PoXiao-Team/CRTC_Smart_Car/README.md

# CRTC_Smart_Car

**破晓战队（PoXiao-Team）· 重庆大学机器人训练大赛 CRTC2026 参赛小车**

四轮麦克纳姆轮底盘 + 前端舵机翻转铲收集机构（**当前过渡：V1 铲 + 塑料箱装载**，见《机械篇》）＋ 阶梯式收纳舱（设计目标）；STM32F103C8T6 主控、DRV8833 驱动、PS2 手柄遥控；视觉采用「虚拟机 Ubuntu 22.04 + ROS2 + OpenCV」+「宿主机 Conda + YOLOv8」双环境方案。**双车方案：1 号车铲子（已实车跑通）、2 号车机械臂（预研）。**

| 关键节点 | 日期 |
| --- | --- |
| 建队 | 2026-09-19 |
| 仓库建立 | 2026-10-10 |
| 实车首次跑通 | 2026-10-14 |
| PCB 原理图冻结 | 2026-10-15 |
| PCB 完成并下单（Gerber 导出） | 2026-10-17 |
| 中期考核视频录制 | 2026-10-18 |
| **中期考核材料截止** | **2026-10-19 24:00** |
| 瑞士轮晋级赛 / 淘汰赛 | 2026-10-24、25、31 / 11-1（手册 V1.6） |

**团队与分工**：破晓战队（PoXiao-Team）

—— 王紫依 队长/机械 ｜ 湛俊锋 电控 ｜ 谭翔珂 电控/硬件 ｜ 刘金昊 视觉 ｜ 蓝朝棣 根据要求灵活调配。

---

## 阅读导航

| 顺序 | 文档 | 内容 | 对象 |
| --- | --- | --- | --- |
| 1 | 本 README | 全景、规范对照、参数与交付状态 | 所有人 |
| 2 | [docs/工程日志.md](docs/工程日志.md) | 主日志：建队至今全部功能的开发历程（功能板块 + 时间线） | 评委 |
| 3 | [docs/机械篇.md](docs/机械篇.md) | 铲子收集机构（V1→V2 迭代）、收纳舱、底盘与行走机构 | 结构设计 |
| 4 | [docs/视觉篇.md](docs/视觉篇.md) | 视觉系统：双环境架构、环境搭建、数据集与训练 | 视觉方案 |
| 5 | [docs/遥控与指令篇.md](docs/遥控与指令篇.md) | 遥控三阶段链路、实际操作手册（PS2 按键 / 铲子示教）、指令协议、失联保护 | 电控设计 |
| 6 | [docs/硬件篇.md](docs/硬件篇.md) | 物资清点、兼容性分析、供电决策、补购清单 | 选型与成本 |
| 7 | [docs/接线规范篇.md](docs/接线规范篇.md) | 面包板 → PCB 电气底稿：引脚表、电源树、网络清单、验收流程 | 接线细节 |
| 8 | [docs/PCB打板篇.md](docs/PCB打板篇.md) | 立创 EDA 打板教程（零基础全流程） | 硬件制作 |
| 9 | [docs/赛事规则解析.md](docs/赛事规则解析.md) | 手册 **V1.6** 规则提取（含 V1.5→V1.6 变更）、工程约束、风险清单 | 规则依据 |
| 10 | [docs/开源项目说明.md](docs/开源项目说明.md) | 开源项目引用、许可证与改动说明 | 合规检查 |
| 附 | [hardware/pcb/README.md](hardware/pcb/README.md) | PCB 设计资料：版本、目录、关键口径 | 硬件制作 |

> 视觉文档自 2026-10-13 起并入 `docs/视觉篇.md`（原 `View-Sense` 分支内容），请在 `docs/` 内查阅，不要再到分支找。

---

## 手册规范对照表

**仓库规范（手册 P10）**

| # | 规范要求 | 我们的做法 | 证据 |
| --- | --- | --- | --- |
| 1 | 仓库名用队伍名称的英文或拼音 | `PoXiao-Team/CRTC_Smart_Car` | 本仓库 |
| 2 | 所有文档放在仓库根目录 `docs/` 下 | 全部 9 篇文档位于 `docs/` | `docs/` 目录树 |
| 3 | 其他目录自解释、一眼看懂；README 给导航与索引 | 本 README 提供阅读导航、参数表与状态表 | 本文件"阅读导航"章 |

**文档规范（手册 P10）**

| # | 规范要求 | 我们的做法 | 证据 |
| --- | --- | --- | --- |
| 1 | 全部文档使用 Markdown 格式 | 9 篇文档均为 `.md` | `docs/` |
| 2 | 内容按机器人设计进度的完成时间点从早到晚 | 《工程日志》按时间从早到晚分板块；分册内按设计顺序 | [docs/工程日志.md](docs/工程日志.md) |
| 3 | 一个机器人功能 = 一个板块 | **功能文档**（《工程日志》及各分册）按"一个功能一个 H2 板块"组织；**资料/教程类分册**（《赛事规则解析》《接线规范篇》《PCB打板篇》《开源项目说明》）按主题章节组织，作为功能板块的依据与支撑 | 各文档标题 |
| 4 | 板块结构：功能名 + 功能描述与开发历程 | 功能板块含「功能描述」「开发历程」两段（资料/教程类分册除外，见上行） | 各文档板块内 ### 小节 |
| 5 | 每篇文档由若干板块组成 | 最短分册（机械篇）含 4 个功能板块 | [docs/机械篇.md](docs/机械篇.md) |
| 6 | 开源项目在文档末尾完整说明 | 独立成篇：《开源项目说明》 | [docs/开源项目说明.md](docs/开源项目说明.md) |

**文档质量标尺（手册 5 分等级对照）**

| # | 标尺要求 | 我们的做法 |
| --- | --- | --- |
| 1 | 不只写"做了什么"，必须写清"为什么这样做" | 关键决策均有选型对比表（如收集机构方案、双环境架构、供电三路线）；难点与排查过程如实记录（机械篇"踩坑"、遥控篇"潜在坑"） |
| 2 | 覆盖"从构思到实现"全过程 | 《工程日志》从建队、方案设计到实车调试的完整时间线 |
| 3 | 未实测内容显式标注 | 全库统一标注 `【待实测】` 与 `【待回填】`；状态用 ✅/🟡/⬜ 三档 |

---

## 技术栈与关键参数

| 类别 | 选型 / 指标 | 状态 |
| --- | --- | --- |
| 底盘 | 四轮麦克纳姆轮（60mm 黄色麦轮 + TT 马达 1:48）＋ 金属折弯底盘，X 形轮组布局 | ✅ 实车跑通（10-14） |
| 收集机构 | 设计：前端舵机翻转铲（V2 弧形滑坡、舵机竖直）＋ 阶梯式收纳舱（目标 12 块）；**当前实物：V1 铲 + 塑料箱装载（临时过渡，3D 打印来不及）** | 🟡 临时过渡装配中（10-18）；V2 铲与成品收纳舱待第二版替换 |
| 主控 | STM32F103C8T6（Micro 焊接款）×2；**固件源码已入库 `firmware/CRTC2026_L1_Fast_Checked/`**（89 项回归测试 PASS） | ✅ 接线完成、实车运行正常 |
| 电机驱动 | DRV8833 红板 ×2（双通道 ×4 电机） | ✅ 实车驱动正常（10-14） |
| 舵机 | SG90 180° ×4（另有 MG995 ×2 待使用【待确认】）；1 号车铲子由 1 个舵机驱动 | ✅ 接线完成、示教-翻铲实车可用（10-17）；**实测行程达不到 180°（略小，具体角度【待实测】）** |
| 遥控 | PS2 无线手柄（已到货）；过渡链路（USB-TTL / HC-05）保留为调试备份 | ✅ 实车连接操控正常（10-14） |
| 视觉 | 虚拟机 Ubuntu 22.04 + ROS2 + OpenCV；宿主机 Conda + YOLOv8（CUDA） | 🟡 软件流程跑通，硬件部署未开始 |
| 供电 | 18650 电池（2 节电池盒）；供电模块额定 ≤7.4V，仅 1 个供电模块；须装官方无线继电器 | 🟡 降压方案（双路 DC-DC：逻辑 5V / 电机 VM 5V）、已实车带载运行；电压参数【待回填】 |
| 硬件载板（PCB） | 自制 V2 底板（100×70mm）：2×DRV8833 + 2×DC-DC + 接口全覆盖；立创 EDA 专业版设计 | ✅ 设计完成并已下单支付（10-17，订单 Y1，¥30/5 片，48h 加急）；等板（预计 10-20 ~ 10-22 到货） |
| 第二台车（机械臂） | 舵机机械臂方案（4 舵机 + 抓手，参考资料预研） | ⬜ 预研，未开始制作 |
| 尺寸 | 初始 ≤290×195×210mm；任意状态 ≤445×400×450mm 或 550mm 球体约束 | ⬜ 待实测 |
| 重量 | ≤2.0kg | ⬜ 待实测 |
| 成本 | 新生组整车 ≤400 元（官方物资表合计 353.48 元，**含两车量**：TT×8、底盘×2、PS2×2 等；单车拆分【待回填】） | 🟡 补购清单见硬件篇 |

## 交付与功能状态

状态口径：✅ 已完成（实测通过）｜🟡 进行中·未验证｜⬜ 待做。对照手册 P9 基础功能考核指标：

| 考核功能 | 状态 | 说明 |
| --- | --- | --- |
| 外形展示 | ✅ 已完成 | 10-18 视频：手持整车多角度 + 局部特写（V1 铲 + 塑料箱，临时过渡） |
| 电机运动（单个 / 全部） | ✅ 已完成 | 实车四电机驱动正常（10-14） |
| 舵机运动（单个 / 多项） | 🟡 部分完成 | 单个：示教-翻铲实车可用（10-17）；**多项：未完成——V1.6 要求"同一台机器人至少三个舵机 + 任意非初始状态保持"**，本车仅 1 路舵机（PB7），且 SG90 实测行程不足 180°（脉宽限幅 600~2000 µs）；指标 5 路径：2 号车机械臂 4×舵机（预研）或 1 号车加装 SG90【待定】 |
| 底盘运动（PS2 遥控） | 🟡 部分完成 | 单个动作实车正常（10-14）；**"多个动作"演示镜头未完成**（10-18 视频缺项，待补拍）；指标 6/7"或给出相关代码"路径**已具备：固件源码入库 `firmware/` + 《遥控与指令篇》协议/操作手册** |
| 尺寸规范 | ✅ 已完成 | 10-18 视频：直立卷尺测高 + 地面横放卷尺测长（约 200mm 级）+ 直尺照片；具体数值【待回填】 |
| 方块携带（单块 / 多块） | ✅ 已完成 | 10-18 视频：黄方块铲取 / 携带长镜头（V1 铲 + 塑料箱，临时过渡） |
| 结构稳定性（180mm 跌落） | ✅ 已完成 | 10-18 视频（落地镜头见素材；展示车与其他项目一致） |
| 规划与采购单 | 🟡 进行中 | 选型分析与采购优先级见《硬件篇》；整机成本预算表已建、合计【待回填】 |

---

## 目录结构

```
CRTC_Smart_Car/
├── README.md              # 本文件：导航与总览
├── .gitignore             # 构建产物与临时文件规则
├── docs/                  # 全部文档（手册 P10 要求）
│   ├── 工程日志.md          # 主日志：全部功能的开发历程
│   ├── 机械篇.md            # 机械：铲子机构 / 收纳舱 / 底盘
│   ├── 视觉篇.md            # 视觉系统（虚拟机 + 宿主机双环境）
│   ├── 遥控与指令篇.md      # 电控：遥控链路 / 指令协议 / 失联保护
│   ├── 硬件篇.md            # 物资清点 / 兼容性 / 供电决策 / 补购
│   ├── 接线规范篇.md        # 面包板 → PCB 电气底稿（引脚表 / 网络清单）
│   ├── PCB打板篇.md         # 立创 EDA 打板教程（零基础全流程）
│   ├── 赛事规则解析.md      # 手册 V1.6 规则提取与风险清单
│   └── 开源项目说明.md      # 开源引用、许可证与改动说明
├── hardware/              # 硬件设计资料
│   └── pcb/               # 底板 PCB（版本、目录与口径见该目录 README.md）
│       ├── CRTC2026_SmartCar_BaseBoard_V2/  # 当前版本：sch / pcb / panel / gerber（16 文件包）
│       ├── CRTC2026_SmartCar_BaseBoard_V1/  # 历史版本（原理图冻结、布局弃用）
│       ├── design/                          # V1 设计数据源脚本 + out/ 8 个产物
│       ├── CRTC.elib                        # 自建元件库
│       └── V2设计方案-实物对照版.html        # V2 设计依据（10-16 审查版）
└── firmware/              # 嵌入式固件（STM32F103C8T6）
    └── CRTC2026_L1_Fast_Checked/  # CubeIDE 工程：Core 源码 + tests（89 项回归）+ BUILD_INFO
```

## 外部资料与入库规划

机械 CAD、3D 打印件、立创 EDA 工程等大体积资料暂不在本仓库，引用路径与入库规划如下：

| 资料 | 当前位置 | 规划 |
| --- | --- | --- |
| 立创 EDA 工程与设计产物（原理图 / PCB / 面板 / BOM / 网表） | ✅ 已入库 `hardware/pcb/`（**25 个文件，约 4MB**，2026-10-18 复核：V2 工程 + Gerber、V1 设计产物与脚本、V2 设计依据 HTML） | 随设计更新继续提交 |
| 机械 CAD（Fusion 360）与打印件 STL/STEP | 机械组本地（未入库） | 入库 `hardware/cad/`、`hardware/prints/`；大文件用 Git LFS 或 Release 附件外链 |
| 3D 打印件照片、实物测量照片 | 待拍摄（未入库） | 入库 `hardware/photos/`（照片压缩后体积小，可直接入库） |
| 视觉数据集与模型权重 | 开发机本地（未入库） | 权重 `best.pt` 建议随「模型发布说明」外链，数据集不入库 |

> 大二进制文件（>10MB）一律不进 Git 历史；确需入库时使用 Git LFS。`.gitignore` 已管住构建产物、训练输出与临时文件。

## 中期考核提交要求（备忘）

- 截止：**2026-10-19 24:00**（北京时间）；
- 邮件：主题「队伍名称 队长姓名」，正文罗列完成的考核指标 + 本仓库地址；
- 视频：`.mp4`、≥1080p、≥30 帧，打包 `.zip`，命名「实训战队名称 队伍名称 队长姓名」；
- 文档评估占 30%，对照本 README 第一部分自查。

---

> 手册条款对照：本文件满足仓库规范 §1（仓库名）、§3（README 提供导航与索引）；文档规范 §1（Markdown）。
