PoXiao-Team/CRTC_Smart_Car/hardware/pcb/README.md

# hardware/pcb — 底板 PCB 设计

> 自制载板 **CRTC2026_SmartCar_BaseBoard** 的设计资料。目标：STM32 开发板、2×DRV8833 红板、2×DC-DC mini、PS2 接收器、SG90 舵机、马达与电池全部经板载接口连接；消除面包板接触不良、模块可拔换、对齐手册 P7"建议采用集成电路板、纯杜邦线易脱落"的结构规范。

## 版本

| 版本 | 状态 | 说明 |
| --- | --- | --- |
| **V2（当前）** | ✅ 设计完成并已下单（2026-10-17） | 板框 100×70mm；原理图 + PCB + Gerber 齐全；等板中 |
| V1（历史） | 🗄 已归档 | 2026-10-15 原理图冻结（22 元件 / 29 网络）；布局阶段受阻后转 V2（原因见《工程日志》"硬件打板与 PCB 设计"板块） |

## 目录

| 路径 | 内容 |
| --- | --- |
| `CRTC2026_SmartCar_BaseBoard_V2/` | V2 立创 EDA 工程（原理图 / PCB / 面板）+ `gerber/Gerber_PCB1_2026-10-17.zip`（16 文件：铜箔/丝印/阻焊/板框/钻孔/飞针测试） |
| `CRTC2026_SmartCar_BaseBoard_V1/` | V1 立创 EDA 工程（历史版本） |
| `CRTC.elib` | 自建元件库（DRV8833 16 脚 / mini 降压 4 脚 / STM32 核心板 40 脚等符号与封装） |
| `design/` | V1 设计单一数据源脚本与产物：BOM.csv、NETLIST.csv、接线表.md、布局坐标.csv、线宽与电流预算.md、装配核对表.md、施工单.html、ERC报告.txt（**历史口径**：主干 100mil + 补强策略；V2 实际为 1.0mm 主干 + 双面 GND 铺铜，见《工程日志》） |
| `V2设计方案-实物对照版.html` | V2 设计依据存档（12 模块逐脚表 + 29 网总表 + 审查检查单；10-16 审查版，最终取舍以《工程日志》10-17 为准） |
| `*/sch/ · */pcb/ · */panel/` | 立创 EDA 工程子目录（原理图 / PCB / 拼板） |
| 两份 `*/eprj3-intro.md` | 立创 EDA 上游格式说明（两份内容相同，无项目信息） |

## 状态（2026-10-18）

- ✅ V2 原理图：DRC 0 错（+5V/VCC 短接、VM 误接、信号配对等 8 项审查问题已全部修正）
- ✅ V2 PCB：板框 **100×70mm**（R3 圆角）+ 4×M3 孔（孔径 3.2 / 外径约 6mm / 距边 3.8mm）；双面铺 GND；**飞线 0、DRC 0**
- ✅ Gerber 导出（2026-10-17 15:23），16 个文件齐全
- ✅ 下单：2026-10-17 16:25（订单 **Y1**，16:27 支付；¥30.00 / 5 片，2 层 / 1.6mm / FR-4 / 1oz / 绿油白字 / 有铅喷锡；48h 免费加急，预计 10-19 晚发货，顺丰电商标快）；等板中
- ⬜ **V2 配套产物缺口**：V2 的 BOM / 网表 / 接线表 / 装配核对表尚未生成（`design/` 产物为 **V1 历史口径**，含 J2–J5、C1–C6、92×72，**收板装配不可照抄**）；收板前核对按《接线规范篇》§7 + V2设计方案 HTML 检查单执行；V2 产物待从工程导出后补
- ⬜ 收板后焊接装配（10-20 ~ 10-22，按《接线规范篇》第 7 节流程）

## 关键口径

- VM 设计值 = **5.0V**（DC-DC 电机路输出；设 6V 时电池后半程压差不足会不稳压）
- PB3/PB4 为 JTAG 复用脚：固件须关 JTAG 保 SWD（`__HAL_AFIO_REMAP_SWJ_NOJTAG()`）
- DRV8833 的 STBY 接 B12、不得悬空；TIM1 须使能 MOE；TIM3 禁部分重映射
- V2 取舍：马达线直焊驱动模块输出针（无端子）；本版无去耦电容（装车后视情况补）

## 相关文档

- [docs/接线规范篇.md](../../docs/接线规范篇.md) — 面包板 → PCB 电气底稿（引脚表 / 电源树 / 网络清单 / 上电验收）
- [docs/PCB打板篇.md](../../docs/PCB打板篇.md) — 立创 EDA 零基础全流程教程
- [docs/工程日志.md](../../docs/工程日志.md) — "硬件打板与 PCB 设计（2026-10-15 ~ 10-17）"板块
