PoXiao-Team/CRTC_Smart_Car/hardware/pcb/design/out/线宽与电流预算.md

# 电流预算与走线宽度（CRTC2026_SmartCar_BaseBoard V1）

线宽按 IPC-2221 外层、铜厚 1.0 oz、温升 10℃ 计算；采用值取「常态/峰值两者较大」、向上取整到 10mil、不低于板级最小线宽 10 mil，并封顶 100 mil（单根走线的实用上限）。

| 网络 | 说明 | 常态(A) | 峰值(A) | 常态线宽(mil) | 峰值线宽(mil) | 采用线宽(mil) | 备注 |
|---|---|---:|---:|---:|---:|---:|---|
| `VBAT` | 电池 → 两块 mini 的输入（全车总电流入口） | 2.00 | 6.50 | 30.8 | 156.5 | **100** | 2S 电池，7.0～8.4V；此网电流 = +5V 路 + VM 路之和 |
| `+5V` | mini#1 输出 → STM32 核心板 5V 脚（核心板 LDO 再出 3.3V 给 PS2） | 0.15 | 0.30 | 0.9 | 2.2 | **10** | 核心板 ≈50mA + PS2 ≈10mA + 余量；不得再挂马达/舵机 |
| `+3V3` | STM32 核心板板载 LDO 输出 → PS2 接收器 VCC | 0.05 | 0.10 | 0.2 | 0.5 | **10** | 核心板 LDO 能力有限（≈300mA），只带 PS2 |
| `VM` | mini#2 输出 → DRV#1/#2 的 VM + 舵机 V + 储能电容 | 2.00 | 5.50 | 30.8 | 124.3 | **100** | 4×TT 马达常态约 1.5A、堵转约 5A，SG90 峰值约 0.5A；mini 模块额定按 1.8A 计 → 常态已贴近上限，见风险 R3 |
| `MOTOR_x` | 单路马达输出（DRV8833 AO/BO → 马达端子） | 0.60 | 1.50 | 5.8 | 20.7 | **30** | 单通道持续 1.0A 以内是安全的；堵转由软件限流保护 |

### 需要补强的网络（峰值超过单根走线实用上限）

- `VBAT`：峰值需 156 mil 单线（超出实用上限），改用：铺铜区域 + 双面并走（每层 100 mil）+ 大电流段开窗加锡，等效截面积 ≥ 215 mil²
- `VM`：峰值需 124 mil 单线（超出实用上限），改用：铺铜区域 + 双面并走（每层 100 mil）+ 大电流段开窗加锡，等效截面积 ≥ 171 mil²

## 执行要点

1. `VM` / `VBAT` / `GND` 三根主干按上表**采用线宽**走（100 mil），双面并行 + 过孔缝合；换层处至少 4 个过孔。
2. 上表中需要补强的网络，按「铺铜区域 + 双面并走 + 大电流段开窗加锡」处理，不要试图用一根 100 mil 以上的单线硬扛。
3. 马达输出走线不低于 30 mil（单路峰值 1.5A）。
4. 信号线（8 路 PWM、PS2、舵机、STBY）按板级最小线宽 10 mil 起步，同组信号平行等距、不与功率线混行。
5. 拐角一律 45°，禁止直角；焊盘与走线连接处加泪滴；顶底层均铺 GND 铜，间距 8 mil，孤岛必须处理。

## 风险 R3：VM 路供电能力

mini 降压模块额定按 1.8A 计；VM 路常态 2.0A、峰值 5.5A。

- **对策 A（推荐）**：mini#2 换成持续输出 ≥3A 的降压模块（成本增加约 5～10 元）；
- **对策 B**：舵机改由第三块 mini（或核心板 5V 经独立 5V 稳压）供电；
- **对策 C**：软件限流（启动缓升、堵转检测降占空比）+ C1/C2 储能电容（已设计进本版）；
- 三策可叠加。（历史记录：V1 阶段要求“在选型确认前不要下单”整板；**V2 已于 10-17 完成选型取舍并下单——订单 Y1**，见《工程日志》。）
