PoXiao-Team/CRTC_Smart_Car/hardware/pcb/design/out/接线表.md

# CRTC2026_SmartCar_BaseBoard V1 · 接线表（引脚级）

> 本表由 `crtc_baseboard_v1.py` 自动生成，改动请改源文件后重跑，不要手改本表。
> 原理图连线与网络命名**全部照抄**本表；同名即同网，拼错一个字就是一条断线。

## 0. 板级参数

| 项 | 值 |
|---|---|
| 板框 | 92 × 72 mm（圆角 R3） |
| 层数 / 板厚 / 铜厚 | 2 层 / 1.6mm / 1.0 oz |
| 最小线宽 / 过孔 | 10 mil / 24-12 mil |
| 丝印 | 线宽 6 mil，字高 45 mil |
| 安装孔 | M3，孔径 3.2mm，四角 |
| 铺铜 | 顶层 + 底层全铺 GND，间距 8 mil |

## 1. 按模块接线

### J1 · 电池/继电器输入端子

- 封装：`KF301-2P`　做法：板边，接线口朝板外

| 引脚 | 网络 | 说明 |
|---|---|---|
| BAT+ | `VBAT` | 电池正（经官方无线继电器）→ 两块 mini 输入；7.0～8.4V |
| BAT- | `GND` | 全板唯一地网（不得出现 VSS / GNDA / AGND 等别名）；铺铜网络 |

### U1 · mini 降压模块 #1（+5V 路）

- 封装：`1x4 排母 2.54mm`　做法：排母插座；模块为四角焊盘（2×2，无插针），用 4 根短线焊到排母上进行连接

| 引脚 | 网络 | 说明 |
|---|---|---|
| IN+ | `VBAT` | 电池正（经官方无线继电器）→ 两块 mini 输入；7.0～8.4V |
| IN- | `GND` | 全板唯一地网（不得出现 VSS / GNDA / AGND 等别名）；铺铜网络 |
| OUT+ | `+5V` | 只给核心板与调试口，禁止挂马达/舵机 |
| OUT- | `GND` | 全板唯一地网（不得出现 VSS / GNDA / AGND 等别名）；铺铜网络 |

### U2 · mini 降压模块 #2（VM 路）

- 封装：`1x4 排母 2.54mm`　做法：排母插座；模块为四角焊盘（2×2，无插针），用 4 根短线焊到排母上进行连接

| 引脚 | 网络 | 说明 |
|---|---|---|
| IN+ | `VBAT` | 电池正（经官方无线继电器）→ 两块 mini 输入；7.0～8.4V |
| IN- | `GND` | 全板唯一地网（不得出现 VSS / GNDA / AGND 等别名）；铺铜网络 |
| OUT+ | `VM` | mini#2 输出 5.0V；严禁与 VBAT 有任何连接；走线按最宽处理 |
| OUT- | `GND` | 全板唯一地网（不得出现 VSS / GNDA / AGND 等别名）；铺铜网络 |

### U3A · STM32 核心板排母 · 左列（20 脚，自上而下）

- 封装：`1x20 排母 2.54mm`　做法：排母插座，核心板直插；1 号脚靠 USB 端

| 脚号 | 丝印 | 网络 | 说明 |
|---|---|---|---|
| 1 | B12 | `DRV_STBY` | 三点同网；高电平使能，内部 500kΩ 下拉 → MCU 未初始化时电机不转（安全） |
| 2 | B13 | `—` | 不连接（NC，悬空） |
| 3 | B14 | `—` | 不连接（NC，悬空） |
| 4 | B15 | `—` | 不连接（NC，悬空） |
| 5 | A8 | `DRV_F_AIN2` | TIM1_CH1；PA8（TIM1 必须开 MOE 才有输出） |
| 6 | A9 | `DRV_F_BIN2` | TIM1_CH2；PA9 |
| 7 | A10 | `DRV_R_AIN2` | TIM1_CH3；PA10 |
| 8 | A11 | `DRV_R_BIN2` | TIM1_CH4；PA11 |
| 9 | A12 | `—` | 不连接（NC，悬空） |
| 10 | A15 | `—` | 不连接（NC，悬空） |
| 11 | B3 | `PS2_CS` | PB3 默认 JTAG(JTDO)，必须关 JTAG 保 SWD 才能当普通 IO |
| 12 | B4 | `PS2_CLK` | PB4 默认 JTAG(NJTRST)，同上；且必须禁用 TIM3 部分重映射 |
| 13 | B5 | `PS2_CMD` | 软件 SPI，主出 |
| 14 | B6 | `PS2_DAT` | 软件 SPI，主入 |
| 15 | B7 | `SRV_PWM` | TIM4_CH2，50Hz（周期 20ms，脉宽 0.5～2.5ms） |
| 16 | B8 | `—` | 不连接（NC，悬空） |
| 17 | B9 | `—` | 不连接（NC，悬空） |
| 18 | 5V | `+5V` | 只给核心板与调试口，禁止挂马达/舵机 |
| 19 | G | `GND` | 全板唯一地网（不得出现 VSS / GNDA / AGND 等别名）；铺铜网络 |
| 20 | 3V3 | `+3V3` | 由核心板板载 LDO 提供，只带 PS2 接收器 |

- 不连接（NC）脚：B13, B14, B15, A12, A15, B8, B9 —— 实物左列自上而下：B12、B13、B14、B15、A8、A9、A10、A11、A12、A15、B3、B4、B5、B6、B7、B8、B9、5V、G、3.3 —— 丝印缩略名 B12=PB12、A8=PA8；B3/B4 是 JTAG 复用脚（固件须关 JTAG 保 SWD）

### U3B · STM32 核心板排母 · 右列（20 脚，自上而下）

- 封装：`1x20 排母 2.54mm`　做法：排母插座，核心板直插；1 号脚靠 USB 端

| 脚号 | 丝印 | 网络 | 说明 |
|---|---|---|---|
| 1 | G1 | `GND` | 全板唯一地网（不得出现 VSS / GNDA / AGND 等别名）；铺铜网络 |
| 2 | G2 | `GND` | 全板唯一地网（不得出现 VSS / GNDA / AGND 等别名）；铺铜网络 |
| 3 | 3V3 | `+3V3` | 由核心板板载 LDO 提供，只带 PS2 接收器 |
| 4 | RES | `—` | 不连接（NC，悬空） |
| 5 | B11 | `—` | 不连接（NC，悬空） |
| 6 | B10 | `—` | 不连接（NC，悬空） |
| 7 | B1 | `DRV_R_BIN1` | TIM3_CH4；PB1 |
| 8 | B0 | `DRV_R_AIN1` | TIM3_CH3；PB0 |
| 9 | A7 | `DRV_F_BIN1` | TIM3_CH2；PA7 |
| 10 | A6 | `DRV_F_AIN1` | TIM3_CH1；PA6 |
| 11 | A5 | `—` | 不连接（NC，悬空） |
| 12 | A4 | `—` | 不连接（NC，悬空） |
| 13 | A3 | `DBG_RX` | USART2_RX |
| 14 | A2 | `DBG_TX` | USART2_TX |
| 15 | A1 | `—` | 不连接（NC，悬空） |
| 16 | A0 | `—` | 不连接（NC，悬空） |
| 17 | C15 | `—` | 不连接（NC，悬空） |
| 18 | C14 | `—` | 不连接（NC，悬空） |
| 19 | C13 | `—` | 不连接（NC，悬空） |
| 20 | VB | `—` | 不连接（NC，悬空） |

- 不连接（NC）脚：RES, B11, B10, A5, A4, A1, A0, C15, C14, C13, VB —— 实物右列自上而下：G、G、3.3、RES、B11、B10、B1、B0、A7、A6、A5、A4、A3、A2、A1、A0、C15、C14、C13、VB —— RES 为复位脚、VB 为 VBAT 脚，本设计均不接；两处 G 都要接 GND

### U4A · DRV8833 #1 模块座 · 左列（控制/使能侧）

- 封装：`1x8 排母 2.54mm`　做法：排母插座，模块直插；与 U4B 平行，列距按实测（默认 10.16mm）

| 脚号 | 丝印 | 网络 | 说明 |
|---|---|---|---|
| 1 | NC1 | `—` | 不连接（NC，悬空） |
| 2 | AIN2 | `DRV_F_AIN2` | TIM1_CH1；PA8（TIM1 必须开 MOE 才有输出） |
| 3 | AIN1 | `DRV_F_AIN1` | TIM3_CH1；PA6 |
| 4 | STBY | `DRV_STBY` | 三点同网；高电平使能，内部 500kΩ 下拉 → MCU 未初始化时电机不转（安全） |
| 5 | BIN1 | `DRV_F_BIN1` | TIM3_CH2；PA7 |
| 6 | BIN2 | `DRV_F_BIN2` | TIM1_CH2；PA9 |
| 7 | NC2 | `—` | 不连接（NC，悬空） |
| 8 | GND1 | `GND` | 全板唯一地网（不得出现 VSS / GNDA / AGND 等别名）；铺铜网络 |

- 不连接（NC）脚：NC1, NC2 —— 实物左列自上而下：NC、AIN2、AIN1、STBY、BIN1、BIN2、NC、GND —— 两个 NC 脚（第 1、7 位）悬空不接；第 8 位 GND 必须接 GND 网

### U4B · DRV8833 #1 模块座 · 右列（电源/输出侧）

- 封装：`1x8 排母 2.54mm`　做法：排母插座，模块直插；VM 与两处 GND 都要接（大电流）

| 脚号 | 丝印 | 网络 | 说明 |
|---|---|---|---|
| 1 | VM | `VM` | mini#2 输出 5.0V；严禁与 VBAT 有任何连接；走线按最宽处理 |
| 2 | NC3 | `—` | 不连接（NC，悬空） |
| 3 | GND2 | `GND` | 全板唯一地网（不得出现 VSS / GNDA / AGND 等别名）；铺铜网络 |
| 4 | AO1 | `MOTOR_FL_1` | 左前马达脚 1 |
| 5 | AO2 | `MOTOR_FL_2` | 左前马达脚 2 |
| 6 | BO2 | `MOTOR_FR_2` | 右前马达脚 2 |
| 7 | BO1 | `MOTOR_FR_1` | 右前马达脚 1 |
| 8 | GND3 | `GND` | 全板唯一地网（不得出现 VSS / GNDA / AGND 等别名）；铺铜网络 |

- 不连接（NC）脚：NC3 —— 实物右列自上而下：VM、NC、GND、AO1、AO2、BO2、BO1、GND —— 注意 BO2 在 BO1 **上方**；VM 单脚要并线加粗，两处 GND 都接到 GND 网

### U5A · DRV8833 #2 模块座 · 左列（控制/使能侧）

- 封装：`1x8 排母 2.54mm`　做法：排母插座，模块直插；与 U5B 平行，列距按实测（默认 10.16mm）

| 脚号 | 丝印 | 网络 | 说明 |
|---|---|---|---|
| 1 | NC1 | `—` | 不连接（NC，悬空） |
| 2 | AIN2 | `DRV_R_AIN2` | TIM1_CH3；PA10 |
| 3 | AIN1 | `DRV_R_AIN1` | TIM3_CH3；PB0 |
| 4 | STBY | `DRV_STBY` | 三点同网；高电平使能，内部 500kΩ 下拉 → MCU 未初始化时电机不转（安全） |
| 5 | BIN1 | `DRV_R_BIN1` | TIM3_CH4；PB1 |
| 6 | BIN2 | `DRV_R_BIN2` | TIM1_CH4；PA11 |
| 7 | NC2 | `—` | 不连接（NC，悬空） |
| 8 | GND1 | `GND` | 全板唯一地网（不得出现 VSS / GNDA / AGND 等别名）；铺铜网络 |

- 不连接（NC）脚：NC1, NC2 —— 同 U4A；模块丝印可能是 STBY 或 SLP，都接 DRV_STBY

### U5B · DRV8833 #2 模块座 · 右列（电源/输出侧）

- 封装：`1x8 排母 2.54mm`　做法：排母插座，模块直插；VM 与两处 GND 都要接

| 脚号 | 丝印 | 网络 | 说明 |
|---|---|---|---|
| 1 | VM | `VM` | mini#2 输出 5.0V；严禁与 VBAT 有任何连接；走线按最宽处理 |
| 2 | NC3 | `—` | 不连接（NC，悬空） |
| 3 | GND2 | `GND` | 全板唯一地网（不得出现 VSS / GNDA / AGND 等别名）；铺铜网络 |
| 4 | AO1 | `MOTOR_RL_1` | 左后马达脚 1 |
| 5 | AO2 | `MOTOR_RL_2` | 左后马达脚 2 |
| 6 | BO2 | `MOTOR_RR_1` | 右后马达脚 1（镜像接法：接 BO2） |
| 7 | BO1 | `MOTOR_RR_2` | 右后马达脚 2（镜像接法：接 BO1） |
| 8 | GND3 | `GND` | 全板唯一地网（不得出现 VSS / GNDA / AGND 等别名）；铺铜网络 |

- 不连接（NC）脚：NC3 —— 同 U4B；BO1/BO2 到端子的接法见 MOTOR_RR_1/_2（镜像）

### C1 · VM 储能电容 #1（紧贴 U4）

- 封装：`CAP-TH_D6.3xH11.0_P2.50`　做法：直插，紧贴 U4 的 VM-GND，丝印画 +

| 引脚 | 网络 | 说明 |
|---|---|---|
| + | `VM` | mini#2 输出 5.0V；严禁与 VBAT 有任何连接；走线按最宽处理 |
| - | `GND` | 全板唯一地网（不得出现 VSS / GNDA / AGND 等别名）；铺铜网络 |

### C2 · VM 储能电容 #2（紧贴 U5）

- 封装：`CAP-TH_D6.3xH11.0_P2.50`　做法：直插，紧贴 U5 的 VM-GND，丝印画 +

| 引脚 | 网络 | 说明 |
|---|---|---|
| + | `VM` | mini#2 输出 5.0V；严禁与 VBAT 有任何连接；走线按最宽处理 |
| - | `GND` | 全板唯一地网（不得出现 VSS / GNDA / AGND 等别名）；铺铜网络 |

### C3 · +5V 输出滤波电容

- 封装：`CAP-TH_D5.0xH11.0_P2.00`　做法：直插，靠近 U1 的 OUT+ / OUT-

| 引脚 | 网络 | 说明 |
|---|---|---|
| + | `+5V` | 只给核心板与调试口，禁止挂马达/舵机 |
| - | `GND` | 全板唯一地网（不得出现 VSS / GNDA / AGND 等别名）；铺铜网络 |

### C4 · VM 高频去耦电容

- 封装：`CAP-TH_D4.3xH11.0_P5.08`　做法：直插，跨在 VM-GND 上（与 C1/C2 并联）

| 引脚 | 网络 | 说明 |
|---|---|---|
| 1 | `VM` | mini#2 输出 5.0V；严禁与 VBAT 有任何连接；走线按最宽处理 |
| 2 | `GND` | 全板唯一地网（不得出现 VSS / GNDA / AGND 等别名）；铺铜网络 |

### C5 · +5V 高频去耦电容

- 封装：`CAP-TH_D4.3xH11.0_P5.08`　做法：直插，跨在 +5V-GND 上

| 引脚 | 网络 | 说明 |
|---|---|---|
| 1 | `+5V` | 只给核心板与调试口，禁止挂马达/舵机 |
| 2 | `GND` | 全板唯一地网（不得出现 VSS / GNDA / AGND 等别名）；铺铜网络 |

### C6 · VBAT 输入储能电容

- 封装：`CAP-TH_D6.3xH11.0_P2.50`　做法：直插，靠近 J1 与两块 mini 的 IN

| 引脚 | 网络 | 说明 |
|---|---|---|
| + | `VBAT` | 电池正（经官方无线继电器）→ 两块 mini 输入；7.0～8.4V |
| - | `GND` | 全板唯一地网（不得出现 VSS / GNDA / AGND 等别名）；铺铜网络 |

### J2 · 左前马达端子 FL

- 封装：`KF301-2P`　做法：板下边缘，接线口朝板外

| 引脚 | 网络 | 说明 |
|---|---|---|
| 1 | `MOTOR_FL_1` | 左前马达脚 1 |
| 2 | `MOTOR_FL_2` | 左前马达脚 2 |

### J3 · 右前马达端子 FR

- 封装：`KF301-2P`　做法：板下边缘，接线口朝板外

| 引脚 | 网络 | 说明 |
|---|---|---|
| 1 | `MOTOR_FR_1` | 右前马达脚 1 |
| 2 | `MOTOR_FR_2` | 右前马达脚 2 |

### J4 · 左后马达端子 RL

- 封装：`KF301-2P`　做法：板下边缘，接线口朝板外

| 引脚 | 网络 | 说明 |
|---|---|---|
| 1 | `MOTOR_RL_1` | 左后马达脚 1 |
| 2 | `MOTOR_RL_2` | 左后马达脚 2 |

### J5 · 右后马达端子 RR

- 封装：`KF301-2P`　做法：板下边缘，接线口朝板外

| 引脚 | 网络 | 说明 |
|---|---|---|
| 1 | `MOTOR_RR_1` | 右后马达脚 1（镜像接法：接 BO2） |
| 2 | `MOTOR_RR_2` | 右后马达脚 2（镜像接法：接 BO1） |

### J6 · 舵机接口 SG90

- 封装：`HDR-TH_1x3_P2.54`　做法：板右边缘，针朝上；杜邦线直插

| 脚号 | 丝印 | 网络 | 说明 |
|---|---|---|---|
| 1 | S | `SRV_PWM` | TIM4_CH2，50Hz（周期 20ms，脉宽 0.5～2.5ms） |
| 2 | V | `VM` | mini#2 输出 5.0V；严禁与 VBAT 有任何连接；走线按最宽处理 |
| 3 | G | `GND` | 全板唯一地网（不得出现 VSS / GNDA / AGND 等别名）；铺铜网络 |

### J7 · PS2 接收器接口

- 封装：`HDR-TH_1x6_P2.54`　做法：板右边缘，针朝上

| 脚号 | 丝印 | 网络 | 说明 |
|---|---|---|---|
| 1 | CS | `PS2_CS` | PB3 默认 JTAG(JTDO)，必须关 JTAG 保 SWD 才能当普通 IO |
| 2 | CMD | `PS2_CMD` | 软件 SPI，主出 |
| 3 | DAT | `PS2_DAT` | 软件 SPI，主入 |
| 4 | CLK | `PS2_CLK` | PB4 默认 JTAG(NJTRST)，同上；且必须禁用 TIM3 部分重映射 |
| 5 | VCC | `+3V3` | 由核心板板载 LDO 提供，只带 PS2 接收器 |
| 6 | GND | `GND` | 全板唯一地网（不得出现 VSS / GNDA / AGND 等别名）；铺铜网络 |

### J8 · 调试扩展口（USART2）

- 封装：`HDR-TH_1x4_P2.54`　做法：板右边缘，针朝上

| 脚号 | 丝印 | 网络 | 说明 |
|---|---|---|---|
| 1 | TX | `DBG_TX` | USART2_TX |
| 2 | RX | `DBG_RX` | USART2_RX |
| 3 | +5V | `+5V` | 只给核心板与调试口，禁止挂马达/舵机 |
| 4 | GND | `GND` | 全板唯一地网（不得出现 VSS / GNDA / AGND 等别名）；铺铜网络 |

## 2. 按网络反查

| 网络 | 类别 | 端点 | 建议线宽 | 说明 |
|---|---|---|---|---|
| `VBAT` | 电源 | J1.BAT+、U1.IN+、U2.IN+、C6.+ | 100 mil | 电池正（经官方无线继电器）→ 两块 mini 输入；7.0～8.4V；峰值需 156 mil 单线（超出实用上限），改用：铺铜区域 + 双面并走（每层 100 mil）+ 大电流段开窗加锡，等效截面积 ≥ 215 mil² |
| `GND` | 电源 | J1.BAT-、U1.IN-、U1.OUT-、U2.IN-、U2.OUT-、U3A.G、U3B.G1、U3B.G2、U4A.GND1、U4B.GND2、U4B.GND3、U5A.GND1、U5B.GND2、U5B.GND3、C1.-、C2.-、C3.-、C4.2、C5.2、C6.-、J6.G、J7.GND、J8.GND | 100 mil | 全板唯一地网（不得出现 VSS / GNDA / AGND 等别名）；铺铜网络；峰值需 156 mil 单线（超出实用上限），改用：铺铜区域 + 双面并走（每层 100 mil）+ 大电流段开窗加锡，等效截面积 ≥ 215 mil² |
| `+5V` | 电源 | U1.OUT+、U3A.5V、C3.+、C5.1、J8.+5V | 10 mil | 只给核心板与调试口，禁止挂马达/舵机 |
| `+3V3` | 电源 | U3A.3V3、U3B.3V3、J7.VCC | 10 mil | 由核心板板载 LDO 提供，只带 PS2 接收器 |
| `VM` | 电源 | U2.OUT+、U4B.VM、U5B.VM、J6.V、C1.+、C2.+、C4.1 | 100 mil | mini#2 输出 5.0V；严禁与 VBAT 有任何连接；走线按最宽处理；峰值需 124 mil 单线（超出实用上限），改用：铺铜区域 + 双面并走（每层 100 mil）+ 大电流段开窗加锡，等效截面积 ≥ 171 mil² |
| `DRV_F_AIN1` | 信号 | U3B.A6、U4A.AIN1 | 10 mil | TIM3_CH1；PA6 |
| `DRV_F_BIN1` | 信号 | U3B.A7、U4A.BIN1 | 10 mil | TIM3_CH2；PA7 |
| `DRV_F_AIN2` | 信号 | U3A.A8、U4A.AIN2 | 10 mil | TIM1_CH1；PA8（TIM1 必须开 MOE 才有输出） |
| `DRV_F_BIN2` | 信号 | U3A.A9、U4A.BIN2 | 10 mil | TIM1_CH2；PA9 |
| `DRV_R_AIN1` | 信号 | U3B.B0、U5A.AIN1 | 10 mil | TIM3_CH3；PB0 |
| `DRV_R_BIN1` | 信号 | U3B.B1、U5A.BIN1 | 10 mil | TIM3_CH4；PB1 |
| `DRV_R_AIN2` | 信号 | U3A.A10、U5A.AIN2 | 10 mil | TIM1_CH3；PA10 |
| `DRV_R_BIN2` | 信号 | U3A.A11、U5A.BIN2 | 10 mil | TIM1_CH4；PA11 |
| `DRV_STBY` | 信号 | U3A.B12、U4A.STBY、U5A.STBY | 10 mil | 三点同网；高电平使能，内部 500kΩ 下拉 → MCU 未初始化时电机不转（安全） |
| `PS2_DAT` | 信号 | U3A.B6、J7.DAT | 10 mil | 软件 SPI，主入 |
| `PS2_CMD` | 信号 | U3A.B5、J7.CMD | 10 mil | 软件 SPI，主出 |
| `PS2_CS` | 信号 | U3A.B3、J7.CS | 10 mil | PB3 默认 JTAG(JTDO)，必须关 JTAG 保 SWD 才能当普通 IO |
| `PS2_CLK` | 信号 | U3A.B4、J7.CLK | 10 mil | PB4 默认 JTAG(NJTRST)，同上；且必须禁用 TIM3 部分重映射 |
| `SRV_PWM` | 信号 | U3A.B7、J6.S | 10 mil | TIM4_CH2，50Hz（周期 20ms，脉宽 0.5～2.5ms） |
| `DBG_TX` | 信号 | U3B.A2、J8.TX | 10 mil | USART2_TX |
| `DBG_RX` | 信号 | U3B.A3、J8.RX | 10 mil | USART2_RX |
| `MOTOR_FL_1` | 输出 | U4B.AO1、J2.1 | 30 mil | 左前马达脚 1 |
| `MOTOR_FL_2` | 输出 | U4B.AO2、J2.2 | 30 mil | 左前马达脚 2 |
| `MOTOR_FR_1` | 输出 | U4B.BO1、J3.1 | 30 mil | 右前马达脚 1 |
| `MOTOR_FR_2` | 输出 | U4B.BO2、J3.2 | 30 mil | 右前马达脚 2 |
| `MOTOR_RL_1` | 输出 | U5B.AO1、J4.1 | 30 mil | 左后马达脚 1 |
| `MOTOR_RL_2` | 输出 | U5B.AO2、J4.2 | 30 mil | 左后马达脚 2 |
| `MOTOR_RR_1` | 输出 | U5B.BO2、J5.1 | 30 mil | 右后马达脚 1（镜像接法：接 BO2） |
| `MOTOR_RR_2` | 输出 | U5B.BO1、J5.2 | 30 mil | 右后马达脚 2（镜像接法：接 BO1） |
