PoXiao-Team/CRTC_Smart_Car/docs/赛事规则解析.md

# 赛事规则解析

> 破晓战队 CRTC2026 参赛小车规则基线文档。本文为**规则资料篇**：为《工程日志》《机械篇》《视觉篇》《遥控与指令篇》《硬件篇》各功能板块提供规则依据与数据口径；机器人功能板块本身见上述各篇。
> 状态标注约定：✅ 已完成（实测通过）｜🟡 进行中·未验证｜⬜ 待做；未实测内容显式标注【待实测】。

依据《2026CRTC 参赛手册 **V1.6**》（25 页；V1.5 基线，V1.6 差异见 §0）。标注格式为 `P页码/章节号`。手册未明确说明的内容标注为待确认，不自行补充。

---

## 0. 版本变更记录

**V1.6 相对 V1.5**（2026-10-19，依据手册 V1.6 版本记录页）：

| 变更 | V1.5 | V1.6 | 影响 |
| --- | --- | --- | --- |
| 比赛日程（1.5） | 瑞士轮 10-24、25；淘汰赛 10-31 | **瑞士轮 10-24、25、31；淘汰赛 11-1** | 备赛窗口延长一周；本文档赛程已更新 |
| 完成度测评（4.1） | 措辞较含糊 | 补充：外形"携带能量单元"、电机（全部）"不少于 4 个"、舵机（多项）"至少三个舵机 + 任意非初始状态保持"、结构稳定"展示车须与其他项目一致"；4.1.1 措辞勘误 | 指标判据更明确 |
| 进阶功能材料 | 未列材料要求 | **文档材料（描述进阶功能）+ 视频材料（展示）；视频未展示文档所述功能即视为未完成** | 若申报进阶功能须双材料 |
| 测评入口 | 无 | 新增 `https://i.kaoshiyun.com.cn/v5/exam/781c306` | 规则测评走该入口 |
| 淘汰赛规则（5.2） | 平局则加赛至 2 胜 | **平局视为该场双方均失败**；积分 -0.5、进攻方排队尾、防守方积分归零等细则 | 淘汰赛须避免平局 |

## 0.1 V1.5 相对 V1.4 的变更

手册第 21 页更新日志列出 1.5 版改动，其中影响本项目判断的有：

| 变更 | V1.4 | V1.5 | 影响 |
| --- | --- | --- | --- |
| 修正 4.1.2 方块大小 | 写为 40×40×40mm | **30×30×30mm** | V1.4 中 30/40mm 表述不一致的问题解决，确定为 30mm |
| 修改 3.2 遥控器描述 | PS2 手柄，不限自购其他遥控器 | 增加"**或其他控制方案**" | 非 PS2 控制方案被明确允许 |
| 第三章新增开源项目说明 | 无 | 允许使用开源项目，须在中期考核给出完整说明并遵守协议 | 用开源库须在文档末尾说明 |
| 修改 4.3.1 文档规范 | 无 | 使用开源项目的应在文档末尾完整说明 | 文档硬性要求 |
| 更改 4.6 参赛队伍数量 | 新生组前 56 / 非新生组前 8 | 新生组前 **60** / 非新生组前 **4** | — |
| 更改 6.1.7 焦点参数 | 150×150mm 十字基座 | **300×300mm**，矮墙距中心 64.25mm | 焦点附近方块分布范围更大 |
| 新增 2.3.4 培训时间 | 无 | 见下 | — |

统一培训时间（P5/2.3.4）：2026 年 10 月 8、9、10、11 日 19:00–20:40，8、9 日在虎溪 D 区，10、11 日在沙坪坝 A 区。电控组四个板块为 GPIO/PWM、电机与舵机及 FreeRTOS、SPI 与 PS2 手柄、麦轮运动学解算。

开源项目条款原文（P5，V1.5 新增）：

> 将开源项目用于机器人的制作及代码编写是允许的，但必须在中期考核阶段给出完整说明，并遵守所使用开源项目的开源协议。

---

## 1. 比赛任务与目标

| 项目 | 内容 | 依据 |
| --- | --- | --- |
| 赛事性质 | 机器人资源争夺赛 | P2 |
| 核心目标 | 在限定的空间和时间范围内，尽可能多地收集和占有有限的道具资源 | P2 |
| 胜负判定 | 比赛结束时双方道具分数之和高者获胜，相同记为平局 | P2 / P17 |
| 车辆数量 | 每队自行设计开发 1–2 台机器人，可另备不超过 1 台备用机器人 | P2 / P6 |
| 机器人分类 | 一般 / 半自动 / 全自动（全自动需无需操作手且经组委会审查），三类均可参赛 | P6 / 3.1 |
| 得分加成 | 全自动：能量单元 ×2、核心 ×1.5；半自动：×1.5、×1.25 | P17 / P18 |

得分只认比赛结束时仍处携带状态的道具，因此收集机构必须有可靠的锁止或挡板。

---

## 2. 道具（方块）

| 参数 | 数值 | 依据 |
| --- | --- | --- |
| 外部立方体 | 30×30×30mm，12 条棱边 45° 倒角（斜外立面 2.121mm 平面） | P17 / 4.1.2 |
| 内部镂空 | 15×15×15mm | P17 |
| 单个质量 | 约 11.29g | P18 |
| 能量单元（白色） | 18 个，1 分/个 | P17 |
| 能量核心（黄色） | 5 个，4 分/个 | P18 |

能量单元（18 个）分布（P17）：

- a8、h1、c4、f5 地块中心（胶带标记处）；
- e8、d1 台阶几何中心（台阶高 150mm）；
- e8'、d1' 附属高台每组矮墙中心各 1 个；
- d6、e3 台阶内侧四分之一处两个地块几何中心；
- 地图中心轴方向距中心 40mm 处 4 个（矮墙限位处）。

能量核心（5 个）分布（P18）：

- 2 个挂在 e3、d6 的物资架初始端（质心距地 250mm）；
- 2 个位于 d1、e8 台阶下的洞穴内（洞穴开口 70×70×50mm）；
- 1 个位于中央高地平台的焦点中心（焦点总高 70mm）。

### 矮墙对机构选型的影响

手册 P16：

- e8、d1 附属高台上有两组矮墙（每片 10×50×10mm），组内间距 **31.5mm**，组间间距 40mm；
- 焦点周围十字基座每方向两片矮墙（10×60×10mm），间距 **31.5mm**，距中心 64.25mm。

方块 30mm 与矮墙间距 31.5mm 只差 0.75mm/侧，即方块被矮墙限位卡在槽内；矮墙高 10mm，方块露出 20mm。

结论：这类方块不能靠侧推式铲子收集（铲板低于 10mm 会撞矮墙，高于 10mm 顶不过矮墙），只能向上提、夹取或上翻兜住。涉及至少 6 个能量单元（附属高台 2 个 + 焦点周围 4 个）。对中期考核不构成阻塞（中期方块携带在平地演示即可），但影响正式比赛的收集率。

---

## 3. 场地

| 要素 | 参数 | 依据 |
| --- | --- | --- |
| 场地 | 2400×2400mm 正方形，地面覆 6mm 白色地胶 | P15 |
| 坐标系 | 红方视角 a–h（8 列）×1–8（8 行），单位区块 300×300mm | P15 |
| 围挡 | 聚丙烯外包金属框架，上边沿距地面 500mm | P15 |
| 高台 ×6 | 高 300mm；a4、d4、d5、e4、e5、h5 | P16 |
| 台阶 ×4 | 高 150mm；e8、d6、e3、d1；d1 与 e8 台阶下各有 70×70×50mm 向外开口洞穴 | P16 |
| 台阶附属高台 | 高 20mm、长 160mm、宽 50mm；双组矮墙 10×50×10mm，组内间距 31.5mm | P16 |
| 坡道 ×4 | a5+a6、h3+h4（坡高 300mm，坡比 0.5）；e1、d8（坡高 150mm，坡比 0.5）；面板厚 5mm，下方有通行空间 | P16 |
| 桥梁 ×4 | b4、c4、f5、g5；长 300mm、宽 150mm、净高 130mm，矢跨比 0.05 | P16 |
| 启动区 ×4 | a1（红 2 号）、a4（蓝 1 号）、h5（红 1 号）、h8（蓝 2 号） | P16 |
| 物资架 | 直径 14mm、长 150mm 圆柱，平行地面固定在高台侧面，质心距地 250mm | P16 |
| 焦点 | 中央高地上的平台，总高 70mm；300×300mm 十字基座 + 60×60×40mm 方柱 + 80×80×20mm 平台 | P16 |

> 注：a4、h5 同时出现在"高台 ×6"与"启动区"两行，系手册 P16 原文如此（可能为台上启动位）；两者关系未经现场核对【待核实】，以手册原文为准。

---

## 4. 机器人技术规范

| 类别 | 规范 | 依据 |
| --- | --- | --- |
| 初始尺寸 | 长宽 ≤ 290×195mm，高 ≤ 210mm（每局正式开始时） | P6-7 / 3.3.2 |
| 任意状态尺寸 | 长宽高 ≤ 445×400×450mm，或满足直径 550mm 球体约束 | P6 / 3.3.2 |
| 重量 | ≤ 2.0kg | P7 / 3.3.2 |
| 结构强度（检录） | 150–200mm 高处底面朝下自由下落，无零件掉出 | P7 |
| 结构强度（中期指标） | 180mm 自由下落无零件掉出 | P9 |
| 电源 | 指定 18650 电池；每台机器人仅允许 1 个供电模块；供电模块额定电压 ≤ 7.4V | P6 |
| 供电模块定义 | 有且仅有一个输出接口；继电器与电池间有延长/转接线时按离电池最近端计算接口数（**本队解释口径**：两路 DC-DC 属稳压环节、不算第二个供电模块，论证见《接线规范篇》§3；该解释未经组委会书面确认【待核实】） | P6 注 |
| 无线断电 | 必须适配官方指定无线继电器，底盘电源能在 10m 内被单独遥控切断；检录检测，遥控器上交裁判 | P8 |
| 遥控器 | 官方物资表列出 PS2 手柄；不限制使用其他自行购买的遥控器或其他控制方案（V1.5） | P6 / 3.2 |
| 通讯方式 | 蓝牙 / 2.4G / WiFi / 红外，仅可选其中一种；发射源与接收源有且仅有一组 | P6 |
| 物理安全 | 不得携带或装配任何尖锐物体，不得装易致短路、爆炸或具穿刺、破坏功能的装置 | P7 |
| 结构建议 | 建议牢固材料，避免热熔胶；建议采用集成电路板，纯杜邦线易脱落；布线不得过度裸露 | P7 |

对设计的约束：

1. 铲子存在被认定为尖锐物体的风险，前沿须钝化并做大圆角；
2. 初始尺寸 290×195×210mm 很紧，铲子须可收拢或完全在包络内；
3. 供电仅 1 个模块且额定 ≤7.4V，2 节 18650 串联（2S，额定 7.4V）是规则下的上限，不能挂两块电池、不能用 3S；
4. 无线继电器为强制件，无此件无法通过检录。

---

## 5. 成本规范

| 组别 | 规则 | 依据 |
| --- | --- | --- |
| 新生组 | 整机造价不推荐超过 400 元；可自行购买其他物资但须符合赛事规则 | P7-8 |
| 非新生组 | 除紧固件、胶粘剂外，仅限官方物资表内物资 + 自制 PCB + 3D 打印件，数量不限 | P8 |
| 报销 | 总报销不超过 400 元；未通过中期考核不予报销 | P8 |
| 借用 | 可拆卸借用 2025 年回收车辆零部件（不得削减原部件），借件不参与报销 | P8 |
| 3D 打印 | 各实训战队提供打印协助，规范由 GSing 战队发布（待确认） | P8 |
| 禁止 | 严禁直接购买功能成熟的商品机器人或机器人套件；成品 PCB、电压管理等成品模块、视觉套件不在此范围 | P5 |

《CRTC 官方物资表》总计 353.48 元（P22-23）。

---

## 6. 中期考核

| 项目 | 内容 | 依据 |
| --- | --- | --- |
| 提交截止 | **2026-10-19 24:00** | P11 |
| 考核构成 | 完成度考核 : 规则测评 : 文档评估 = 4 : 3 : 3 | P8 |
| 规则测评 | 80 道四选一单选题，每队仅 1 次答题机会，只给分数不给错题 | P10 |
| 文档评估 | 1–5 分等级制，占 30% | P10 |
| 文档规范 | markdown；按设计进度从早到晚；以单个机器人功能为一个板块（H2 功能名 + 正文）；使用开源项目的应在文档末尾完整说明（V1.5） | P10 |
| 仓库规范 | 仓库名以队伍名称的英文或拼音命名；所有文档放在根目录下名为 docs 的文件夹 | P10 |
| 提交方式 | 邮件至 zhang.guohao@lark.cquqian.li；主题"队伍名称 队长姓名"；正文列出完成指标 + 仓库地址；附件 .zip 视频（**≥1080p，≥30 帧，.mp4**；其他展示形式需确保易读性），命名"实训战队名称 队伍名称 队长姓名" | P11 |
| 进阶功能材料 | 文档材料（简易描述进阶功能）+ 视频材料（展示进阶功能）；**视频未展示文档所述功能即视为未完成** | V1.6 |
| 规则测评入口 | `https://i.kaoshiyun.com.cn/v5/exam/781c306` | V1.6 |
| 通过名额 | 新生组前 60，非新生组前 4 | P11 |
| 豁免 | 允许中期测评队伍不产出实物演示 | P11 |

### 基础功能考核指标

每项满分 100 分，完成的队伍平分（精确到 2 位小数）。

| # | 功能名称 | 功能简述 |
| --- | --- | --- |
| 1 | 外形展示 | 至少一台具有能量单元的完整机器人机体（绕车一周） |
| 2 | 电机运动（单一） | 能完成至少一个电机的转动 |
| 3 | 电机运动（全部） | 能完成不少于 4 个电机的转动 |
| 4 | 舵机运动（单一） | 能完成至少一个舵机的转动 |
| 5 | 舵机运动（多项） | 同一台机器人能完成至少三个舵机的转动，且其可动机构能在任意非初始状态下保持相对静止 |
| 6 | 底盘运动（单一） | 能用 PS2 手柄控制至少一个底盘的水平运动（车体与手柄同时出镜或给出相关代码） |
| 7 | 底盘运动（全部） | 能用 PS2 手柄控制全部车体的水平运动 |
| 8 | 尺寸规范 | 尺寸在规则限制范围内（需展示直尺测量结果） |
| 9 | 方块携带（单一） | 使至少一颗在地面静止的方块（30×30×30mm）由非携带变为携带状态 |
| 10 | 方块携带（多项） | 在保持携带 1 块的状态下，再使至少 1 块地面方块由非携带变为携带 |
| 11 | 结构稳定性 | 从高 180mm 处底面朝下自由下落无零件掉出 |
| 12 | 规划/现有采购单 | 队伍核心部件的选型、整机成本预算 |

进阶功能最多 3 项，每项按创新度、实现难度、完成度各 3 分取平均，最高加 9 分；未完成全部基础功能则无法获得进阶加分。

指标 6、7 的文字要求使用 PS2 手柄，但括号内给出替代证明路径"或给出相关代码"；配合 P6"不限制其他控制方案"，开发阶段用电脑操控合规。中期提交建议同时给出实物演示视频、指令层代码与一页说明；时间允许则仍按 PS2 补拍一版。

---

## 7. 对局规则与违规定义

| 项目 | 内容 | 依据 |
| --- | --- | --- |
| 单局时长 | 5 分钟 | P17 |
| 对局结束条件 | 累计 5 分钟 / 道具被全部收集完 / 一方全部机器人 1 分钟内无任何运动或机构活动 | P17 |
| 结束时处理 | 所有机器人立即断电，裁判检查携带的道具数量 | P17 |
| 携带定义 | 物体与机器人接触，且在重力环境下沿任意方向（前后左右上下）均可跟随机器人运动 | P18 |
| 收集 / 转移 | 非携带 → 携带为收集；携带 → 非携带为转移 | P18 |
| 挤压 | 以较低速度靠近使物体改变运动轨迹；机器人之间的挤压允许 | P19 |
| 冲撞（恶意） | 操作手控制下冲撞对方机器人，该队所有机器人立即断电 20s；情节特别恶劣当局判负 | P19 |
| 破坏 | 对场地或对方机器人造成破坏，断电 20s；破坏道具则该道具不计分 | P19 |
| 固连 | 机构连接使对方被携带，累计 10s 后断电 5s，此后固连状态下每 20s 断电 5s | P19 |
| 解体 | 因自身结构缺陷或刻意设计导致结构脱落，可能当局判负 | P19 |
| 操作手 | 仅可在己方操作区内移动；跨出累计超 2 次则罚下并剥夺该局控制权 | P20 |
| 唯一可携带物 | 能量单元和能量核心 | P18 |
| 规则执行准则 | 未被最新手册明确定义为违规的行为不得判罚；组委会可赛后立即修改规则 | P20 |

---

## 8. 赛程时间线

| 节点 | 日期 | 依据 |
| --- | --- | --- |
| 报名截止 | 2026-09-30（已过） | P3 |
| 统一培训 | 2026-10-08、09、10、11 日 19:00–20:40 | P5 / 2.3.4 |
| 中期考核材料提交截止 | **2026-10-19 24:00** | P11 |
| 瑞士轮晋级赛 | 2026-10-24、25、31（V1.6） | P3 |
| 车轮战淘汰赛 | 2026-11-1（V1.6） | P3 |
| 赛制 | 6 轮杜博夫瑞士轮（BO1）+ 8 强淘汰赛（BO3） | P11 |
| 地点 | 重庆大学虎溪校区 | P3 |

> 版本说明：赛程以手册 **V1.6** 为准（瑞士轮 10-24、25、31；淘汰赛 11-1）。此前据队内通知记作"10-23"的口径作废。

---

## 9. 设计风险清单

| # | 风险 | 依据 | 严重度 |
| --- | --- | --- | --- |
| R1 | 铲子被认定为尖锐物体 | P7 安全规范 1 | 高 |
| R2 | 铲子外伸导致初始尺寸超 290×195×210mm | P6 规格规范 | 高 |
| R3 | 收集机构无锁止，5 分钟内道具颠出，结束时不处于携带状态，不得分 | P18 携带定义 | 高 |
| R4 | 结构强度不足，180mm 跌落掉件 | P7 / P9 | 高 |
| R5 | 纯杜邦线接线，运动中脱落 | P7 结构规范 2 | 中 |
| R6 | 电源超过 7.4V 额定或使用 2 个供电模块 | P6 | 高 |
| R7 | 未安装无线继电器 | P8 电源管理规范 | 高 |
| R8 | 通讯方式使用多种或多组收发源 | P6 无线规范 | 中 |
| R9 | 洞穴内核心（70×70×50mm 开口）铲子够不到 | P16 / P18 | 中 |
| R10 | 桥梁净高 130mm，收集机构顶高过不去 | P16 | 中 |
| R11 | 整车重量超 2.0kg | P7 | 中 |
| R12 | 单局 5 分钟内动作流程过长，收集效率不足 | P17 | 中 |
| R13 | 非新生组使用了官方物资表之外的物资 | P8 成本规范 2 | 高 |
| R14 | 矮墙限位处的 6 个方块只能向上取出，铲子侧推无效 | P16 | 中 |
| R15 | 使用开源项目未在文档末尾完整说明 | P10（V1.5） | 中 |
| R16 | 非 PS2 控制方案在指标 6、7 上的认定风险 | P9 / P6 | 中 |

---

## 10. 待确认清单

1. 3D 打印集中使用与管理规范（GSing 战队发布）；
2. 物资表未提供链接的 18650 电池型号与容量有无限定；
3. 全自动/半自动机器人的组委会审查标准；
4. 组委会认定尖锐物体的具体尺度；
5. 指标 6、7 用非 PS2 控制方案演示时的认定方式；
6. 本队组别（新生/非新生），决定可选物资范围；
7. 本队上 1 台还是 2 台机器人，决定是否按"全部车体"准备 8 个电机。

已解决（V1.5）：方块尺寸确定为 30mm。

---

> 手册条款对照：本文满足手册要求——仓库规范 §2；文档规范 §1/§2（资料篇按主题整理、数据与手册口径一致）、§3（风险清单与待确认清单显式列示）；质量标尺 §1（变更影响分析）、§3（约束逐条标注页码与待确认状态）。
