PoXiao-Team/CRTC_Smart_Car/docs/机械篇.md

# 机械篇

> 破晓战队 CRTC2026 参赛小车机械结构设计文档。
> 本文由《机械结构设计日志》与《3D 打印结构分析》合并整编（2026-10-13），内容全部保留并重组为功能板块。
> 状态标注约定：✅ 已完成（实测通过）｜🟡 进行中·未验证｜⬜ 待做。未经实测的尺寸、重量、强度结论一律标注【待实测】，影像推断结论标注"推断"。

---

## 机械总体方案与选型

### 功能描述

机械系统承担三件事：**收集**（把地面方块变为携带状态）、**收纳**（保证结算前不丢失）、**行走**（全向移动接近道具）。设计约束（来自手册，详见《赛事规则解析》）：

| 约束 | 数值 | 对机械设计的含义 |
| --- | --- | --- |
| 初始尺寸（P6） | 长宽 ≤290×195mm、高 ≤210mm | 收集机构必须可收拢；底盘定型前需核算 |
| 重量（P7） | ≤2.0kg | 打印件按实心/高填充打印时须称重 |
| 结构强度（P7/P9） | 跌落 150–200mm 无零件掉出（中期 180mm） | 外伸件防断、防脱；紧固件防松 |
| 非尖锐物体（P7） | 不得携带尖锐物体 | 所有薄壁尖端需钝化（R3 以上圆角） |
| 成本（P8） | 新生组整车 ≤400 元 | 驱动件复用官方物资（SG90 舵机） |

### 开发历程

**收集方式选型。** 最初探讨过多种抓取方块的方案，对比后放弃前两种、确定铲子：

| 方案 | 优点 | 缺点 | 结论 |
| --- | --- | --- | --- |
| 多轴机械臂 | 抓取动作通用 | 结构复杂，组装和调试耗时极长，单次抓取效率低，对操作手精细控制要求极高 | 一个月备赛期内放弃 |
| 钩子机构 | 结构较简单 | 转移方块时容易抓脱，同样需要极高操作精度 | 放弃 |
| **铲子（选用）** | 结构最简单、动作链最短（前进即铲入）、操作精度要求低、易通过跌落测试 | 对矮墙限位方块无效（见下） | 采用 |

**底盘条件。** 结合整车初始尺寸限制（长宽 ≤290×195mm、高 ≤210mm），选用"高 40mm、长 255mm"的金属折弯底盘，为前端铲子留出收拢空间。

**已知适用性边界。** e8、d1 附属高台与焦点周围的矮墙组内间距 31.5mm、方块 30mm 被限位在槽内，只能向上取出，侧推式铲子对这类方块无效（涉及至少 6 个能量单元，依据手册 P16，详见《赛事规则解析》§2）。该问题不阻塞中期考核（中期方块携带在平地演示即可），但影响正式比赛收集率；第一版机构不为其牺牲可靠性，保留为后续迭代方向。

---

## 铲子收集机构

### 功能描述

舵机驱动的翻转铲：舵机转动实现"放平铲入 → 翻起兜住 → 倒入收纳区"三态。要达成的指标：

| 指标 | 目标 | 状态 |
| --- | --- | --- |
| 铲入面高度 | 低于方块质心（15mm），建议 8–15mm | 🟡 设计目标，待 V1 件装配后实测 |
| 收拢尺寸 | 收起状态不超 290×195×210mm 包络 | 🟡 待实测 |
| 合规 | 前沿与尖角 R3 以上圆角、无刃口 | 🟡 待 CAD 改模 + 打印 |
| 强度 | 180mm 跌落不掉件、连接处加机械限位 | 🟡 待实测 |

### 开发历程

**1）V1：水平舵机 + 护栏结构的尝试（设计已淘汰；当前实物为临时过渡沿用 V1 件，见本节第 3 条）。**

- 布局：舵机安排在铲子后端正中、长边平行于底盘（平放）；铲子后端（连接舵机处）设计了一个竖直平面，非收起状态下设计水平凹陷与孔位连接舵机摇臂。
- 防护：铲面（斜坡部分）与底端（铲方块的水平面）都做护栏，底端做斜面方便铲起。
- 工作设想：铲入方块后舵机转动 90°，后端竖直面变为水平、罩在舵机上方，方块经斜坡下滑、通过后端水平面滑入底盘。
- 淘汰原因：① 地面与方块摩擦小，预计需把方块推到墙面才能铲起，有铲子翻转、方块滑出的风险（护栏限位因此很关键但难保证）；② 后端水平面过低，有限空间内可收集方块数目非常有限，无法满足抢分需求。

**2）V2：弧形滑坡 + 竖直舵机布局（当前主线）。**

- 滑坡由"斜状"改"弧形"：省空间（在限高内做更低更长的通道）、圆弧过渡更利于方块顺畅滑下。
- 舵机由平放改**侧立竖直**放置（短边平行于底盘）；铲子上连接摇臂的凹陷相应改为适配竖直舵机的形态，并提前预留充足物理空间，严格防止铲子旋转时与舵机、支架发生干涉。
- 在 V1 基础上减薄铲体（便于舵机顺畅旋转）、加宽铲面与底端、取消底端护栏、底端侧面做斜面。
- 迭代收益：进一步压缩整体尺寸；大幅降低操作手精度要求，提升比赛容错率。

**3）当前实际装配（2026-10-18）：V1 件沿用，V2 改进延期 —— 临时过渡方案。**

- **原因**：V2 件的 3D 打印时间来不及；
- **当前方案（临时过渡）**：实车铲子**暂时沿用第一版（V1）打印件**（即 10-11 结构分析中的红色舵机翻转铲件）；
- **已知问题（2026-10-19 装机发现）**：所用 SG90 舵机**实际行程达不到标称 180°（略小）**，铲子"铲下 → 翻倒"的有效翻转角度相应受限；示教时按**实际可达位置**记录（□ / ○），一键翻铲功能不受影响，但"舵机运动（多项）"指标受此限制，中期视频中未完成【待实测具体角度】；
- **第二版计划（保留）**：中期考核后按 V2 设计改模打印（弧形滑坡、舵机竖直布局、圆角 R3+、减薄铲体、加宽铲面、取消底端护栏、底端侧面斜面），替换 V1 件，并重新验证铲入角度、收拢尺寸与舵机 / 支架干涉。

| 迭代维度 | V1 | V2 | 收益 |
| --- | --- | --- | --- |
| 滑坡形状 | 斜状平面 | 弧形 | 省空间、下滑顺畅 |
| 舵机姿态 | 平放（长边平行底盘） | 侧立竖直（短边平行底盘） | 翻转高度更足、不干涉 |
| 铲体厚度 | 较厚 | 减薄 | 旋转更顺畅 |
| 底部护栏 | 有 | 取消，侧面改斜面 | 降低操作精度要求 |
| 铲面宽度 | 较窄 | 加宽 | 容错率提升 |

**3）舵机支架精细化设计与公差考量。**

- 3D 打印实际精度与理论模型存在差异：设计时预留 1–2mm 公差匹配实物。
- 舵机连线的突出部分会占用空间：支架上提前设置缺口，方便线材放入。
- 装配逻辑严格为"**底盘安装好支架 → 支架连接好舵机 → 舵机连接好铲子**"；最终要达到"**铲子末端高度与地面重合**"的物理状态。
- **舵机回正后再装铲子（2026-10-17 实车确认）**：舵机上电会自动回正——必须先给整车上电、等舵机回正到位，再把铲子装到舵机盘上作为初始位置；此后每次开机舵机都会回到该初始位置，装配前请确认回正方向与铲子朝向一致。
- 为实现上述目标：支架与舵机连接部分做下沉处理，并预留舵机放入的进口，保证组装可达性与最终贴合度。

**4）结构判定（2026-10-11，依据 CAD 录屏与实物照片推断，未经尺寸实测）。**

- V1 实拍件构成（推断）：

| 部位 | 特征 | 功能推断 |
| --- | --- | --- |
| 安装法兰 | 椭圆/圆角矩形板，中心一圆孔、外侧两螺丝孔，板面带台阶 | 舵机盘/输出轴安装位 |
| 力臂 | 扁平长条，长度约为宽度 4–5 倍 | 传动臂 |
| 铲板 | 弧形板 + 一片垂直侧挡板 | 兜住方块并侧向限位 |
| 背部凸起 | 背面沿力臂等距分布约 4–5 个圆柱状凸起 | 待确认：加强筋/防滑凸起或打印支撑残留（实物较毛糙，倾向后者） |

  判断：舵机直接驱动整个铲子绕安装法兰轴线摆动，实现放平铲入、翻起兜住、抬起倒出。
- V2 支架件构成（推断）：底板（方形板，四角安装孔，中间矩形开口供方块通过）＋ 竖直立柱（矩形框截面）＋ 顶部缺口/台阶状卡口（待确认：舵机安装位或方块通道）。
- 白色镂空立方体：各面中央开方孔、12 条棱边有明显倒角，与手册 P17 道具规格（外部 30×30×30mm、内部镂空 15×15×15mm、棱边 45° 倒角）特征一致，判定为按手册规格打印的**能量单元样件**，用于机构验证（实际边长需卡尺实测【待实测】）。

**5）机构形式对比（选型复核）。**

| 方案 | 机构 | 优点 | 缺点 | 定位 |
| --- | --- | --- | --- | --- |
| 被动固定铲 | 前端固定斜面铲板，靠前进推/兜入 | 结构最简单、耐用、跌落测试最易过、零舵机成本 | 只能收平地方块；对矮墙限位方块无效；不满足"舵机运动（多项）"指标 | 兜底方案 |
| **舵机翻转铲（对应 V1 件，选用）** | 铲子装在舵机盘上，舵机转动实现放平/抬起 | 一个舵机完成放平铲入与抬升兜住，机构紧凑 | 舵机承担冲击；需要限位；舵机堵转电流大 | 推荐主线 |
| 夹爪/上提机构 | 两片爪落到方块两侧，收拢夹住后上提 | 唯一能取矮墙槽中方块的形式 | 结构复杂，需两个舵机同步，调试成本高 | 中期之后考虑 |

**6）规则符合性检查（对应《赛事规则解析》风险 R1–R4）。**

- **尖锐物体（R1，高危）**：红色 V1 件前端为薄壁三角尖角，观感上具备穿刺意味，是目前最可能直接导致无法参赛或当场被判违规的问题。处理要求：① 铲板前沿和所有尖角改为 R3 以上大圆角，CAD 改模后重新打印，实物用砂纸/锉刀打磨；② 铲板保持钝面、不削尖，前沿厚度不低于 1mm；③ 在中期文档中补安全设计说明（"铲板前沿圆角 R5、无刃口、仅用于兜住 30mm 轻质方块"）。
- **初始尺寸（R2，高危）**：V1 件目测长度约 200mm 量级【待实测】，若从车头前伸，整车长度极易超出 290mm。处理要求：铲子须可收拢（舵机翻转到贴合车体位置）或完全收纳在包络内；中期"尺寸规范"指标要求展示直尺测量结果，量测必须做；收起状态仍超尺寸则无法通过检录。
- **结构强度（R4，高危）**：铲子是外伸悬臂，跌落时最易断裂或脱落；且手册规定以自行解体方式使对方疑似破坏的，当局判负（P19）。处理要求：① 舵机输出轴与铲子连接处加机械限位/止挡，不让舵机齿轮承受全部冲击；② 用沉头螺丝加宽法兰固定，不只靠舵盘单点固定；③ 打印件实心填充（≥40%）或薄壁加筋，避免沿层间接缝断裂。
- **重量（R11，中危）**：整机 ≤2.0kg。3D 打印 PLA 实心密度约 1.24 g/cm³，红色件体积较大时需称重确认【待实测】。

**7）打印下一版之前逐条检查：**

- [ ] 铲板前沿高度能否低于方块质心（15mm），建议铲入面高度 8–15mm；
- [ ] 铲板两侧是否有挡板（防止方块从侧面滑出）；
- [ ] 收集区是否有挡板或锁止（结算只看"携带状态"，无挡板则加减速/旋转时方块必然掉出）；
- [ ] 铲子翻转范围是否与麦轮、地面、车体干涉；
- [ ] 铲子翻到底时是否把车头抬起（重心后移）；
- [ ] 收起状态的整车尺寸是否 ≤290×195×210mm；
- [ ] 舵机安装位置能否让舵机轴线与铲子转轴对齐（避免偏心受扭）。

**8）待确认问题（按重要性排序）：**

| # | 问题 | 原因 |
| --- | --- | --- |
| Q1 | 红色件总长、宽、厚（尺子量） | 直接决定能否满足初始尺寸 |
| Q2 | 红色件重量（电子秤） | 整机限重 2.0kg |
| Q3 | 背面圆柱凸起是设计特征还是打印支撑 | 影响重量、强度与是否需要打磨 |
| Q4 | 铲子在车上的安装位置与运动方式（最好有装配示意图） | 决定"铲子主动抬升"是否成立 |
| Q5 | 白色立方体实测边长 | 验证是否 30mm |
| Q6 | 是否有 STL/STEP 源文件或尺寸标注图 | 无源文件则只能实测量 |
| Q7 | 两个件的设计意图（与机械组确认） | 部分结论由影像推断，可能与真实意图不同 |

---

## 方块收纳舱

### 功能描述

在电池组、STM32、驱动板占据车体后部的前提下最大化收纳方块数量。设计目标：理论容量 12 块；容错目标：方块落入位置不精准（偏移、堆叠不齐）时仍能容纳。规则依据：只有结算时仍处"携带状态"的道具才计分（P18），收纳舱需具备挡板/限位能力。

### 开发历程

- **空间布局逻辑与公差预留**：车后半部分放置 18650 电池组、STM32 主控板、驱动板，留给方块收纳的空间十分有限。铲入方块在车内的最终停留位置不够精准、极可能偏移或堆叠不齐，因此两层长宽均提前预留 **10–20mm 余量**——用容错设计最大化利用空间，保证理论 12 块目标可实现。
- **阶梯式收纳舱（下窄上宽）**，利用车轮上方剩余空间：

| 层 | 设计要点 | 容量 |
| --- | --- | --- |
| 下层（下窄） | 错开车轮位置；预留连接车头舵机的走线空间 | 4 块 |
| 上层（上宽） | 利用车轮上方空间横向扩展 | 8 块 |
| 合计 | — | 理论 12 块（实际以装配后实测为准【待实测】） |

**当前实际（2026-10-18）：塑料箱平替 —— 临时过渡方案。**

- **原因**：阶梯式收纳舱需 3D 打印件（下窄上宽结构、挡板与限位），打印时间来不及；
- **当前方案（临时过渡）**：**以塑料箱作为装载平替方案**，固定在车体后部用于收集 / 携带方块；
- **已知不足（相对设计舱体）**：① 容量与限位依赖箱体本身，方块堆叠不齐时可能晃动；② 与底盘为临时固定，碰撞 / 跌落下的可靠性【待实测】；③ 重量与外观不如打印舱体；
- **第二版计划（保留）**：中期考核后打印阶梯式收纳舱装车替换，并复核容量（目标 12 块）、限位能力与整机尺寸 / 重量。

---

## 底盘与行走机构

### 功能描述

四轮麦克纳姆轮底盘实体搭建：金属折弯底盘 + TT 减速马达 ×4 + 60mm 黄色麦轮。要求：耐比赛场地频繁碰撞震动、全向移动平稳可微调（支撑"快速抢分"的操作需求）。

### 开发历程

- **紧固件选型与防松**：底盘与 TT 马达组装选用 **M3 内六角螺丝**，配合垫片、弹片（弹簧垫圈）紧固。防松组合可有效应对比赛场地中频繁碰撞导致的震动，防止螺丝松脱，保障激烈对抗中的结构稳定性。
- **麦克纳姆轮安装与调控**：按 **X 形**布局安装（而非 O 形）。选择依据：X 形布局在各方向受力更均匀、左右平移更平稳，便于电控组后续做底盘运动学调控时精准实现平移与微调，提升赛场抢方块灵活性。
- 完成相关线材的焊接与初步整理。
- 装机实测项（电机编号与转向符号表、轮距/轴距记录）【待实测】，测试记录格式见《遥控与指令篇》协作清单。

---

## 结论与下一步

**较可靠的结论：**

1. V1 件为舵机驱动的翻转铲（推断），"铲子是否需要主动抬升"的答案为"需要，1 个舵机翻转即可"——这直接决定电控侧至少预留 1 路舵机 PWM 与"舵机运动"考核项的实现方式；
2. 白色立方体为能量单元样件，机械组已在按手册规格做验证件，机构验证可在打印件到齐后闭环；
3. 当前最急迫的不是精度优化，而是铲子的**尖锐物体合规性**与**初始尺寸**，两条须在打印下一版之前解决。
4. **当前实物与设计主线的偏差（2026-10-18）**：实物铲子为 V1 件、装载为塑料箱——均为**临时过渡方案**（V2 铲子与阶梯式收纳舱因 3D 打印时间来不及延期）；中期考核按过渡方案进行，第二版替换计划见本页"铲子收集机构"第 3 条与"方块收纳舱"当前实际段。

**需要补充的资料/数据：**

- 红色件尺寸与重量实测【待实测】、白色立方体卡尺实测【待实测】、STL/STEP 源文件（如有）；
- 两件在整车上的安装位置与运动方式说明（最好有装配示意图）；
- 打印件实物照片（打印后补拍，入库路径见 README"外部资料"章）。

在拿到上述数据前，不做"一定能装上"的结论，也不给定引脚分配——机构形式会直接改变舵机数量与 PWM 路数（与《遥控与指令篇》协作清单第 1、5 项联动）。

---

> 手册条款对照：本文满足手册要求——仓库规范 §2；文档规范 §2/§3/§4/§5（功能板块结构）；规范 §6（无外部开源引用，结论均自研）；质量标尺 §1（三轮选型对比表、迭代前后对比、合规排查）、§3（【待实测】标注）。
