PoXiao-Team/CRTC_Smart_Car/docs/硬件篇.md

# 硬件篇

> 破晓战队 CRTC2026 参赛小车硬件清单、兼容性分析与供电决策文档。
> 本文由《硬件清单与待确认项》（v2，2026-10-11）升级为功能板块结构（2026-10-13，同步补入硬件到货与实车进展）。所有未实测的参数标注【待确认】，不凭外观猜型号。
> 状态标注约定：✅ 已完成（实测通过）｜🟡 进行中·未验证｜⬜ 待做。未实测内容显式标注【待实测】【待确认】【待核实】。

---

## 物资基线与成本规范

### 功能描述

以手册附录《CRTC 官方物资表》（P22–23）为选型与成本基线，核对全队物资；依据成本规范（P7–8）控制采购：新生组整车建议 ≤400 元、报销上限 400 元，严禁购买成品机器人套件。

### 开发历程（基线整理）

《CRTC 官方物资表》（P22–23）参考总价 **353.48 元**：

| 序号 | 物资 | 款式 | 数量 | 总价 |
| --- | --- | --- | --- | --- |
| 1 | STM32F103C8T6 核心板 | STM32F103C8T6_Micro_焊接 | 2 | ¥18.80 |
| 2 | MG995 舵机 | MG995_180度_铁+铜齿轮 | 2 | ¥29.00 |
| 3 | SG90 舵机 | SG90_180度 | 4 | ¥23.60 |
| 4 | PS2 手柄 | 无线手柄锁定款 + 直插转接板（排针） | 2 | ¥90.00 |
| 5 | TT 马达 | 单轴 1:48 | 8 | ¥22.64 |
| 6 | 麦克纳姆轮 | 60mm 黄色麦轮一套 4 个 + TT 马达联轴器 | 2 | ¥70.00 |
| 7 | 小车底盘 | 4 轮金属底盘折弯板（一体带马达孔） | 2 | ¥22.40 |
| 8 | ST-Link | ST-LINK V2 仿真器 | 1 | ¥12.42 |
| 9 | DRV8833 电机驱动 | DRV8833 驱动模块_红板 | 4 | ¥9.08 |
| 10 | DC-DC 降压 | Mini 降压模块_5V_黑板 | 2 | ¥4.18 |
| 11 | 18650 电池 | 未提供链接，需自行选型 | / | ¥0.00 |
| 12 | 18650 电池盒 | 18650_两节_带线 | 2 | ¥3.96 |
| 13 | 18650 充电器 | 18650 双槽充电器 | 1 | ¥8.60 |
| 14 | 面包板 | / | 2 | ¥4.00 |
| 15–17 | 杜邦线 | 10CM 公对公 / 母对公 / 母对母 40P | 各 1 | ¥7.20 |
| 18 | 无线继电器 | （DC5-24V）1 接收器 + 1 单键 | 2 | ¥27.60 |
| | | | **总计** | **¥353.48** |

成本规范要点（P7–8）：新生组可自行购买其他物资但须符合赛事规则；非新生组仅限物资表内物资 + 自制 PCB + 3D 打印件；报销不超过 400 元，未通过中期考核不予报销；可拆卸借用 2025 年回收车辆零部件（借件不参与报销）。

整车实际成本表（按实际到货与采购逐项汇总，**只填仓库内已知数**）：

| 项目 | 金额 | 状态 |
| --- | --- | --- |
| 官方物资表（含两车量：TT×8、底盘×2、PS2×2 等） | ¥353.48 | 已核对（P22–23） |
| 自制 PCB V2（订单 Y1，5 片） | ¥30.00 | 已支付（10-17） |
| 3D 打印件（GSing 协助） | — | 【待回填】 |
| 补购件（18650 电池、USB-TTL / HC-05 等） | — | 【待回填】 |
| **整车合计** | — | 【待回填】（物资表含两车量，单车口径拆分待办） |

---

## 实物品类确认与缺件

### 功能描述

对照物资表逐件辨认包装标签、确认实物型号与数量，区分"已确认 / 待确认 / 缺失"三类，作为补购与设计决策的依据。

### 开发历程

**已确认的实物（依据包装标签，2026-10-11）：**

| 实物 | 标签型号原文 | 数量 | 结论 |
| --- | --- | --- | --- |
| 面包板 | MB-102 400 孔面包板 | 2 | 已确认 |
| 电机驱动 | DRV8833 驱动模块_红板 | 4 | 已确认，数量充足（只需 2 个） |
| 舵机 | SG90 舵机_180度（TIANKONGRC） | 4 | 已确认；**实测行程达不到 180°（略小，具体角度【待实测】）**——影响见《机械篇》铲子"已知问题"与《工程日志》10-19 |
| 杜邦线 | 40P 杜邦线_公对公_10CM_全铜 | 1 | 已确认 |
| 杜邦线 | 40P 杜邦线_母对公_10CM_全铜 | 1 | 已确认 |
| 充电器 | YB 牌 Li-ion Battery Power，适用于 2×3.7V 锂电 | 1 | 已确认，是充电器而非放电保护板 |
| 主控 | STM32F103C8T6 开发板_Micro_焊接 | 待确认（标签数量被遮挡） | 型号已确认；引脚引出、USB 口、板载转串口芯片仍待实物确认 |

**缺失件与影响（2026-10-11 时点）：**

| 缺失件 | 后果 |
| --- | --- |
| PS2 无线手柄 + 接收器 | 中期指标 6、7 无法按字面演示，替代方案见《遥控与指令篇》 |
| TT 减速马达 1:48 | 无电机则底盘零功能，指标 2、3、6、7 全部为 0 |
| ST-Link V2 下载器 | 无法烧录程序 |
| 18650 电池本体 / 电池盒 | 无法上电 |
| 无线继电器（DC5-24V） | 无此件无法通过检录；按手册 P23 注 6，中期通过后再购买 |
| 金属底盘折弯板 | 若无则需 3D 打印底盘 |

**2026-10-13 ~ 10-15 状态更新**（到货时间【待回填】）：

- TT 减速马达已到货：底盘与 TT 马达完成组装（见《机械篇》"底盘与行走机构"）；
- 10-13 完成硬件引脚焊接与接线；**实车已跑通**：底盘四电机驱动正常（10-14）【待回填细分参数】；
- **PS2 无线手柄 + 接收器已到货**：实车连接与操控验证通过（10-14），中期指标 6、7 可正常演示；
- 供电采用降压方案（候选 B）并已带载运行（10-14）；降压模块与电压参数【待回填】；
- 10-15 起按打板需求完成多件实物核对（DRV8833 实为 16 脚、核心板 40 脚映射、DC-DC 四角焊盘）；设计数据见 `hardware/pcb/`（详见《工程日志》"硬件打板与 PCB 设计"板块）；
- 10-17 核心板实测 **53×22mm**（两列排针中心距 15.24mm）；DRV8833 芯片封装口径澄清（PWP/PW/RTY 封装电流能力不同但本项目均够用；使用成品红板模块，**不买裸芯片**）；
- 10-17 PCB V2 完成并**已下单支付**（订单 **Y1**：16:25 下单 / 16:27 支付）：板框 **100×70mm**、4×M3 孔（6/3.2）、双面铺 GND、DRC 0；2 层 / 1.6mm / FR-4 / 1oz / 绿油白字 / 有铅喷锡 / 5 片；**48 小时免费加急，预计 10-19 晚发货**；实付 **¥30.00**（板费特价 20 + 品质赔付 10）；
- 其余缺件（ST-Link、无线继电器、MG995 等）状态【待核实】；**5V 降压模块已在用**（10-14 带载运行，见上），型号/额定电流【待回填】。

---

## 硬件兼容性分析

### 功能描述

对"驱动能力、电源支路、逻辑电平、共地"四类兼容性问题做初判，提前排除会烧件或复位的问题（对应风险清单 R5–R8）。

### 开发历程（初判结论）

| 问题 | 判断 | 依据 |
| --- | --- | --- |
| DRV8833 是否适合实际电机 | 大概率适合，需实测 | 官方套件将 DRV8833 与 TT 马达配成一套；每通道持续约 1.5A 级，TT 马达堵转电流需实测【待实测】 |
| 单个驱动模块能否驱动所需电机数 | 不能，需 2 个 | DRV8833 为双通道，4 个电机需 2 个模块；现有 4 个，够用且余 2 个备用 |
| 是否需要额外驱动模块 | 不需要 | — |
| STM32 逻辑电压兼容性 | 大概率兼容，需确认 | STM32 为 3.3V 逻辑；TT 马达与舵机只接收 PWM；PS2 接收器与 DRV8833 逻辑供电需实测【待实测】 |
| 舵机电源是否足够 | 存在风险 | 5V mini 降压通常 2A 级；MG995 单只堵转可达 1.5–2.5A，两只同时堵转几乎必然拉低 5V |
| 电机启动/堵转是否引起复位 | 高风险 | 4 个 TT 马达同时启动的浪涌会拉低电池电压；STM32 与电机同节点取电极易复位 |
| 是否需要独立电源支路 | 需要，至少两条 | 电机支路与逻辑+舵机支路分开，各自就近加去耦电容（**初判**；最终设计相反：舵机挂 VM 电机路——V2 审查已把"舵机电源误接 +5V"修正为接 VM，见《工程日志》10-17） |
| 哪些必须共地 | 全部 | STM32、DRV8833、5V 降压、舵机、PS2 接收器、电池负极必须连通 |
| 电池相关电气风险 | 三项 | ① 18650 极性接反会直接烧模块；② 2S 无保护板时过放损坏电芯；③ 锂电必须用专用充电器（已到手的双槽充电器可用） |

硬件逐件分析表（参数与影响）：

| 部件 | 当前信息 | 需要确认的参数 | 对项目的影响 |
| --- | --- | --- | --- |
| 麦克纳姆轮 | 黄色花纹万向轮，带安装支架 | 轮径是否 60mm；轮毂轴孔规格；是否已配 TT 联轴器 | 决定底盘尺寸、离地间隙、电机选型 |
| 面包板 ×2 | MB-102 400 孔 | — | 仅桌面测试用，规则建议上车用 PCB |
| DRV8833 ×4 | 红板 | VM 输入范围；每通道持续/峰值电流；SLP 睡眠引脚是否引出 | 决定能否驱动 TT 马达、VM 供多少伏 |
| SG90 ×4 | 180°，TIANKONGRC | 堵转扭矩；堵转电流 | 适合小机构；可满足"至少 3 个舵机转动"指标 |
| MG995 | 物资表为 180° 铁+铜齿轮 ×2 | 是否 180°；数量；堵转电流；堵转扭矩 | 决定舵机支路电流能力（**后续定案：1 号车铲子由 1×SG90 驱动**，见《机械篇》V2 设计；MG995 转为 2 号车机械臂选型核算候选【待定】） |
| 5V mini 降压 | 物资表为"黑板" ×2 | 输入范围；最大持续输出电流 | 决定能否同时带 STM32 与 MG995 |
| STM32F103C8T6 | 型号已确认（开发板_Micro_焊接） | 是否引出全部 GPIO；有无 USB 口；有无板载 USB 转串口芯片；板载 LDO 输入范围；下载接口 | 引脚分配与电脑操控链路的依据 |
| 电池组 | 黑色封装锂电 + 红黑线 | 电芯数；串并联；容量；保护板；是否 18650 | 规则限制额定 ≤7.4V、仅 1 个供电模块 |
| 18650 充电器 | YB 双槽，支持 2×3.7V | — | 只负责充电，不能替代电池保护板 |
| 杜邦线 | 公对公 / 母对公，10CM 40P | 母对母是否也有 | 规则不推荐纯杜邦线 |
| 3D 打印件 | 白色镂空立方体 ×1（道具样件）；红色铲子件 ×1（机构件） | 见《机械篇》待确认清单 | 有尺寸与安全风险 |

**安全风险汇总**：18650 极性接反烧模块；2S 无保护板的过放与短路风险；电机与 STM32 共用电源节点导致主控复位；MG995 与 STM32 共用 5V 支路导致电压跌落；3D 打印铲子件的尖锐边缘触碰安全规范（处理见《机械篇》）。

---

## 供电方案决策（未决 → 试跑验证）

### 功能描述

在规则红线内确定电机与逻辑供电方案：**供电模块额定电压 ≤7.4V、每台机器人仅 1 个供电模块、必须适配官方无线继电器**（P6/P8）。目标：不烧电机、不因浪涌复位、同时满足舵机瞬时电流。

### 开发历程

关键事实：

| 事实 | 数值 | 状态 |
| --- | --- | --- |
| 规则上限：供电模块额定电压 | ≤7.4V | 已确认（P6） |
| 2 节 18650 串联（2S） | 额定 7.4V / 满电 8.4V | 常识 |
| 2 节 18650 并联（2P） | 额定 3.7V / 满电 4.2V | 常识 |
| TT 马达 1:48 标称工作电压 | 通常 3–6V | 【待确认】查商品页/实测 |
| DRV8833 的 VM 输入范围 | 需查实际模块 | 【待确认】 |

三条候选路线对比：

| 方案 | 做法 | 优点 | 风险 |
| --- | --- | --- | --- |
| A 直供 2S | DRV8833 的 VM 直接接 7.4V | 最简单、成本最低 | TT 马达超压，发热、寿命、堵转电流上升 |
| **B 降压供驱动（选用）** | 电池 → 大电流降压 → VM | 电压规范、电机安全 | 需大电流降压模块：4×TT 堵转约 5A（估算，待实测）+ SG90 0.5A ≈ **5.5A 峰值**，**额定 ≥3A 为决策门槛**（见 `design/out/线宽与电流预算.md` 风险 R3）；实物型号与额定【待回填】 |
| C 直供 + 软件限速 | VM 接 7.4V，PWM 占空比上限压到约 70%（等效约 5.2V） | 成本最低，等效约 5.2V | 靠软件兜底，堵转电流仍按 7.4V 算 |

**当前状态**：**已确认采用降压方案（候选 B）**——双路：逻辑路 DC-DC 输出 5V 供 STM32（板载 LDO 出 3.3V）；电机路 DC-DC 输出 **VM = 5.0V** 供两个 DRV8833 的 VM 与舵机（打板设计值）。实车带载运行正常（2026-10-14）。DC-DC 型号/额定电流与实测电压【待回填】。

---

## 补购清单与优先级

### 功能描述

按"阻塞程度"排序的补购计划，保证中期考核（10-19 24:00）前不缺关键件。

### 开发历程（清单维护）

需补购（按优先级）：

1. TT 减速马达 1:48（单轴）×4，做双车则 ×8 —— **已到货**（10-13 更新，底盘已组装）；
2. USB-TTL 模块（CH340/CP2102）或 HC-05 蓝牙模块，用于桌面调试（PS2 已可用，此项降为调试备份需求）；
3. ST-Link V2 下载器；
4. 18650 电池 ×2、电池盒、（如需要）保护板；
5. 无线继电器（DC5-24V），中期通过后再买（P23 注 6）；
6. 排针排母、电机安装件（若麦轮套件未含）；
7. PS2 无线手柄 + 直插转接板 —— **已到货**（10-14 更新，实车连接操控正常）。

---

## 待补充资料清单

### 功能描述

下一次信息收集的清单（拍照、测量），补全后本表逐项销项。

### 开发历程

| # | 补充内容 | 用途 |
| --- | --- | --- |
| P1 | STM32 板正反面特写（排针丝印、USB 口、芯片） | 引脚分配与电脑操控链路 |
| P2 | DRV8833 红板正反面特写（引脚丝印） | 确认引脚定义与 VM 范围 |
| P3 | 电池组与 18650 电池盒（正反面、接线端） | 确认串并联与极性 |
| P4 | MG995 标签面与全部舵机合影 | 确认数量与角度 |
| P5 | 5V 降压模块正反面（芯片印字） | 确认电流能力 |
| P6 | TT 马达本体与轴 | 单轴/双轴、轴径 |
| P7 | 麦轮与联轴器特写 | 轮径与轴孔 |
| P8 | 尺子量红色铲子件总长、宽、厚、安装孔距 | 判定是否超尺寸限制 |
| P9 | 电子秤量红色铲子件重量 | 判定是否超 2.0kg 预算 |
| P10 | 卡尺量白色立方体 | 确认是否 30mm |
| P11 | 3D 打印件 STL / STEP 源文件（如有） | 尺寸分析不靠目测 |

---

## 变更记录

| 日期 | 版本 | 变更 |
| --- | --- | --- |
| 2026-10-11 | v1 | 初版，基于手册 V1.4、整袋照片与口述清单 |
| 2026-10-11 | v2 | 依据手册 V1.5 更新；补入包装标签辨认结果；新增 3D 打印件条目；确认 PS2 手柄缺失 |
| 2026-10-13 | v3 | 升级为功能板块结构；补入硬件到货与接线进展（TT 马达已到、底盘组装、接线完成）；新增待回填项 |
| 2026-10-14 | v4 | 实车跑通：PS2 手柄到货并连接操控正常、底盘实车运动正常；同步更新状态段、供电现状与补购清单 |
| 2026-10-14 | v5 | 供电方案确认采用降压路线（候选 B）；补记 10-13 硬件引脚焊接 |
| 2026-10-15 | v6 | 打板阶段实物核对结论补记（DRV8833 16 脚、核心板 40 脚映射、DC-DC 四角焊盘）；供电口径细化（双路，VM = 5.0V） |
| 2026-10-17 | v7 | PCB V2 完成（100×70mm、DRC 0、Gerber 导出、报价 ¥20/5 片）；核心板尺寸 53×22mm 实测；DRV8833 成品模块口径澄清 |
| 2026-10-18 | v8 | 补 PCB 订单信息：订单 Y1，10-17 16:25 下单 / 16:27 支付，48h 加急，实付 ¥30/5 片（特价 20 + 品质赔付 10），预计 10-19 晚发货 |

---

> 手册条款对照：本文满足手册要求——仓库规范 §2；文档规范 §2/§3/§4/§5（功能板块结构）；§6（开源引用见《开源项目说明》）；质量标尺 §1（三路线供电对比表、兼容性依据）、§3（【待确认】【待实测】标注）。
