PoXiao-Team/CRTC_Smart_Car/hardware/pcb/V2设计方案-实物对照版.html

# CRTC2026 破晓战队 · 底板 V2 完整设计方案

实物对照版 —— 严格按实物照片与已复核的引脚顺序，给出逐模块、逐引脚的接线（可直接照抄落图）

依据：实物照片 ×4 + 已核对照 规模：22 元件 / 29 网络 版本：V2（2026-10-16） 配套：PCB/design/out/接线表.md（同源） ⚠ 10-16 审查版：仍含 C1–C6 与 J2–J5；最终 V2 取舍（省略去耦电容、不装马达端子、板框 100×70）以《工程日志》10-17 为准

## ① 系统总览

                 ┌─ 官方无线继电器 ─┐
 2S 电池(7~8.4V) ─┤                 ├─ VBAT ─┬─ 降压模块2 ─(OUT 调 5.00V)─▶ +5V ── 核心板 5V / 调试口
                 └─────────────────┘        └─ 降压模块1 ─(OUT 调 5.00V)─▶ VM  ── 两块 DRV8833(VM) + 舵机
 全局共地：所有元件 GND 连成一张网（全板唯一地网，不出现 VSS/GNDA 等别名）

链路 | 走向
电源 | 电池 →（继电器）→ VBAT → 两块降压模块输入；降压模块 2 → +5V（只给核心板 + 调试口）；降压模块 1 → VM（给两块驱动 + 舵机）
控制 | PS2 手柄 → 核心板 B3/B4/B5/B6（软件 SPI）；8 路 PWM（A8/A9/A10/A11 + A6/A7/B0/B1）→ DRV8833 ×2 → 四路马达；B7 → 舵机；A2/A3 → 调试口
使能 | B12 → 两块 DRV8833 的 STBY（三点同网，高电平使能）

两条必须记住的电气红线：① VM 与 +5V 是两条独立的网（两块 mini 的输出），任何情况下不许合并；② 全板只有一张 GND 网。

## ② 模块逐脚接线（V2 落图照抄）

### 1. 电池输入端子（建议位号 J1 / 你画的“电源”）

脚 | 接 | 网络
1 | 电池正（经无线继电器） | VBAT
2 | 电池负 | GND

### 2. 降压模块 1（VM 路 → 驱动 + 舵机）· 实物：方形、四角焊盘，丝印 OUT+ 左上 / OUT− 右上 / IN+ 左下 / IN− 右下

侧 | 脚位（按实物） | 接 | 网络
左块 | 第 1 位（上） | OUT+ | VM（驱动 + 舵机 5.0V）
左块 | 第 6 位（下） | IN+ | VBAT
右块 | 第 1 位（上） | OUT− | GND
右块 | 第 6 位（下） | IN− | GND

⚠ 注意 OUT+ 与 IN+ 不是同一个网——一个去 VM、一个接 VBAT。输出设 5.0V（不是 6V：2S 电池后半程压差不足会不稳压）。

### 3. 降压模块 2（+5V 路 → 核心板）

侧 | 脚位（按实物） | 接 | 网络
左块 | 第 1 位（上） | OUT+ | +5V（核心板专用；与 C8T6 左列第 18 脚 5V 同网）
左块 | 第 6 位（下） | IN+ | VBAT
右块 | 第 1 位（上） | OUT− | GND
右块 | 第 6 位（下） | IN− | GND

上电前把输出调到 5.00V（空载调、带载复测）。

### 4. STM32 核心板 · 左列（建议位号 U3A）· 1 脚靠 USB 端，自上而下 20 脚

脚 | 丝印 | 网络（语义名 / 你图里的引脚名写法） | 说明
1 | B12 | DRV_STBY（B12） | 两块驱动使能，三点同网
2,3,4 | B13,B14,B15 | NC × | 悬空
5 | A8 | DRV_F_AIN2（A8） | TIM1_CH1
6 | A9 | DRV_F_BIN2（A9） | TIM1_CH2
7 | A10 | DRV_R_AIN2（A10） | TIM1_CH3
8 | A11 | DRV_R_BIN2（A11） | TIM1_CH4
9,10 | A12,A15 | NC × | 悬空
11 | B3 | PS2_CS（B3） | PB3 须关 JTAG 保 SWD
12 | B4 | PS2_CLK（B4） | PB4 同上；禁用 TIM3 部分重映射
13 | B5 | PS2_CMD（B5） | 软件 SPI 主出
14 | B6 | PS2_DAT（B6） | 软件 SPI 主入
15 | B7 | SRV_PWM（B7） | TIM4_CH2，50Hz
16,17 | B8,B9 | NC × | 悬空
18 | 5V | +5V | 核心板供电（← 降压模块2 的 +5V，同网）
19 | G | GND
20 | 3V3 | +3V3 | 给 PS2 接收器

### 5. STM32 核心板 · 右列（建议位号 U3B）

脚 | 丝印 | 网络 | 说明
1 | G | GND
2 | G | GND | 两处 G 都接（内部本就连通，接双保险）
3 | 3.3 | +3V3 | 与左列 3V3 同一网
4 | RES | NC × | 复位脚，本设计不接
5,6 | B11,B10 | NC × | 悬空
7 | B1 | DRV_R_BIN1（B1） | TIM3_CH4
8 | B0 | DRV_R_AIN1（B0） | TIM3_CH3
9 | A7 | DRV_F_BIN1（A7） | TIM3_CH2
10 | A6 | DRV_F_AIN1（A6） | TIM3_CH1
11,12 | A5,A4 | NC × | 悬空
13 | A3 | DBG_RX（A3） | USART2_RX
14 | A2 | DBG_TX（A2） | USART2_TX
15～20 | A1,A0,C15,C14,C13,VB | NC × | 悬空（VB 为备用电池脚）

### 6. DRV8833 前轮（建议位号 U4A / U4B）· 实物 2×8：左列控制、右列电源输出

左列脚 | 丝印 | 网络 | ｜ | 右列脚 | 丝印 | 网络
1 | NC | × | ｜ | 1 | VM | VM
2 | AIN2 | DRV_F_AIN2（A8） | ｜ | 2 | NC | ×
3 | AIN1 | DRV_F_AIN1（A6） | ｜ | 3 | GND | GND
4 | STBY | DRV_STBY（B12） | ｜ | 4 | AO1 | MOTOR_FL_1
5 | BIN1 | DRV_F_BIN1（A7） | ｜ | 5 | AO2 | MOTOR_FL_2
6 | BIN2 | DRV_F_BIN2（A9） | ｜ | 6 | BO2 | MOTOR_FR_2
7 | NC | × | ｜ | 7 | BO1 | MOTOR_FR_1
8 | GND | GND | ｜ | 8 | GND | GND

右列 BO2 在 BO1 上方（实物丝印如此）；右列两个 GND（3、8 脚）都要接（大电流回路的双保险）。

### 7. DRV8833 后轮（建议位号 U5A / U5B）

左列脚 | 丝印 | 网络 | ｜ | 右列脚 | 丝印 | 网络
1 | NC | × | ｜ | 1 | VM | VM
2 | AIN2 | DRV_R_AIN2（A10） | ｜ | 2 | NC | ×
3 | AIN1 | DRV_R_AIN1（B0） | ｜ | 3 | GND | GND
4 | STBY | DRV_STBY（B12） | ｜ | 4 | AO1 | MOTOR_RL_1
5 | BIN1 | DRV_R_BIN1（B1） | ｜ | 5 | AO2 | MOTOR_RL_2
6 | BIN2 | DRV_R_BIN2（A11） | ｜ | 6 | BO2 | MOTOR_RR_1
7 | NC | × | ｜ | 7 | BO1 | MOTOR_RR_2
8 | GND | GND | ｜ | 8 | GND | GND

后轮右列与左前是镜像接法（BO2→RR_1、BO1→RR_2），与面包板上跑通的方向一致。

### 8. 电容组 C1–C6

位号 | 规格 | 脚 1 / + | 脚 2 / − | 位置要求
C1 | 470µF / 16V 电解 | VM | GND | 紧贴前驱 VM 脚（≤5mm）
C2 | 470µF / 16V 电解 | VM | GND | 紧贴后驱 VM 脚（≤5mm）
C3 | 100µF / 10V 电解 | +5V | GND | 靠 +5V 模块（2 号）输出
C4 | 0.1µF（104）瓷片 | VM | GND | 与 C1/C2 并联
C5 | 0.1µF（104）瓷片 | +5V | GND | 靠 +5V 模块（2 号）
C6 | 100~220µF / 16V 电解 | VBAT | GND | 靠电池输入 + 两块 mini 的 IN

### 9. 马达端子 J2–J5（板下边缘）

端子 | 脚 1 | 脚 2 | 接到
J2（左前 FL） | MOTOR_FL_1 | MOTOR_FL_2 | 前驱 AO1 / AO2
J3（右前 FR） | MOTOR_FR_1 | MOTOR_FR_2 | 前驱 BO1 / BO2
J4（左后 RL） | MOTOR_RL_1 | MOTOR_RL_2 | 后驱 AO1 / AO2
J5（右后 RR） | MOTOR_RR_1 | MOTOR_RR_2 | 后驱 BO2 / BO1（镜像）

同一电机的两个脚必须是两个不同的网名（_1/_2）——同名即短路。方向不对时整组对调端子线即可。

### 10. 舵机接口 J6（板右边缘）

脚 | 丝印 | 网络 | 舵机线色
1 | S | SRV_PWM（B7） | 黄（信号）
2 | V | VM ← 注意：是 VM，不是 +5V | 红
3 | G | GND | 棕/黑

### 11. PS2 接收器接口 J7（板右边缘）· 1–4 脚顺序待实物核对

方案 | 1 | 2 | 3 | 4 | 5 | 6
口述顺序（面包板接法） | DAT(B6) | CMD(B5) | CS(B3) | CLK(B4) | +3V3 | GND
实物丝印记录顺序 | CS(B3) | CMD(B5) | DAT(B6) | CLK(B4) | +3V3 | GND

两个方案只差 1、3 脚对调。接收器到手后对着丝印一锤定音；在那之前 V2 先锁一种画法即可，但别两个方案混着画。VCC 接 +3V3（不是 +5V）。

### 12. 调试扩展口 J8（板右边缘，可选保留）

脚 | 网络
1 | DBG_TX（A2）
2 | DBG_RX（A3）
3 | +5V
4 | GND

## ③ 网络总表（29 条）

网络 | 端点 | 建议线宽
VBAT | J1.1、mini#1.IN+、mini#2.IN+、C6.+ | 加宽 + 铺铜补强
GND | 全板所有 GND（J1.2、两 mini 的 IN−/OUT−、核心板 G/G、DRV 各 GND、六颗电容、J6.3、J7.6、J8.4） | 铺铜
+5V | 降压模块2.OUT+、核心板 5V（左列 18 脚）、C3.+、C5.1、J8.3 | 10 mil（轻载）
+3V3 | 核心板 3V3/3.3、J7.5 | 10 mil
VM | 降压模块1.OUT+、前驱 VM、后驱 VM、C1.+、C2.+、C4.1、J6.2 | 加宽 + 铺铜补强
DRV_F_AIN2 / BIN2 | A8 ↔ 前驱 AIN2；A9 ↔ 前驱 BIN2 | 10 mil
DRV_R_AIN2 / BIN2 | A10 ↔ 后驱 AIN2；A11 ↔ 后驱 BIN2 | 10 mil
DRV_F_AIN1 / BIN1 | A6 ↔ 前驱 AIN1；A7 ↔ 前驱 BIN1 | 10 mil
DRV_R_AIN1 / BIN1 | B0 ↔ 后驱 AIN1；B1 ↔ 后驱 BIN1 | 10 mil
DRV_STBY | B12、前驱 STBY、后驱 STBY | 10 mil
PS2_CS / CLK / CMD / DAT | B3/B4/B5/B6 ↔ J7 对应脚 | 10 mil
SRV_PWM | B7 ↔ J6.1 | 10 mil
DBG_TX / DBG_RX | A2/A3 ↔ J8.1/J8.2 | 10 mil
MOTOR_FL_1/2、FR_1/2、RL_1/2、RR_1/2 | 各驱动输出 ↔ 对应马达端子（共 8 条，每条 2 端） | 30 mil

## ④ V2 草图对照检查单（照你 10-16 晚的截图逐条核）

# | 部位 | 要做什么

1 | 两块降压模块的 “VCC” 残留（重点） | 已按你确认锁定：降压模块2左 OUT+ → +5V（与 C8T6左 5V 同网）；降压模块1左 OUT+ → VM；两块 IN+ → VBAT。把图上所有 “VCC” 标签全部替换掉——VCC 不在 29 网体系里，且 IN+ 与 OUT+ 绝不能同名（同名 = 输入输出短接）
2 | 两块驱动的 VM | 接 VM 网，不要接 +5V（+5V 是 mini#1 的，合并=两路降压并联）
3 | 四个 DRV 块前后配对 | 前驱输入 = A8/A9/A7/A6；后驱输入 = A10/B0/B1/A11。逐块核对，别前后装反
4 | DRV 右列 3、8 脚 | 两个 GND 都接 GND，不要打 ×；右列只有 2 脚打 ×
5 | 马达输出标签 | 同一电机的两条线用两个不同网名（如 左前电机A / 左前电机B）——现在端子还没接通，记得连上
6 | 舵机电源脚 | 接 VM（截图里看着像 +5V，核一下）
7 | PS2 1–4 脚顺序 | 按 ②-11 的两个方案锁一个，先别混
8 | 位号 | 中文位号会被 DRC 提示“不符合规则”——改成：电源→J1、降压模块1→U1、2→U2、C8T6左/右→U3A/U3B、四块驱动→U4A/U4B/U5A/U5B、舵机→J6、PS2→J7、马达端子→J2–J5、电容→C1–C6

## ⑤ 待确认清单（不影响落图，影响下单前定稿）

项 | 怎么核
PS2 接收器 1–4 脚顺序 | 实物到手对丝印（见 ②-11）
核心板两列针距（估 15.24mm） | 卡尺实测，PCB 布局前确认
DRV8833 两排针距（估 10.16mm） | 实测
mini 模块四角孔距 + 背面平整度 | 实测（决定 U1/U2 的 PCB 封装做法）
DRV8833 模块是否有 VCC 逻辑脚 | 对实物丝印（本设计按无处理）

依据：2026-10-15 实物照片 4 张（DRV8833 / mini 降压 / STM32 核心板 / 面包板整车）；与 PCB/design/out/接线表.md、NETLIST.csv 同源。V2 设计任何改动请同步回接线表，保持“单一数据源”。生成日期：2026-10-16。修订：10-16 晚按车主编号——降压模块2 = +5V 路（供核心板）、降压模块1 = VM 路（供驱动/舵机）。
