PoXiao-Team/CRTC_Smart_Car/hardware/pcb/design/out/施工单.html

# CRTC2026_SmartCar_BaseBoard V1 · 施工单

板框 92×72mm · 2层/1oz · 最小线宽 10 mil · 过孔 24/12 mil · 顶层底层全铺 GND ｜ 由 crtc_baseboard_v1.py 自动生成

## 接线表（同名即同网，照抄）

J1电池/继电器输入端子KF301-2P

引脚 | 网络
BAT+ | VBAT
BAT- | GND

U1mini 降压模块 #1（+5V 路）1x4 排母 2.54mm

引脚 | 网络
IN+ | VBAT
IN- | GND
OUT+ | +5V
OUT- | GND

U2mini 降压模块 #2（VM 路）1x4 排母 2.54mm

引脚 | 网络
IN+ | VBAT
IN- | GND
OUT+ | VM
OUT- | GND

U3ASTM32 核心板排母 · 左列（20 脚，自上而下）1x20 排母 2.54mm

引脚 | 网络
B12 | DRV_STBY
A8 | DRV_F_AIN2
A9 | DRV_F_BIN2
A10 | DRV_R_AIN2
A11 | DRV_R_BIN2
B3 | PS2_CS
B4 | PS2_CLK
B5 | PS2_CMD
B6 | PS2_DAT
B7 | SRV_PWM
5V | +5V
G | GND
3V3 | +3V3
B13 / B14 / B15 / A12 / A15 / B8 / B9 | NC（不连接）

U3BSTM32 核心板排母 · 右列（20 脚，自上而下）1x20 排母 2.54mm

引脚 | 网络
G1 | GND
G2 | GND
3V3 | +3V3
B1 | DRV_R_BIN1
B0 | DRV_R_AIN1
A7 | DRV_F_BIN1
A6 | DRV_F_AIN1
A3 | DBG_RX
A2 | DBG_TX
RES / B11 / B10 / A5 / A4 / A1 / A0 / C15 / C14 / C13 / VB | NC（不连接）

U4ADRV8833 #1 模块座 · 左列（控制/使能侧）1x8 排母 2.54mm

引脚 | 网络
AIN2 | DRV_F_AIN2
AIN1 | DRV_F_AIN1
STBY | DRV_STBY
BIN1 | DRV_F_BIN1
BIN2 | DRV_F_BIN2
GND1 | GND
NC1 / NC2 | NC（不连接）

U4BDRV8833 #1 模块座 · 右列（电源/输出侧）1x8 排母 2.54mm

引脚 | 网络
VM | VM
GND2 | GND
AO1 | MOTOR_FL_1
AO2 | MOTOR_FL_2
BO2 | MOTOR_FR_2
BO1 | MOTOR_FR_1
GND3 | GND
NC3 | NC（不连接）

U5ADRV8833 #2 模块座 · 左列（控制/使能侧）1x8 排母 2.54mm

引脚 | 网络
AIN2 | DRV_R_AIN2
AIN1 | DRV_R_AIN1
STBY | DRV_STBY
BIN1 | DRV_R_BIN1
BIN2 | DRV_R_BIN2
GND1 | GND
NC1 / NC2 | NC（不连接）

U5BDRV8833 #2 模块座 · 右列（电源/输出侧）1x8 排母 2.54mm

引脚 | 网络
VM | VM
GND2 | GND
AO1 | MOTOR_RL_1
AO2 | MOTOR_RL_2
BO2 | MOTOR_RR_1
BO1 | MOTOR_RR_2
GND3 | GND
NC3 | NC（不连接）

C1VM 储能电容 #1（紧贴 U4）CAP-TH_D6.3xH11.0_P2.50

引脚 | 网络
+ | VM
- | GND

C2VM 储能电容 #2（紧贴 U5）CAP-TH_D6.3xH11.0_P2.50

引脚 | 网络
+ | VM
- | GND

C3+5V 输出滤波电容CAP-TH_D5.0xH11.0_P2.00

引脚 | 网络
+ | +5V
- | GND

C4VM 高频去耦电容CAP-TH_D4.3xH11.0_P5.08

引脚 | 网络
1 | VM
2 | GND

C5+5V 高频去耦电容CAP-TH_D4.3xH11.0_P5.08

引脚 | 网络
1 | +5V
2 | GND

C6VBAT 输入储能电容CAP-TH_D6.3xH11.0_P2.50

引脚 | 网络
+ | VBAT
- | GND

J2左前马达端子 FLKF301-2P

引脚 | 网络
1 | MOTOR_FL_1
2 | MOTOR_FL_2

J3右前马达端子 FRKF301-2P

引脚 | 网络
1 | MOTOR_FR_1
2 | MOTOR_FR_2

J4左后马达端子 RLKF301-2P

引脚 | 网络
1 | MOTOR_RL_1
2 | MOTOR_RL_2

J5右后马达端子 RRKF301-2P

引脚 | 网络
1 | MOTOR_RR_1
2 | MOTOR_RR_2

J6舵机接口 SG90HDR-TH_1x3_P2.54

引脚 | 网络
S | SRV_PWM
V | VM
G | GND

J7PS2 接收器接口HDR-TH_1x6_P2.54

引脚 | 网络
DAT | PS2_DAT
CMD | PS2_CMD
CS | PS2_CS
CLK | PS2_CLK
VCC | +3V3
GND | GND

J8调试扩展口（USART2）HDR-TH_1x4_P2.54

引脚 | 网络
TX | DBG_TX
RX | DBG_RX
+5V | +5V
GND | GND

## 装配核对（断电·蜂鸣档，通电前必做）

1. 01 J1.BAT+ 与 U4B.VM / U5B.VM / J6.V —— 必须不导通（VBAT 与 VM 隔离）
2. 02 J1.BAT- 与 U3A.G / U3B.G1 / U3B.G2 / U4A.GND1 / U4B.GND2 / U5A.GND1 / U5B.GND2 / J7.GND —— 全部导通（GND）
3. 03 U1.OUT+ 与 U2.OUT+ —— 必须不导通（+5V 与 VM 隔离）
4. 04 U3A.B12 与 U4A.STBY 与 U5A.STBY —— 三点互导（DRV_STBY）
5. 05 U4A/U5A 的 NC 脚（第 1、7 位）与任何网络 —— 必须不导通（模块 NC 脚悬空）
6. 06 C1/C2/C6 的正极与 GND —— 必须不导通（极性方向）
7. 07 U5B.BO2 与 J5.1、U5B.BO1 与 J5.2 —— 分别导通（RR 镜像接法）
8. 08 U1.OUT+ 实测电压 —— 5.00V ±0.05（超过 5.25V 立即断电）
9. 09 U2.OUT+ 实测电压 —— 5.00V ±0.10
