PoXiao-Team/CRTC_Smart_Car/docs/开源项目说明.md

# 开源项目说明

> 破晓战队 CRTC2026 参赛小车开源项目引用登记。
> 依据手册 V1.5（P5、P10）：将开源项目用于机器人的制作及代码编写是允许的，但必须在中期考核阶段给出完整说明，并遵守所使用开源项目的开源协议。
> 本文按使用方式分四类登记：① 自行编写（无外部开源代码）② 参考原理（未直接引用代码）③ 直接安装使用（含"改了什么"说明）④ 开发工具链。
> 不确定的信息一律标注【待核实】，不编造作者、链接与许可证。

---

## 一、自行编写（无外部开源代码）

| 模块 | 说明 | 登记方式 |
| --- | --- | --- |
| 电控指令层 | `cmd_t` 结构体、8 字节定长帧协议、失联保护逻辑（见《遥控与指令篇》） | 自行设计实现 |
| 麦轮运动学解算 | 速度分配公式（基于公开数学原理自行实现，代码完成后补充登记） | 自行实现 |
| 视觉节点 | `armor_detector` 节点、`vm_receiver.py`、`host_infer.py`（见《视觉篇》代码结构） | 自行编写 |
| 机械与结构 | 铲子机构、收纳舱、支架的 CAD 模型与图纸（Fusion 360） | 自行设计 |

> 如后续在上述模块中引入任何开源库或参考实现，将回到本表补登记。

## 二、参考原理（未直接引用代码）

| 原理 / 协议 | 来源说明 | 用在哪里 |
| --- | --- | --- |
| 麦克纳姆轮运动学（速度分解与合成） | 公开数学原理 | 底盘速度解算（自行实现） |
| PS2 手柄 SPI 通信协议 | 公开协议资料 | 已使用：PS2 手柄 10-14 实车连接操控通过；当前协议实现来源（自研 / 参考开源）【待核实】，如采用开源协议实现（如 PS2X 类库的移植参考），将转入第三类补登记 |

## 三、直接安装使用（含修改说明）

| 项目 | 作者 / 组织 | 链接 | 许可证 | 我们如何用 / 改了什么 |
| --- | --- | --- | --- | --- |
| ROS 2（版本【待核实】） | Open Robotics 与 ROS 2 社区 | <https://docs.ros.org>、<https://github.com/ros2> | Apache-2.0 | 虚拟机内运行视觉节点（colcon 编译、话题通信）。未修改源码 |
| OpenCV 4.x | OpenCV 团队 | <https://opencv.org> | Apache-2.0（4.x 起） | 图像处理与 PnP 解算；python3-opencv 与 C++ 源码编译两个方式安装。未修改源码 |
| YOLOv8 / Ultralytics | Ultralytics | <https://github.com/ultralytics/ultralytics> | **AGPL-3.0 ⚠** | 训练与推理检测模型（自建数据集、自训 `best.pt` 权重）；仅走官方 CLI 流程，未修改库源码。**注意 AGPL-3.0 为传染性协议**：本项目仅在队内备赛与赛事展示中使用、不对外提供网络服务、不分发修改版，符合协议要求；如后续需对外分发或提供线上服务，须重新评估履行开源义务 |
| PyTorch（版本【待核实】） | Meta / PyTorch Foundation | <https://pytorch.org> | BSD-3-Clause | YOLO 运行时依赖（CUDA 加速）。未修改 |
| LabelCreator（千里队内标注工具） | fourzkw（千里战队） | <https://gitee.com/fourzkw/label-creator>、<https://github.com/fourzkw/LabelCreator> | MIT（上游仓库 LICENSE：Copyright 2025 YOLO Label Creator） | 数据集标注工具，直接使用。未修改源码 |
| fishros 一键安装脚本 | fishros（小鱼） | <http://fishros.com> | 【待核实】（开源托管于 GitHub） | 一键安装 ROS2、更换系统源、配置 rosdepc。仅执行，未修改 |

## 四、开发工具链

| 工具 | 组织 / 作者 | 许可证 | 用途 |
| --- | --- | --- | --- |
| Ubuntu 22.04 | Canonical | 系统级（含 GPL 等多协议组件） | 虚拟机操作系统 |
| VMware Workstation 17 | Broadcom（原 VMware） | 专有软件（个人使用免费） | 虚拟机平台 |
| VS Code | Microsoft | MIT | 代码编辑 |
| Git | Software Freedom Conservancy | GPL-2.0 | 版本管理（本仓库） |
| CMake | Kitware | BSD-3-Clause | 构建系统 |
| GCC / g++ | GNU 项目 | GPL | C/C++ 编译 |
| Python 3.x | Python 软件基金会 | PSF-2.0 | 脚本与工具链 |
| Conda / Miniconda | Anaconda Inc. | BSD-3-Clause（conda 本体）【待核实】 | Python 环境管理 |
| STM32 开发软件与库 | STMicroelectronics | HAL 库为 BSD-3-Clause【待核实：以实际使用方式（HAL/标准库/寄存器）为准】 | 主控开发 |
| FreeRTOS（如使用） | FreeRTOS / Amazon 项目 | MIT | 实时任务调度（培训内容提及，是否采用【待核实】） |
| Windows 宿主机系统 | Microsoft | 专有软件 | 宿主机操作系统 |

## 参考资料登记（外部资料，2026-10-18）

以下资料为队外来源的参考资料（非本项目自行编写），**尚未用于机器人本体**；如后续直接使用其模型文件或代码，须先补齐作者与许可证信息并更新本节。

| 资料 | 内容 | 来源 / 作者 | 许可证 | 我们如何使用 |
| --- | --- | --- | --- | --- |
| 机械臂资料包 | 3MF 模型（3.2MB）、组装图 PDF、Arduino 参考代码（`arm_control1.0.ino`：4 舵机 + 2 摇杆）、接线方案、常见问题 | 【待核实】（队外分享） | 【待核实】 | 2 号车机械臂方案参考；模型拟用于打印（使用前须确认许可）、代码仅作控制逻辑参考 |
| 钩爪设计台（HOOK LAB 2） | 网页版二维机构 / 舵机设计模拟器（多杆件、关节、闭环；重力与舵机力矩模拟） | 【待核实】（README 未署名） | 项目本体【待核实】；内置 **Planck.js 1.4.2**（Erin Catto / Ali Shakiba）为 **MIT**（`vendor/PLANCK-LICENSE.txt`） | 设计辅助工具（浏览器本地运行），不进入机器人本体 |
| 摇杆底座模型（MakerWorld） | 3D 打印底座模型 | MakerWorld 平台作者【待核实】 | 按平台条款【待核实】 | 2 号车摇杆模块底座参考（见资料包 `摇杆底座模型链接.txt`） |

> **合规提示（手册 V1.5 第三章）**：开源项目（模型文件 / 代码 / 库）用于机器人制作与代码编写时，必须完整说明并遵守协议。**2 号车投入制作前，必须补齐上表的作者 / 链接 / 许可，并在此更新实际使用方式（直接使用 / 修改后使用）。**

## 待核实清单与承诺

| # | 待核实项 | 说明 |
| --- | --- | --- |
| 1 | ROS 2 具体发行版本 | 安装时选定的版本号（鱼香 ROS 安装菜单） |
| 2 | PyTorch / CUDA 版本 | conda 环境中的实际版本 |
| 3 | ~~LabelCreator 许可证~~ | ✅ 已核实：MIT（2026-10-18，见上游仓库 LICENSE） |
| 4 | fishros 脚本许可证 | 以脚本仓库声明为准 |
| 5 | STM32 开发方式（HAL / 标准库 / 寄存器） | 以电控实际代码为准，据此更新许可条目 |
| 6 | 是否使用 FreeRTOS | 以实际代码为准 |
| 7 | PS2 协议实现来源 | 手柄已到货并实车可用（10-14）；具体实现来源待确认，如引入开源实现则补登记并核对许可 |
| 8 | 麦轮解算是否参考了特定开源实现 | 以实际代码为准 |

**承诺**：中期考核材料正式提交前，逐项复核上表并更新为确定信息；此后任何新增开源引用，均在本文件补登记后再随文档提交。

---

> 手册条款对照：本文满足手册要求——仓库规范 §2；文档规范 §6（开源项目：项目名 + 作者/组织 + 链接 + 许可证 + 改动说明完整给出）；质量标尺 §3（不确定信息显式标注【待核实】，不编造）。
