PoXiao-Team/CRTC_Smart_Car/hardware/pcb/design/out/BOM.csv

位号 | 名称 | 型号/规格 | PCB 封装 | 板上做法 | 数量 | 嘉立创EDA搜索关键词 | 采购必选参数 | 备注
J1 | 电池/继电器输入端子 | KF301-2P 螺钉端子（5.08mm 间距，弯插） | KF301-2P | 板边，接线口朝板外 | 1 | KF301-2P | 间距 5.08mm；引脚可过 ≥3A；弯插（接线口朝板外） | 官方无线继电器串在电池与此处之间，继电器本体不装在板上
U1 | mini 降压模块 #1（+5V 路） | mini DC-DC 降压模块（可调，输出设为 5.0V） | 1x4 排母 2.54mm | 排母插座；模块为四角焊盘（2×2，无插针），用 4 根短线焊到排母上进行连接 | 1 | 排母 1x4 2.54 | 1×4 2.54mm 排母；模块本体另购（丝印 OUT+/OUT−/IN+/IN−，型号 V142E 级） | 上电前必须把输出调到 5.00V（空载调、带载复测）；实物四角焊盘顺序按丝印核对后焊线（勿凭位置猜正负）
U2 | mini 降压模块 #2（VM 路） | mini DC-DC 降压模块（可调，输出设为 5.0V） | 1x4 排母 2.54mm | 排母插座；模块为四角焊盘（2×2，无插针），用 4 根短线焊到排母上进行连接 | 1 | 排母 1x4 2.54 | 1×4 2.54mm 排母；模块本体另购（丝印 OUT+/OUT−/IN+/IN−，优选持续 ≥2A） | 输出设 5.0V（不是 6V）：2S 电池后半程压差不足会导致不稳压
U3A | STM32 核心板排母 · 左列（20 脚，自上而下） | 1×20 排母 2.54mm（核心板实物丝印顺序） | 1x20 排母 2.54mm | 排母插座，核心板直插；1 号脚靠 USB 端 | 1 | 排母 1x20 2.54 | 1×20 排母；与 U3B 平行，两排中心距卡尺实测（估值 15.24mm） | 实物左列自上而下：B12、B13、B14、B15、A8、A9、A10、A11、A12、A15、B3、B4、B5、B6、B7、B8、B9、5V、G、3.3 —— 丝印缩略名 B12=PB12、A8=PA8；B3/B4 是 JTAG 复用脚（固件须关 JTAG 保 SWD）
U3B | STM32 核心板排母 · 右列（20 脚，自上而下） | 1×20 排母 2.54mm（核心板实物丝印顺序） | 1x20 排母 2.54mm | 排母插座，核心板直插；1 号脚靠 USB 端 | 1 | 排母 1x20 2.54 | 1×20 排母；与 U3A 平行，两排中心距卡尺实测（估值 15.24mm） | 实物右列自上而下：G、G、3.3、RES、B11、B10、B1、B0、A7、A6、A5、A4、A3、A2、A1、A0、C15、C14、C13、VB —— RES 为复位脚、VB 为 VBAT 脚，本设计均不接；两处 G 都要接 GND
U4A | DRV8833 #1 模块座 · 左列（控制/使能侧） | DRV8833 双 H 桥模块（16 脚，2×8，实测丝印） | 1x8 排母 2.54mm | 排母插座，模块直插；与 U4B 平行，列距按实测（默认 10.16mm） | 1 | 排母 1x8 2.54 | 1×8 2.54mm 排母；模块本体另购（红板 2×8 丝印版） | 实物左列自上而下：NC、AIN2、AIN1、STBY、BIN1、BIN2、NC、GND —— 两个 NC 脚（第 1、7 位）悬空不接；第 8 位 GND 必须接 GND 网
U4B | DRV8833 #1 模块座 · 右列（电源/输出侧） | DRV8833 双 H 桥模块（16 脚，2×8，实测丝印） | 1x8 排母 2.54mm | 排母插座，模块直插；VM 与两处 GND 都要接（大电流） | 1 | 排母 1x8 2.54 | 1×8 2.54mm 排母；模块本体另购 | 实物右列自上而下：VM、NC、GND、AO1、AO2、BO2、BO1、GND —— 注意 BO2 在 BO1 **上方**；VM 单脚要并线加粗，两处 GND 都接到 GND 网
U5A | DRV8833 #2 模块座 · 左列（控制/使能侧） | DRV8833 双 H 桥模块（16 脚，2×8，实测丝印） | 1x8 排母 2.54mm | 排母插座，模块直插；与 U5B 平行，列距按实测（默认 10.16mm） | 1 | 排母 1x8 2.54 | 1×8 2.54mm 排母；模块本体另购 | 同 U4A；模块丝印可能是 STBY 或 SLP，都接 DRV_STBY
U5B | DRV8833 #2 模块座 · 右列（电源/输出侧） | DRV8833 双 H 桥模块（16 脚，2×8，实测丝印） | 1x8 排母 2.54mm | 排母插座，模块直插；VM 与两处 GND 都要接 | 1 | 排母 1x8 2.54 | 1×8 2.54mm 排母；模块本体另购 | 同 U4B；BO1/BO2 到端子的接法见 MOTOR_RR_1/_2（镜像）
C1 | VM 储能电容 #1（紧贴 U4） | 铝电解 470µF / 16V | CAP-TH_D6.3xH11.0_P2.50 | 直插，紧贴 U4 的 VM-GND，丝印画 + | 1 | 铝电解电容 470uF 16V 直插 | 容量 ≥470µF，耐压 ≥16V，直插，脚距 2.5mm | 吸收马达启停的电流尖峰，距 U4 的 VM 脚 ≤5mm
C2 | VM 储能电容 #2（紧贴 U5） | 铝电解 470µF / 16V | CAP-TH_D6.3xH11.0_P2.50 | 直插，紧贴 U5 的 VM-GND，丝印画 + | 1 | 铝电解电容 470uF 16V 直插 | 容量 ≥470µF，耐压 ≥16V，直插，脚距 2.5mm | 同上；两块驱动各配一颗，不要共用
C3 | +5V 输出滤波电容 | 铝电解 100µF / 10V | CAP-TH_D5.0xH11.0_P2.00 | 直插，靠近 U1 的 OUT+ / OUT- | 1 | 铝电解电容 100uF 10V 直插 | 容量 ≥100µF，耐压 ≥10V，直插 | 抑制降压模块纹波，避免核心板复位
C4 | VM 高频去耦电容 | 瓷片 0.1µF（104）/ 50V | CAP-TH_D4.3xH11.0_P5.08 | 直插，跨在 VM-GND 上（与 C1/C2 并联） | 1 | 瓷片电容 104 0.1uF 直插 5.08 | 0.1µF，耐压 ≥25V，直插，脚距 5.08mm | 无极性，两脚可互换；负责高频噪声
C5 | +5V 高频去耦电容 | 瓷片 0.1µF（104）/ 50V | CAP-TH_D4.3xH11.0_P5.08 | 直插，跨在 +5V-GND 上 | 1 | 瓷片电容 104 0.1uF 直插 5.08 | 0.1µF，耐压 ≥25V，直插，脚距 5.08mm | 无极性
C6 | VBAT 输入储能电容 | 铝电解 100~220µF / 16V（推荐 220µF） | CAP-TH_D6.3xH11.0_P2.50 | 直插，靠近 J1 与两块 mini 的 IN | 1 | 铝电解电容 220uF 16V 直插 | 容量 ≥100µF（推荐 220µF），耐压 ≥16V，直插，脚距 2.5mm | 电池端电压会随大电流下拉，这颗负责兜底
J2 | 左前马达端子 FL | KF301-2P 螺钉端子（5.08mm，弯插） | KF301-2P | 板下边缘，接线口朝板外 | 1 | KF301-2P | 间距 5.08mm；可过 ≥2A；必须可插拔（换向靠拔线对调） | 丝印标 FL；_1/_2 只是两个脚，正负靠实际转向对调
J3 | 右前马达端子 FR | KF301-2P 螺钉端子（5.08mm，弯插） | KF301-2P | 板下边缘，接线口朝板外 | 1 | KF301-2P | 间距 5.08mm；可过 ≥2A | 丝印标 FR
J4 | 左后马达端子 RL | KF301-2P 螺钉端子（5.08mm，弯插） | KF301-2P | 板下边缘，接线口朝板外 | 1 | KF301-2P | 间距 5.08mm；可过 ≥2A | 丝印标 RL
J5 | 右后马达端子 RR | KF301-2P 螺钉端子（5.08mm，弯插） | KF301-2P | 板下边缘，接线口朝板外 | 1 | KF301-2P | 间距 5.08mm；可过 ≥2A | 丝印标 RR；本设计用**镜像接法**（BO2→脚1、BO1→脚2），与你面包板上跑通的方向一致，装车后若方向反了就整组对调
J6 | 舵机接口 SG90 | 1×3 直插排针 2.54mm | HDR-TH_1x3_P2.54 | 板右边缘，针朝上；杜邦线直插 | 1 | 排针 1x3 2.54 直插 | 1×3 2.54mm 直插排针 | 丝印标 S/V/G；舵机线序 黄(信号) 红(V) 棕(G)，插反必烧舵机，装配前核对
J7 | PS2 接收器接口 | 1×6 直插排针 2.54mm | HDR-TH_1x6_P2.54 | 板右边缘，针朝上 | 1 | 排针 1x6 2.54 直插 | 1×6 2.54mm 直插排针 | VCC 接 +3V3（不是 +5V）；若转接板只有 5 脚（VCC 与 GND 合并引出）则改按 5 脚座画，GND 仍接 GND
J8 | 调试扩展口（USART2） | 1×4 直插排针 2.54mm | HDR-TH_1x4_P2.54 | 板右边缘，针朝上 | 1 | 排针 1x4 2.54 直插 | 1×4 2.54mm 直插排针 | PA9/PA10 已被电机 PWM 占用，串口调试只能走 USART2(PA2/PA3)；接 USB-TTL 时 TX↔RX 交叉
