PoXiao-Team/CRTC_Smart_Car/hardware/pcb/design/out/布局坐标.csv

位号 | 名称 | X(mm) | Y(mm) | 旋转(°) | 所在区 | 封装
J1 | 电池/继电器输入端子 | 6.0 | 60.0 | 0 | 电源区 | KF301-2P
U1 | mini 降压模块 #1（+5V 路） | 24.0 | 62.0 | 0 | 电源区 | 1x4 排母 2.54mm
U2 | mini 降压模块 #2（VM 路） | 24.0 | 48.0 | 0 | 电源区 | 1x4 排母 2.54mm
U3A | STM32 核心板排母 · 左列（20 脚，自上而下） | 44.0 | 38.0 | 0 | 主控区 | 1x20 排母 2.54mm
U3B | STM32 核心板排母 · 右列（20 脚，自上而下） | 60.0 | 38.0 | 0 | 主控区 | 1x20 排母 2.54mm
U4A | DRV8833 #1 模块座 · 左列（控制/使能侧） | 62.0 | 56.0 | 0 | 驱动区 | 1x8 排母 2.54mm
U4B | DRV8833 #1 模块座 · 右列（电源/输出侧） | 72.0 | 56.0 | 0 | 驱动区 | 1x8 排母 2.54mm
U5A | DRV8833 #2 模块座 · 左列（控制/使能侧） | 62.0 | 38.0 | 0 | 驱动区 | 1x8 排母 2.54mm
U5B | DRV8833 #2 模块座 · 右列（电源/输出侧） | 72.0 | 38.0 | 0 | 驱动区 | 1x8 排母 2.54mm
C1 | VM 储能电容 #1（紧贴 U4） | 80.0 | 56.0 | 0 | 驱动区 | CAP-TH_D6.3xH11.0_P2.50
C2 | VM 储能电容 #2（紧贴 U5） | 80.0 | 38.0 | 0 | 驱动区 | CAP-TH_D6.3xH11.0_P2.50
C3 | +5V 输出滤波电容 | 36.0 | 64.0 | 0 | 电源区 | CAP-TH_D5.0xH11.0_P2.00
C4 | VM 高频去耦电容 | 80.0 | 48.0 | 0 | 驱动区 | CAP-TH_D4.3xH11.0_P5.08
C5 | +5V 高频去耦电容 | 36.0 | 56.0 | 0 | 电源区 | CAP-TH_D4.3xH11.0_P5.08
C6 | VBAT 输入储能电容 | 14.0 | 50.0 | 0 | 电源区 | CAP-TH_D6.3xH11.0_P2.50
J2 | 左前马达端子 FL | 10.0 | 6.0 | 0 | 接口区 | KF301-2P
J3 | 右前马达端子 FR | 27.0 | 6.0 | 0 | 接口区 | KF301-2P
J4 | 左后马达端子 RL | 44.0 | 6.0 | 0 | 接口区 | KF301-2P
J5 | 右后马达端子 RR | 61.0 | 6.0 | 0 | 接口区 | KF301-2P
J6 | 舵机接口 SG90 | 84.0 | 16.0 | 90 | 接口区 | HDR-TH_1x3_P2.54
J7 | PS2 接收器接口 | 84.0 | 26.0 | 90 | 接口区 | HDR-TH_1x6_P2.54
J8 | 调试扩展口（USART2） | 84.0 | 36.0 | 90 | 主控区 | HDR-TH_1x4_P2.54
