PoXiao-Team/CRTC_Smart_Car/docs/工程日志.md

# 工程日志

> 破晓战队 CRTC2026 参赛小车工程主日志。
> 按机器人设计进度的完成时间点从早到晚组织，一个机器人功能 = 一个板块；每个板块分「功能描述」与「开发历程」两段。各功能的详细设计见对应分册（机械篇 / 视觉篇 / 遥控与指令篇 / 硬件篇）。
> 状态标注约定：✅ 已完成（实测通过）｜🟡 进行中·未验证｜⬜ 待做。未实测内容显式标注【待实测】【待回填】，不以设计值冒充实测值。

---

## 总体方案设计（2026-09-19 ~ 10-07）

### 功能描述

参加重庆大学机器人训练大赛 CRTC2026（新生组）。赛制核心为资源争夺：在限定场地和时间内收集并携带道具（能量单元 / 能量核心），携带得分多者获胜（规则见《赛事规则解析》）。据此确定整车总体方案：

| 子系统 | 方案 | 支撑的比赛需求 |
| --- | --- | --- |
| 移动平台 | 四轮麦克纳姆轮底盘：前后、左右平移与原地旋转 | 快速接近场地各处道具 |
| 收集机构 | 前端舵机翻转铲：放平铲入 → 翻起兜住 → 倒入收纳区 | 使地面方块由"非携带"变为"携带"状态 |
| 收纳机构 | 中部阶梯式收纳舱，理论容量 12 块 | 结算得分只看比赛结束时仍处于携带状态的道具 |
| 主控 | STM32F103C8T6 开发板 | 电机、舵机、通信统一控制 |
| 遥控 | PS2 手柄（过渡期用电脑 + 有线/蓝牙链路） | 人工遥控实操（半自动组别） |
| 视觉（扩展） | 摄像头识别道具并解算坐标 | 为后续半自动/自动行为提供感知 |

### 开发历程

- **2026-09-19 建队**，确定参加 CRTC2026，初步分工为机械、电控/硬件两个方向。
- **2026-09-20 ~ 10-07 方案设计与分模块学习**：
  - 机械方向：学习 Fusion 360 制图、机架与结构设计、3D 打印与工程塑料；完成铲子件与支架件建模；打印一个镂空立方体样件（对应手册 30×30×30mm 能量单元）用于机构验证。
  - 电控方向：学习 GPIO/PWM、电机与舵机驱动、SPI 与 PS2 手柄通信、麦克纳姆轮运动学。
- **2026-10-14 团队信息补充**：队伍正式名称为**破晓战队（PoXiao-Team）**；成员分工如下（技术答辩用分工名单）：

| 成员 | 分工 |
| --- | --- |
| 王紫依 | 队长 / 机械 |
| 湛俊锋 | 电控 |
| 谭翔珂 | 电控 / 硬件 |
| 刘金昊 | 视觉 |
| 蓝朝棣 | 根据要求灵活调配 |

- **2026-10-18 双车方案定调**：按手册"每队自行设计开发 1–2 台机器人"的规定，确定 **1 号车继续使用铲子方案**（已实车跑通）、**2 号车采用机械臂方案**（新做，参考现成资料，见"第二台车：机械臂方案预研"板块）；两车互补参赛，具体战术分工待细化【待补】。

---

## 铲子收集机构设计与合规分析（2026-09-20 起）

### 功能描述

前端收集机构，把地面静止的 30×30×30mm 方块（约 11.29g）铲起并导入中部收纳区，使方块由"非携带"变为"携带"状态。约束条件（均来自手册，详见《赛事规则解析》）：

| 约束 | 数值 | 对设计的含义 |
| --- | --- | --- |
| 非尖锐物体（P7） | 不得携带/装配尖锐物体 | 铲板前沿与尖角必须钝化做大圆角 |
| 初始尺寸（P6） | 长宽 ≤290×195mm、高 ≤210mm | 铲子须可收拢或以非展开状态计入包络 |
| 结构强度（P7/P9） | 150–200mm（中期 180mm）跌落无零件掉出 | 外伸悬臂件需防断裂、防脱落设计 |
| 成本（P8） | 新生组整车 ≤400 元 | 驱动件复用官方物资（SG90 舵机） |

### 开发历程

- **方案选型（对比表与结论见《机械篇》）**：在多轴机械臂（结构复杂、耗时、效率低）、钩子机构（易抓脱）、铲子方案之间，结合初始尺寸限制与"高 40mm、长 255mm"的底盘条件，确定铲子方案。
- **V1 设计（水平舵机 + 护栏）**：舵机平放于铲子后端正中；铲面与底端做护栏、底端做斜面。推演发现：返回面过低导致可收集数目非常有限，且依赖"把方块推到墙面才能铲起"的工况，有翻转甩出风险 → 淘汰。
- **V2 设计（弧形滑坡 + 竖直舵机）**：斜状滑坡改弧形（省空间、利于方块下滑）；舵机由平放改侧立竖直放置；减薄铲体、加宽铲面、取消底端护栏、侧面做斜面 —— 降低操作手精度要求、提升容错率。V2 为当前主线方案。
- **舵机支架精细化设计**：预留 1–2mm 打印公差与舵机线缺口；执行"底盘 → 支架 → 舵机 → 铲子"装配顺序；支架连接处下沉处理，保证"铲子末端高度与地面重合"。
- **2026-10-11 结构分析与合规检查**（对 CAD 录屏与实物照片）：判定红色实拍件为舵机驱动翻转铲（V1 件）；识别出三个优先问题 —— 铲板前沿尖角触碰"尖锐物体"规定、件长与 290mm 初始尺寸的关系、外伸悬臂件的跌落强度风险；给出处理要求（前沿与尖角改 R3 以上圆角、可收拢设计、舵机轴加机械限位、实心填充 ≥40%）。
- **2026-10-18 装配取舍（临时过渡方案）**：3D 打印时间来不及 —— ① **铲子暂时沿用第一版（V1）打印件**，V2 改进（弧形滑坡 / 竖直舵机 / 圆角化）延期；② **装载方式以塑料箱平替**原设计的阶梯式收纳舱。两项均为临时过渡，第二版（中期考核后）分别替换为 V2 铲子与成品收纳舱，详见《机械篇》；打印前检查清单（7 项）见《机械篇》。
- **规则细节留档**：e8、d1 附属高台与焦点周围矮墙组内间距 31.5mm，方块 30mm 被限位、只能向上取出，侧推式铲子对这类方块无效（涉及至少 6 个能量单元）。不影响中期考核，影响正式比赛收集率；第一版机构不为其牺牲可靠性，列为后续迭代方向。

---

## 方块收纳舱设计（2026-09-20 ~ 10-07）

### 功能描述

在电池组、STM32、驱动板占据车体后部的前提下，尽可能多地收纳方块：理论目标 12 块（占全场 18 个能量单元的 2/3）。依据规则：只有对局结束时仍处"携带状态"（沿任意方向含上下都跟随运动）的道具才计分，因此收纳舱必须有挡板或锁止能力。

### 开发历程

- 针对铲入方块"最终停留位置不精准、易偏移堆叠"的问题，两层长宽均预留 10–20mm 余量，用容错设计保住理论容量。
- 最终采用"下窄上宽"阶梯式结构（详见《机械篇》）：下层错开车轮位置并预留车头舵机走线空间（4 块）；上层利用车轮上方空间横向扩展（8 块）。
- **2026-10-18 装配取舍（临时过渡）**：阶梯式收纳舱打印时间来不及，当前以**塑料箱平替**装载；第二版（中期考核后）再打印舱体替换，详见《机械篇》"当前实际"段。

---

## 底盘与行走机构组装

### 功能描述

四轮麦克纳姆轮底盘的实体搭建（金属折弯底盘 + TT 减速马达 ×4 + 60mm 麦轮），要求耐频繁碰撞震动、全向移动平稳。

### 开发历程（2026-10-05 ~ 10-07）

- 紧固件：底盘与 TT 马达组装选用 M3 内六角螺丝，配合垫片与弹片（弹簧垫圈）防松 —— 应对比赛场地碰撞震动导致的螺丝松脱。
- 麦轮按 **X 形**布局安装（X 形而非 O 形）：各方向受力更均匀、左右平移平稳，便于电控在运动学调控时精准实现平移与微调。
- 完成相关线材焊接与初步整理。
- 装机后的电机编号、转向符号、实测记录见《机械篇》与《硬件篇》待办（【待实测】）。

---

## 仓库与文档框架（2026-10-10 建立；2026-10-13 规范化改造）

### 功能描述

按手册 P10 建立仓储与文档体系：仓库名使用队伍名称英文/拼音；所有文档放入根目录 `docs/`；Markdown 格式；一个机器人功能一个板块。

### 开发历程

- **2026-10-10**：建立 GitHub 仓库 `PoXiao-Team/CRTC_Smart_Car`（Initial commit fb87bbe）；确定 docs/ 文档组织方式。
- **2026-10-11**：补充项目文档（competition-requirements、control-architecture 等）与机械设计日志。
- **2026-10-13 文档规范化改造**（对齐手册文档规范与质量标尺）：
  1. 视觉文档自 `View-Sense` 分支只取文件迁入 `docs/视觉篇.md`（该分支从 Initial commit 分叉、不含 main 的 docs，直接 merge 会误删全部文档，故禁止 merge）；View-Sense 分支保留为历史；
  2. 全部文档改造为"功能板块（## 功能名 + 功能描述 / 开发历程）"结构，并按设计进度从早到晚组织；
  3. 文件名统一为中文；新增《开源项目说明》；补 `.gitignore`；
  4. README 重写为导航版（导航、手册规范对照表、参数表、交付状态表）。

---

## 赛事规则提取（2026-10-11）

### 功能描述

把 23 页《2026CRTC 参赛手册 V1.5》转化为工程可用的规则基线：比赛任务、道具参数、场地地形、机器人技术规范、成本规范、中期考核要求、对局与违规规则，逐条标注页码，供各功能板块引用。（**10-19 已按手册 V1.6 升级**：赛程、指标措辞、进阶功能材料、淘汰赛规则等，见《赛事规则解析》§0 变更表。）

### 开发历程

- 通读手册全文并提取；产出《赛事规则解析》，维持设计风险清单（R1–R16）。
- V1.5 相对 V1.4 的 4 处影响判断的改动：
  1. 方块尺寸修正为 30×30×30mm（V1.4 中 30/40mm 表述不一致问题由官方解决）；
  2. 3.2 遥控器描述增加"或其他控制方案"（非 PS2 方案被明确允许）；
  3. 新增开源项目条款（中期考核须给出完整说明并遵守协议）；
  4. 通过名额调整为新生组前 60、非新生组前 4。
- 统一培训（10-08 ~ 10-11 共四晚，虎溪/沙坪坝）：电控四个板块 —— GPIO/PWM、电机与舵机及 FreeRTOS、SPI 与 PS2 手柄、麦轮运动学解算。

---

## 硬件清点与选型（2026-10-11，2026-10-14 更新）

### 功能描述

对照手册附录《CRTC 官方物资表》（合计 353.48 元）清点实物、辨认型号、确认缺失件、评估硬件兼容性，形成补购与供电决策依据。

### 开发历程

- **10-11 清点**：已确认 MB-102 面包板×2、DRV8833 红板×4、SG90 180°×4、杜邦线、18650 双槽充电器、主控型号 STM32F103C8T6（Micro 焊接款）；已确认缺失 PS2 无线手柄及接收器；其余（TT 马达、ST-Link、MG995、5V 降压、电池组、麦轮、底盘板）当时待确认。
- **兼容性初判**：DRV8833×2 可驱动 4 个 TT 马达（双通道）；MG995 与 STM32 共用 5V 支路存在拉低风险，电机与逻辑需分两条电源支路；全部模块必须共地。
- **供电方案（未决）**：在"2S 直供 7.4V / 降压到 6V / 直供加软件限速"三条路线中抉择，约束为"仅 1 个供电模块、额定 ≤7.4V、适配官方无线继电器"（三路线对比见《硬件篇》）。
- **10-13 ~ 10-14 更新**：TT 减速马达等已到货（底盘完成组装，见"底盘与行走机构"板块）；10-13 完成硬件引脚焊接与接线，实车已跑通；**PS2 手柄已到货、实车连接操控正常（10-14）**；**供电采用降压方案（对应《硬件篇》候选 B）并已带载运行**，降压模块与电压参数【待回填】。
- 详细清单、兼容性表与补购优先级见《硬件篇》。

---

## 遥控链路与指令层设计（2026-10-11）

### 功能描述

为底盘与机构提供可演进的操作链路，最终目标为 PS2 手柄遥控（满足中期指标 6、7）。核心设计：把操作指令抽象为统一结构体 `cmd_t`，只替换数据来源，下游麦轮解算与电机、舵机控制代码保持不变：

| 阶段 | 链路 | 用途 | 状态 |
| --- | --- | --- | --- |
| A | PC → USB-TTL → UART → STM32 | 桌面调试 | 🟡 方案已定，按需使用 |
| B | PC 蓝牙串口 → HC-05 → UART → STM32 | 无线演示 | ⬜ 降为备份（PS2 已可用） |
| C | PS2 手柄 → 接收器 → SPI → STM32 | 最终方案 | ✅ 实车连接操控通过（10-14） |

### 开发历程

- 因 PS2 手柄未到货，决定先用电脑操控把底盘和机构跑通；选择"定义统一指令层、替换数据源"而非"为电脑单独写一套控制"。
- **2026-10-14 实连验证**：PS2 手柄及接收器到货，实车连接成功、操控正常（底盘运动由 PS2 控制），阶段 C 链路按设计落地。
- 定义 8 字节定长帧协议（帧头 `0xAA 0x55`，vx/vy/w/buttons/保留/异或校验），UART 115200 8N1、50Hz。
- 失联保护列为必做项：200ms 无有效帧降速、500ms 立即停 PWM 进入 FAILSAFE（依据：手册"失控后果自负"与被判恶意冲撞将断电 20s 的判罚）。
- 两条边界：有线串口只用于开发调试，正式比赛必须切换无线（蓝牙或 PS2）；最终只能保留一套无线收发链路，切换时拆除另一套。
- 协议全文、按键映射、故障速查与阶段验收标准见《遥控与指令篇》。

---

## 视觉系统开发（2026-10-10 起）

### 功能描述

摄像头识别场地道具并解算坐标（PnP），经 ROS2 话题传给决策环节，为后续半自动/自动收集提供感知数据。采用"虚拟机 Ubuntu 22.04 + ROS2 + OpenCV"与"宿主机 Conda + YOLOv8"双环境分工架构。

### 开发历程

- 2026-10-10 视觉分支 `View-Sense` 建立；10-11 完成"视觉起步"与环境文档。
- 关键决策：虚拟机难以调用独显 CUDA（YOLO 推理严重掉帧），改为虚拟机跑 ROS2 节点与解算、宿主机跑 YOLO 推理、结果经 ROS2 话题回传（选型对比见《视觉篇》）。
- 已跑通：虚拟机 ROS2 + OpenCV 环境、宿主机 YOLOv8 训练与推理环境；自建数据集（交创中心拍摄 120+ 张照片，约 800 个目标实例），产出 `best.pt`。
- 未开始：摄像头硬件部署、跨机通信实测、PnP 联调、性能测试【待实测】。
- 2026-10-13 文档迁入：视觉文档由 `View-Sense` 分支迁入 `docs/视觉篇.md` 并重排；详细内容见《视觉篇》。

---

## 电控接线与固件实现（2026-10-12 ~ 10-19）

### 功能描述

完成全车电气连接（主控、驱动、舵机、供电、调试链路），并把"PS2 手柄 → 四麦轮移动 + 单舵机翻铲示教"的控制逻辑固化为 STM32 固件。**实车已于 10-14 跑通**；固件源码已入库（10-19，`firmware/CRTC2026_L1_Fast_Checked/`，89 项回归测试 PASS）。残余回填项（舵机角度、失联保护实车验证、电压与转向参数）见下表。

### 开发历程

- **2026-10-13 引脚焊接与接线完成**：完成硬件引脚焊接；STM32F103C8T6 主控、DRV8833 红板×2 驱动 4 个 TT 马达、SG90 舵机、供电与调试链路完成连接。接线明细见《接线规范篇》。
- **2026-10-14 实车跑通**：整车首次成功运行 —— 底盘四电机驱动正常；PS2 手柄及接收器连接成功、操控正常。
- **2026-10-18 固件"L1 快速版"**：底盘由"L1 慢速"改为**按住 L1 加速**（普通 50% → 75%）；**方向键优先**（按住方向键时右摇杆被强制忽略，不再叠加旋转）；舵机 600~2000 µs、10 µs/20 ms；新增 TIM2 微秒计时循环预算保护、看门狗前置启动（`HAL_Init` 后即启动）、复位 / 主循环 / 故障三个调试变量；CubeIDE 1.18.1 编译 **0 错 0 警**，89 项 ELF 指令级仿真检查 **PASS**。
- **2026-10-19 源码入库与操作口径核对**：Core 源码、tests、BUILD_INFO、build.ps1 入库 `firmware/CRTC2026_L1_Fast_Checked/`（不含 HAL 库与编译产物）；按代码更正操作手册三处（L1=加速、方向键优先、开机须按 START 使能）；确认**电机通道与实车映射**（PA6/PA8=左后、PA7/PA9=右后、PB0/PA10=左前、PB1/PA11=右前——与设计命名相反，固件以通道映射 + 横移反号补偿）。
- 剩余回填清单（对应手册 P9 基础功能指标）：

| 回填项 | 说明 | 当前状态 |
| --- | --- | --- |
| 底盘运动验证 | 前后 / 平移 / 旋转 | ✅ 实车跑通（10-14）；细分动作与参数【待回填】 |
| 电机转向与编号表 | M1–M4 方向与符号位记录 | 🟡 实车转动正常；固件通道映射已按实车接法补偿（10-19）；符号表待记录【待回填】 |
| 供电实测 | 电池串并联确认、满电/带载电压 | 🟡 实车带载正常；电压参数【待回填】 |
| 舵机角度范围 | 实测安全角度上下限 | 🟡 固件限幅 600~2000 µs（实测达不到 180°）；具体可达角度【待实测】 |
| 失联保护验证 | 拔线停车 | ✅ 代码实现：单帧无效立即停机 + 主循环 >100 ms 强制停机（严于 500 ms 设计目标）；实车拔线验证【待实测】 |
| 固件验证 | 编译与回归 | ✅ CubeIDE 1.18.1 0 错 0 警；89 项 ELF 仿真 PASS（10-18 / 10-19） |

### 固件实现要点（代码与参数）

工程 `firmware/CRTC2026_L1_Fast_Checked/`：HAL 库、无 RTOS、无外部晶振（HSI/2 × PLL16 = 64 MHz）。`Core/Src/main.c` 负责初始化（时钟 / GPIO / TIM / IWDG / 状态灯 / 故障处理），`Core/Src/robot.c` 负责业务（PS2 解析 / 四轮混控 / 电机输出 / 翻铲状态机）。详细技术说明见《遥控与指令篇》"嵌入式固件实现"板块。

| 资源 | 用途 |
| --- | --- |
| TIM1 CH1–4（PA8–PA11）+ TIM3 CH1–4（PA6/PA7/PB0/PB1） | 8 路 1 kHz PWM 驱动 4 个 TT 马达（每轮两输入） |
| TIM4 CH2（PB7） | 舵机 50 Hz PWM（CCR = 高电平 µs） |
| TIM4 CH3/CH4（PB8/PB9） | 预留第 2/3 路舵机，**输出恒为 0**（三舵机考核所需机构未做） |
| TIM2 | 1 MHz 微秒时基（PS2 软件 SPI 延时，带循环预算保护） |
| PB3/4/5/6 | PS2：ATT / CLK / CMD / DAT（软件 SPI，半周期 16 µs，模拟模式 0x73/0x79） |
| PB12 | DRV8833 nSLEEP/STBY（START 使能置高，停机拉低） |
| PC13 | 状态灯（快闪 = 无有效帧 / 慢闪 = 有帧未启动 / 常亮 = 已 START） |
| IWDG | 看门狗约 1 s，只在主循环喂狗 |

**电机通道与实车对应（与设计命名相反）**：PA6/PA8 = **左后**、PA7/PA9 = **右后**、PB0/PA10 = **左前**、PB1/PA11 = **右前**；固件以通道映射 + 横移反号（`x = -x`）补偿，实车方向正确。**PCB V2 装板时须按此映射核对电机接线。**

**控制参数**：普通 / 快速 PWM 上限 500 / 750 ‰（50% / 75%，按住 L1 加速）；右摇杆死区 ±18；PWM 斜坡每帧（20 ms）最多 40；换向先降 0 停约 40 ms；舵机脉宽 600~2000 µs（初始 1500 µs，步进 10 µs / 20 ms）；自动翻铲"铲下停 500 ms → 翻倒停 800 ms → 返回停 500 ms"；示教两点最小差值 50 µs。

**安全逻辑**：START 使能（连续 10 帧有效 + 摇杆回中 + 按键释放 + 新按 START）；R1 保持运行、松开即停；SELECT 软件停机 + 清示教；单帧无效立即停机并每秒重试配置；主循环间隔 >100 ms 强制停机；`Error_Handler` 先停机再等看门狗复位（`g_fault_tag` 记录故障类型）。

### 已知问题与限制

- 开环 PWM、无编码器：相同占空比不等于相同轮速；
- 仅 1 路舵机（PB8/PB9 预留输出 0），三舵机考核所需机构未做；
- 无电压 / 电流检测；此前"供电发热、黄灯灭后无响应"的根因**未确认**（BUILD_INFO 与《先看这里》均如实标注）；
- 电源异常（失去 3.3 V、短路、芯片受损）时程序与看门狗都无法保证恢复；软件 SELECT 不能代替物理断电。

---

## 硬件打板与 PCB 设计（2026-10-15 ~ 10-17）

### 功能描述

把面包板上验证过的接线固化为自制 PCB「载板」：STM32 开发板、2×DRV8833、2×DC-DC、PS2 接收器、舵机、4 个马达、电池全部经板载接口连接。三个目标：① 消除面包板接触不良（最常见的"跑着跑着复位"来源）；② 模块可拔换、引脚下错只改板不动模块；③ 对齐手册 P7"建议采用集成电路板、纯杜邦线易脱落"的结构规范。

| 关键节点 | 时间 | 说明 |
| --- | --- | --- |
| V1 原理图冻结（历史版本） | ✅ 2026-10-15 | 22 元件 / 29 网络；ERC 致命 0 / 错误 0 / 警告 0 / 信息 6 |
| V2 原理图完成 | ✅ 2026-10-17 上午 | 按模块分块自绘 + 审查修正 8 项；DRC 0 错 |
| V2 PCB 布局 + 布线 + 铺铜 | ✅ 2026-10-17 | 板框 100×70mm；双面铺 GND；飞线 0、DRC 0 |
| **Gerber 导出** | ✅ 2026-10-17 15:23 | 16 个文件齐全（铜箔/丝印/阻焊/板框/PTH+NPTH 钻孔/飞针） |
| **下单** | ✅ 2026-10-17 16:25（16:27 支付） | 订单编号 **Y1**；¥30.00 / 5 片（板费特价 20 + 品质赔付 10）；2 层 / 1.6mm / FR-4 / 1oz / 绿油白字 / 有铅喷锡；**48 小时免费加急，预计 10-19 晚发货**；顺丰电商标快 |
| 收板 / 焊接 / 装车 | ⬜ 10-20 ~ 10-22 | 10-19 晚发货 → 顺丰在途约 1–2 天，到货即按《接线规范篇》第 7 节上电验证、焊接装车 |
| 瑞士轮晋级赛 / 淘汰赛 | 2026-10-24、25、31 / 11-1（手册 V1.6） | PCB 为"争取项" |

> **保底策略**：面包板车保持完好、随时可跑；PCB 赶不上或板子有问题，即用面包板参赛、PCB 转赛后升级。

### 开发历程

**1）设计依据固化（上午）。** 把 10-14 实车跑通的接线整理为两份文档并入 `docs/`：《接线规范篇》（面包板物理规则、共地、电源树、逐件引脚表、冲突与坑、网络清单、上电验收流程）与《PCB打板篇》（零基础全流程教程：量尺寸 → 定接口 → 网络表 → 立创 EDA 原理图 → PCB → DRC → 下单）。

**2）实物核对（13:15 起，照片逐件核对，发现并修订多处）。**

| 件 | 假设 → 实测 | 影响 |
| --- | --- | --- |
| DRV8833 红板 | 2×6（12 脚）→ **2×8（16 脚）**（左列 NC/AIN2/AIN1/STBY/BIN1/BIN2/NC/GND；右列 VM/NC/GND/AO1/AO2/BO2/BO1/GND） | 母座改为 4×1×8；BO2 在 BO1 上方为调转向结果，不得"纠正" |
| DC-DC mini | 排针插接 → 四角焊盘（2×2，无插针） | 底板沿用 1×4 排母 + 焊线方案 |
| STM32 核心板 | 通用 Blue Pill → 非标准板（丝印为缩略名）；10-17 实测 **53×22mm**、两列排针中心距 **15.24mm**（0.6"） | 40 脚映射逐脚锁定（含 18 个 NC 脚）；排距与设计假设吻合 |

**3）V1 原理图设计与冻结（10-15）。** 设计数据采用单一数据源脚本 `crtc_baseboard_v1.py` 生成（BOM、网表、接线表、布局坐标、线宽预算、施工单、ERC 报告等产物），落图过程按"清场 → 电源区 → 连线命名 → 主控/驱动/接口 → 马达端子"关卡推进；**10-15 20:10 原理图冻结：22 元件 / 29 网络，ERC 0 错 0 警**（信息 6 条为位号格式建议，不改）。**注：此处为 EDA 检查口径；design/ 脚本的 ERC 另报 2 条 VM 路电流余量警告（W102/W103，见 `design/out/ERC报告.txt`），属已知供电风险，处置见《硬件篇》供电方案。**

**4）V1 转 PCB 受阻，转向 V2（10-15 晚 ~ 10-16 晚）。** V1 布局三轮调整仍不顺：① 设计坐标与 EDA 属性栏"中心坐标"参照系不一致，按表填必偏；② 右侧接口区空间不足（J7 长 15.24mm、预留间距仅 10mm）；③ mini 降压模块实物为四角焊盘（2×2、无插针），无法直插 1×4 排母。10-16 晚决定不再在 V1 上打补丁，**新建 V2 工程、按模块分块重绘原理图**（V1 保留为历史版本）。

**5）V2 原理图重建与审查（10-16 晚 ~ 10-17 上午）。**

- 建库：按实物自建三个符号——DRV8833（16 脚，左右列按实物丝印）、mini 降压（4 脚 IN−/IN+/OUT−/OUT+）、STM32 核心板（40 脚，用于插最小系统板）。关键结论：官方"开发板"器件不是裸芯片，正是"插最小系统板"的配套件——自制 40 脚符号成立的前提是自建 40 孔封装并关联。
- 审查发现并修正（截图逐项核）：+5V 与残留旧网名 VCC 短接（16 段无名网络为路过者）、两块驱动 VM 误接 +5V、前后驱动信号配对互换、DRV 右列 GND 脚误打 ×、电机两脚同名（H 桥输出短路）、舵机电源误接 +5V（应 VM）、PS2 前后顺序待实物锁版、中文位号报错（统一改英文字母+数字）。
- 口径确认（V2）：两块降压模块按**实物摆放编号**——模块1 = VM 路（供驱动 + 舵机）、模块2 = +5V 路（供核心板）；对应原理图位号 **模块1 ↔ U2（VM）、模块2 ↔ U1（+5V）**（位号沿用 design/ 脚本体系）。接线、装配、排错一律以**网络名（VM / +5V）与位号（U1 / U2）**为准，不单独使用"模块1/2"。
- 本版三处取舍：① **省略去耦电容 C1~C6**（成品模块自带小去耦、面包板未加亦跑通；风险：马达启停/舵机堵转瞬间可能复位，装车后视情况补）；② **不装马达端子 J2~J5**（马达线直接焊在 DRV8833 模块输出针上，换向靠拆焊）；③ 保留自制 40 脚核心板符号（对应自建封装）。
- 结果：原理图 DRC 0 错，转入 PCB。

**6）V2 PCB 布局与布线（10-17 12:00 ~ 14:32）。**

- 导入核对：40 焊盘核心板、4 焊盘降压模块、2×8 驱动、PS2/舵机/电源均在；布局分区（电源左上、核心板居中、驱动右下、接口右缘）。
- 布线：自动布线 100% 通，但全板线宽仅 10mil；**网络线宽规则面板未生效，改用"点中导线 → 选同网络 → 属性改线宽"** 收口——VBAT/VM 电源主干加粗到 **1.0mm（40mil）**、信号保持 10mil；修复 8 处间距错误。
- 板框与安装孔：板框由 103.97×70mm 收为 **100×70mm**（圆角 R3；嘉立创裸板报价 ¥39.64 → **¥20.00/5 片**）；四角 **M3 孔：孔径 3.2mm / 外径约 6mm / 距板边 3.8mm**（非金属化）。
- 铺铜：顶层 + 底层全铺 **GND**（焊盘十字热焊盘连接）；最终 **飞线 0、DRC 全部 0**。
- 过程教训（留档）：EDA 的 DRC 只查已有图形违规、**不查未布线/开路**——底部"未发现问题"不等于布通，判据是"飞线是否清零"；模块半透明填色叠加走线易被误判为"斜线"，应按图层面板核对；0.254mm 热焊盘辐条在 6px/mm 截图中仅约 1.6px，不能靠像素判断连接与否。

**7）Gerber 导出与下单（10-17）。** 导出 `Gerber_PCB1_2026-10-17.zip`（16 个文件：顶层/底层铜箔、丝印、阻焊、板框、PTH/NPTH 钻孔、飞针测试），已归档至 `hardware/pcb/CRTC2026_SmartCar_BaseBoard_V2/gerber/`。**当日 16:25 完成嘉立创下单、16:27 支付（订单编号 Y1）**：2 层 / 1.6mm / FR-4 / 1oz / 绿油白字 / 有铅喷锡 / 100×70mm / 5 片，过孔盖油、全部测试；**48 小时免费加急，预计 10-19 晚发货**（顺丰电商标快，运费 0）；实付 **¥30.00**（板费特价 20 + 品质赔付服务 10）。因加急发货在 10-19 晚，**中期考核（10-19 24:00）前无法收板——中期演示按面包板车执行**（保底策略见上）。

**8）设计数据入库。** 立创 EDA 工程与设计资料已并入本仓库 `hardware/pcb/`：V1 工程（历史）、V2 工程（当前，含 Gerber）、`design/`（V1 单一数据源脚本与产物）、`V2设计方案-实物对照版.html`（10-16 审查版设计依据：12 模块逐脚表 + 29 网总表 + 检查单）。

**关键口径留档（供固件与装配对齐）**：

- VM 设计值 **5.0V**（DC-DC 电机路输出；设 6V 时电池后半程压差不足会不稳压）；
- PB3/PB4 为 JTAG 复用脚，固件须关 JTAG 保 SWD（`__HAL_AFIO_REMAP_SWJ_NOJTAG()`），否则 PS2 通信失效；
- DRV8833 的 STBY 接 B12、不得悬空（悬空通道状态不确定）；
- TIM1 须使能 MOE（否则 PA8–PA11 无 PWM 输出）；TIM3 禁用部分重映射（否则 CH1/CH2 挪到 PB4/PB5 撞 PS2）；
- V2 板：100×70mm、M3 孔 6/3.2、板厚 1.6mm、2 层；马达线直焊驱动模块输出针（无端子）；本版无去耦电容；
- 待现场销项：①电池串并联（须 2S）②DRV8833 #1 的 VM 实际接点 ③DC-DC mini 型号/额定电流 ④TT 马达堵转电流（详见《接线规范篇》第 8 节与《硬件篇》）。

---

## 遥控操作与铲子示教（2026-10-17）

### 功能描述

PS2 手柄的完整操作方案（含铲子"示教-回放"），已实车验证并固化为队内操作手册（全文见《遥控与指令篇》"实际操作手册"板块）。两项关键设计：

- **R1 为移动使能键**：不按 R1 电机不驱动（松开即停），构成防误触安全线；L1 = 慢速修饰；SELECT = 停轮 + 关闭舵机控制脉冲 + 清除铲子位置记录；
- **铲子示教-回放**：L2/R2 点动调位 → □ 记录"铲下位置"、○ 记录"翻倒位置" → △ 一键自动翻铲（回位 → 翻倒 → 返回）→ × 取消；避免每次手动微调舵机角度。

| 功能 | 操作方式 | 状态 |
| --- | --- | --- |
| 底盘前后 / 横移 / 斜移 | R1 + 十字键（含相邻两键组合） | ✅ 实车可用 |
| 转向 / 边移边转 | R1 + 右摇杆左右；移动时同推右摇杆 | ✅ 实车可用 |
| 慢速 | 同时按住 L1 | ✅ 实车可用 |
| 停止 / 急停式停轮 | 松开 R1；SELECT（停轮 + 关舵机脉冲 + 清位置记录） | ✅ 实车可用 |
| 铲子示教与一键翻铲 | L2/R2 点动 → □/○ 记录 → △ 自动翻铲 / × 取消 | ✅ 实车可用（操作手册固化） |
| 舵机上电自动回正（装配基线） | 开机先回正 → 再装铲子作为初始位置 | ✅ 已确认 |

### 开发历程

- 10-11：指令层设计（`cmd_t`，初版位域为"△/○ = 铲子抬起/放下、L1 = 备用键"）。
- 10-14：PS2 实连，底盘操控跑通。
- 10-17：操作方案按实车手感锁定——移动收归"R1 + 十字键"（含斜向组合与右摇杆转向）、舵机改为 L2/R2 点动 + □/○/△/× 示教回放，形成操作手册（队内使用，评委可据此复现操作）。
- 装配约束（10-17 确认）：舵机上电自动回正——必须先开机等回正、再装铲子作为初始位置；每次开机自动回初始位置。
- **10-19 装机发现（已知问题）**：所用 SG90 舵机**实际行程达不到标称 180°（略小）**——铲子"铲下 → 翻倒"有效翻转角受限；操作侧按**实际可达位置**示教（□ / ○）即可，一键翻铲不受影响；但**"舵机运动（多项）"指标受此限制，中期视频中未完成**【待实测具体角度】。
- **10-19 固件核对（电控源码入库）**：按 `firmware/` 源码更正两处——① **L1 = 加速**（普通 50% → 按住 75%），非"慢速"；② **方向键按住时右摇杆被忽略**（方向键优先），不存在"边移动边转向"；另补"开机须先按 START 使能（LED 常亮）"。舵机脉宽 600~2000 µs 是"角度达不到 180°"的直接原因之一（软件限幅，非纯硬件缺陷）。

---

## 第二台车：机械臂方案预研（2026-10-18 起）

### 功能描述

按手册允许的"每队 1–2 台机器人"，在 1 号车（铲子，已实车跑通）之外新增 **2 号车：机械臂方案**。目标：用舵机驱动的多自由度机械臂 + 抓手完成道具抓取，与 1 号车形成互补；当前处于**资料收集与预研阶段**，尚未开始制作。

| 项 | 现状 |
| --- | --- |
| 方案思路 | 1 号车铲子 + 2 号车机械臂，双车互补参赛（具体战术分工待细化） |
| 参考资料 | 机械臂资料包（3MF 模型 / 组装图 / Arduino 参考代码 / 接线方案 / 常见问题）；钩爪设计台（机构与舵机设计模拟器） |
| 机械臂形态（据资料） | 4 舵机套件式：左右 / 前后 / 上下 / 抓手，2 路摇杆输入 |
| 状态 | ⬜ 预研（模型未打印、控制未移植、合规未核） |

### 开发历程

- **2026-10-18 资料收集**（两份资料存于工作区根目录，未入库）：
  - 《机械臂资料分享》：3MF 模型（3.2MB）＋ 组装图 PDF ＋ Arduino 控制参考代码（`arm_control1.0.ino`：4 舵机 + 2 摇杆 ADC）＋ 接线方案 ＋ 常见问题 ＋ 组装注意（黄铜管可用 3D 打印件替代；M3/M4 螺丝多备几种长度、批量采购）。
  - 《钩爪设计台》（HOOK LAB 2）：网页版二维机构 / 舵机实验室（内置 Planck.js 1.4.2 物理引擎，MIT），支持多杆件 / 关节 / 闭环设计、地面与墙面重力模拟、MG995 / SG90 舵机力矩与负载预估、关键帧动作编排——用于方案设计与舵机负载验证，不进入机器人本体。
- **方案判断**：参考资料为套件式机械臂（4 舵机 + 摇杆直控）；Arduino 参考代码仅作控制逻辑参考（摇杆映射、死区、平滑），若 2 号车沿用 STM32 主控，需重写并接入统一指令层（`cmd_t`）。
- **待办**：模型打印与组装 → 舵机选型（按负载核算 MG995 / SG90）→ 控制移植（STM32 + PS2 或独立摇杆）→ 合规核对（初始尺寸 ≤290×195×210mm、重量 ≤2.0kg、成本）→ 与 1 号车联调。
- **合规提示**：参考资料为外部来源（作者 / 许可【待核实】）；如直接使用其模型或代码，须在《开源项目说明》"参考资料登记"补齐来源与许可说明。

---

## 中期考核材料整理与核对（2026-10-19）

### 功能描述

中期考核（10-19 24:00 截止）材料集中整理与一致性核对：视频、图片、电控源码与文档仓库。材料目录 `D:/CQU/CRTC/中期考核/`（本地，未入库）。

| 材料 | 内容 | 核对结果 |
| --- | --- | --- |
| 演示视频 | **10 段 .mp4**（合计约 3 分 36 秒，帧率约 30 fps） | 内容逐段核对见下表；规格满足中期要求 |
| 整车照片 | 1 张直尺测量照（红色 V1 铲 + 蓝色舵机支架 + 竖直舵机 + 黄色麦轮） | 可用于"尺寸规范"指标佐证 |
| 电控工程 | `CRTC2026_L1_Fast_Checked`（CubeIDE 工程 + Core 源码 + 89 项回归测试） | **已入库 `firmware/`**（不含 HAL 库与编译产物） |
| 参赛手册 | **V1.6**（25 页，替代 V1.5） | 赛程 / 指标 / 提交方式有更新，文档已同步升级（见《赛事规则解析》） |

**演示视频内容清单（逐段抽帧核对）：**

| # | 时长 | 画面内容 | 对应指标 |
| --- | --- | --- | --- |
| 1 | 12.4 s | 整车在橙色地胶行驶 / 转向（蓝色底盘 + V1 铲 + 透明塑料箱） | 电机运动 |
| 2 | 77.1 s | 长镜头：车接近黄方块（能量单元）并铲取 / 携带 | 方块携带（单块） |
| 3 | 13.2 s | 车辆 + PS2 手柄同框（遥控操作） | 底盘运动（PS2） |
| 4 | 2.9 s | 桌面：车侧直立卷尺（高度测量） | 尺寸规范（高） |
| 5 | 4.4 s | 手持整车悬空多角度展示（结构 / 接线 / 麦轮） | 外形展示 |
| 6 | 14.5 s | PS2 手柄按 START 使能 + 遥控移动（手柄与车同框） | 底盘运动（PS2，含使能） |
| 7 | 18.3 s | 桌面舵机 / 舵机支架装配调试 | 装配记录 |
| 8 | 14.6 s | 多关节机械臂动作（教室设备） | 2 号车机械臂参考调研 |
| 9 | 2.4 s | 车局部特写（面包板 / 接线 / 底盘） | 外形展示（细节） |
| 10 | 54.2 s | 车侧地面横放卷尺（长度测量，约 200 mm 级） | 尺寸规范（长） |

### 开发历程

- **视频内容核对（逐段抽帧）**：10 段覆盖 外形展示（5、9）、电机运动（1）、底盘运动 PS2（3、6，含 START 使能与手柄同框）、方块携带（2）、尺寸规范（4、10）；另有装配记录（7）与 2 号车机械臂参考调研（8）。**未见「舵机运动（多项）」与「底盘运动（多个动作）」镜头**（与此前口径一致）；180 mm 跌落的落地画面未抽到——若在其他文件中，打包时须一并纳入【待确认】。
- **电控源码**：`Core/Src/main.c`（时钟 / GPIO / TIM / IWDG / 状态灯 / 故障处理）与 `robot.c`（PS2 解析 / 四轮混控 / 舵机状态机），连同《先看这里_L1快速与代码检查.md》、`build.ps1`、`tests/` 入库 `firmware/CRTC2026_L1_Fast_Checked/`；89 项 ELF 仿真回归全部 PASS。
- **手册 V1.6 关键变化**：① 赛程——瑞士轮晋级赛 **10-24、25、31**，车轮战淘汰赛 **11-1**（此前"10-23"口径作废）；② 完成度测评描述补充（外形"携带能量单元"、电机"≥4 个"、舵机"≥3 个且任意非初始状态保持"、结构稳定"展示车须与其他项目一致"）；③ 新增"进阶功能提交材料"（文档 + 视频，视频须展示文档所述功能，否则视为未完成）；④ 新增测评入口（i.kaoshiyun.com.cn）；⑤ 淘汰赛平局规则调整（平局双方均失败、积分 -0.5 等）。

---

## 当前进度总览与后续计划（截至 2026-10-19）

| 方向 | 当前状态 | 下一步 | 卡点 |
| --- | --- | --- | --- |
| 机械 | ✅ 装配完成（10-18：舵机支架 + V1 铲 + 塑料箱，临时过渡）；**中期视频已录制（10-18 晚）** | 补测尺寸/重量；V2 铲 / 收纳舱待第二版 | 3D 打印延期；**舵机行程不足 180°** |
| 电控 | ✅ 实车跑通（10-14）；**固件源码入库（10-19，89 项测试 PASS）** | 回填转向表、电压参数 | 供电发热 / 无响应根因未确认 |
| 遥控 | ✅ PS2 连接操控正常（10-14）；操作方案锁定（10-17，见"实际操作手册"） | 补验失联保护 | — |
| 视觉 | 🟡 软件跑通 | 硬件部署与联调 | 摄像头部署未开始 |
| 硬件打板 | ✅ V2 PCB 已下单支付（10-17，订单 Y1，48h 加急） | 等板（预计 10-19 晚发货、10-20 ~ 10-22 到货）→ 焊接装车 | — |
| 第二台车（机械臂） | ⬜ 预研（10-18 资料收集完成） | 模型打印 → 控制移植 → 合规核对 | 未开始制作 |
| 文档 | ✅ 9 篇体系 + `hardware/pcb/` 设计资料 | 回填实测数据 | — |

### 到中期考核（10-19 24:00）的行动清单

- [x] 实车试跑（2026-10-14 完成：底盘跑通 + PS2 操控正常）；
- [x] 接线规范整理与 PCB 原理图设计（2026-10-15 V1 冻结；2026-10-17 V2 完成）；
- [x] PCB 布局布线 + 铺铜 + Gerber 导出（2026-10-17 完成，板框 100×70、DRC 0）；
- [x] PCB 下单（2026-10-17 16:25，订单 Y1，¥30/5 片，48h 加急，预计 10-19 晚发货）；
- [x] **机械装配（10-18 完成）**：舵机支架构建 → 安装铲子（V1 件，临时过渡）→ 装载（塑料箱平替，临时过渡）；
- [x] **拍摄中期考核视频（10-18 晚录制完成，≥1080p、≥30 帧）**：除「舵机运动（多项）」「底盘运动（多个动作）」外，其余指标镜头均已完成；
- [ ] **中期材料打包提交（今日 10-19 24:00 截止）**；
- [x] 直尺测量初始尺寸并拍摄（10-18 视频，指标 8）；铲子尺寸与整机重量【待回填】；
- [x] 方块携带演示（10-18 视频，指标 9、10）；
- [x] 180mm 跌落测试（10-18 视频，指标 11）；
- [ ] 补拍「底盘运动（多个动作）」演示（10-18 视频缺项）；
- [ ] 补全「舵机运动（多项）」展示（受 SG90 行程不足 180° 限制，已在视频中缺项）与"任意非初始状态保持"设计（指标 5）；
- [ ] 收板后装配与上电验证（10-20 ~ 10-22，按《接线规范篇》第 7 节顺序）；
- [ ] 装车联调（替换面包板、转向校准、失联保护验证）；
- [ ] 回填转向符号表、舵机角度、失联保护、电压参数等实测数据；
- [ ] 视频打包、邮件提交（主题"队伍名称 队长姓名"+ 仓库地址）。

**中期考核之后（第二版，保留计划）**：打印 V2 铲子与阶梯式收纳舱，替换当前 V1 铲与塑料箱（见《机械篇》"当前实际装配 / 当前实际"两段）。

---

> 手册条款对照：本文满足手册要求——仓库规范 §2；文档规范 §2（按时间从早到晚）、§3/§4/§5（一功能一板块、板块结构、多板块组成）；质量标尺 §1（选型对比、难点与迭代）、§2（构思到实现全过程）、§3（未实测显式标注）。
