PoXiao-Team/CRTC_Smart_Car/(commit log)

2026-10-11 补充 CRTC2026 项目文档与控制方案
    完善 README 文档索引与项目现状说明，新增赛事规则、硬件清单、结构分析、遥控架构和开发日志，为中期考核、硬件采购及分阶段联调提供依据。
2026-10-11 Add mechanical design log for CRTC Smart Car
    Document the mechanical design process for CRTC Smart Car, including iterations of the scoop mechanism, space optimization for block storage, and assembly of the chassis and movement mechanisms.
2026-10-13 docs 归位：视觉文档自 View-Sense 分支仅取文件迁入 docs/视觉篇.md（该分支从 Initial commit 分叉，merge 会误删 main 上 6 篇 docs，故不 merge）；按手册板块结构重排；README 同步重写为导航版，移除'见分支看视觉'过时指引
2026-10-13 命名统一：docs 文件名统一为中文风格（development-log→工程日志、control-architecture→遥控与指令篇、hardware-inventory→硬件篇、competition-requirements→赛事规则解析、机械设计日志→机械篇）。原来中英混用，与内容语言和中文评审场景不一致；全部使用 git mv，重命名历史保留
2026-10-13 文档板块化：全部文档改为'功能 H2 + 功能描述 + 开发历程'结构，对齐手册文档规范与质量标尺；《机械设计日志》与《3D 打印结构分析》合并整编为《机械篇》（选型对比、合规检查、打印前清单全部保留，原结构分析文件移除）；《工程日志》升级为主日志，补入电控接线最新进展与【待实测】回填清单
2026-10-13 新增开源项目说明：按手册 V1.5 逐项登记开源引用（项目名/作者/链接/许可证/改动说明），并按'自行编写、参考原理、直接安装使用、工具链'四类归档；不确定信息标注待核实，不编造
2026-10-13 新增 .gitignore：管住 ROS2 构建产物（build/install/log）、Python 与 YOLO 训练输出（runs/、__pycache__）、编辑器与 CAD/EDA 临时文件，大文件走外链策略（见 README），防止误提交
2026-10-14 进度更新：实车首次跑通、PS2 手柄连接操控正常（10-14）。工程日志补入实车调试进展与回填清单（底盘/电机运动转 ✅）；遥控篇阶段 C 转实连通过；硬件篇补 PS2 到货与带载运行；README 更新里程碑、技术栈与交付状态表；开源说明更新 PS2 到货——未验证项（舵机角度、失联保护、电压参数）保留【待实测】标注
2026-10-14 团队与硬件信息补充：确认队伍正式名称'破晓战队'及成员分工（写入工程日志，供技术答辩）；供电方案确认为降压路线（候选 B，硬件篇/工程日志/README 同步更新）；补记 10-13 硬件引脚焊接进展
2026-10-14 小车实测补充
2026-10-15 进度更新：硬件打板——原理图完成并冻结（10-15，22 元件 / 29 网络，ERC 0 错 0 警）
    - 新增《接线规范篇》《PCB 打板篇》并入 docs/（文档体系共 9 篇）；立创 EDA 工程与设计产物（约 320KB）入库 hardware/pcb/
    - 《工程日志》新增'硬件打板与 PCB 设计'板块：实物核对修订（DRV8833 16 脚、核心板 40 脚映射）→ 原理图冻结 → 转 PCB 布局；修复被旧副本覆盖的团队实名名单、底盘组装时间（10-05~10-07）、引脚焊接与降压细节
    - README 更新 9 篇导航与硬件载板状态；硬件篇补实物核对结论（v6）；遥控篇接线明细指向《接线规范篇》
    [BOM.csv, NETLIST.csv, 布局坐标.csv]
2026-10-17 进度更新（10-16 ~ 10-17）：PCB V2 设计完成并导出 Gerber（100×70mm，DRC 0）
    - 工程日志'硬件打板'板块扩展为 10-15~10-17 全程：V1 布局受阻 → V2 重画原理图（8 项审查修正、核心板 53×22 实测）→ 布局/布线/铺铜（电源主干 40mil、双面 GND、DRC 0）→ Gerber 导出；补过程教训与 V2 取舍（无端子直焊、省略电容）
    - V2 工程 + Gerber 包（16 文件）+ 自建元件库 CRTC.elib + V2 设计方案入库 hardware/pcb/；README 标注 V1 历史 / V2 当前
    - 进度总览与行动清单更新至 10-17：当前阶段=Gerber 完成待下单（10-18 中午死线），剩余待办列明
    - .gitignore 为 Gerber zip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
2026-10-17 新增操作手册：PS2 操作映射与铲子示教回放（2026-10-17 锁定）
    - 《遥控与指令篇》新增'实际操作手册'板块：底盘移动（R1+十字键/斜移/右摇杆转向/L1 慢速/松开即停/SELECT 停轮清位）、铲子示教-回放（L2/R2 点动 → □/○ 记录 → △ 一键翻铲 → × 取消）、舵机上电回正与装配时序
    - 初版指令映射（10-11 cmd_t 位域）加注'以实际操作手册为准'；过渡期电脑映射保留为历史
    - 《工程日志》新增'遥控操作与铲子示教'板块（功能表 + 开发历程 + 装配约束）；进度总览遥控行更新
    - 《机械篇》铲子装配顺序补充'舵机回正后再装铲子'；R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
2026-10-18 新增双车方案与机械臂预研（10-18）：1 号车铲子 + 2 号车机械臂
    - 工程日志'总体方案设计'补双车方案定调（手册允许 1–2 台）；新增'第二台车：机械臂方案预研（2026-10-18 起）'板块：资料清单（机械臂资料包 / 钩爪设计台）、方案判断、待办、合规提示
    - 今日任务（10-18）写入进度总览与行动清单：舵机支架构建 → 安装铲子 → 安装装运台；拍摄中期考核视频（10-19 24:00 截止）
    - 开源项目说明新增'参考资料登记'：机械臂资料包 / 钩爪设计台（内置 MIT 的 Planck.js）/ MakerWorld 摇杆底座——作者与许可待核实，明确 2 号车制作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
2026-10-18 进度更新：PCB 已于 10-17 下单（¥20/5 片，等板中）
    - 工程日志：关键节点'下单'→ ✅ 2026-10-17；开发历程补下单记录（常规交期 3–5 天，预计 10-20 ~ 10-22 到货）；进度总览与行动清单同步（订单号待回填）
    - 硬件篇 / hardware README / 项目 README：状态统一为'已下单、等板中'
2026-10-18 补 PCB 订单信息：订单 Y1，10-17 16:25 下单/16:27 支付，¥30/5 片，48h 加急
    - 工程日志：关键节点表补订单号、下单/支付时间、加急与预计发货时间；7）段落完整记录订单工艺与实付金额（¥30 = 板费特价 20 + 品质赔付 10）；进度总览与行动清单同步
    - 硬件篇 v8、hardware/pcb/README、项目 README 同步
    - 关键提示：48h 加急预计 10-19 晚发货——中期考核（10-19 24:00）前无法收板，中期演示按面包板车执行
2026-10-18 docs: 统一赛程、电源位号与 V2 取舍口径（仓库审计批次 A）
    - P01 赛程：README 改为队内更正口径（10-23）；《赛事规则解析》保留手册原文并加更正注（双口径并存，保留引用基准）
    - P02 电源位号：明确'实物模块1/2 ↔ 原理图 U2/U1 ↔ 网络 VM/+5V'完整映射（工程日志 + 接线规范双注，认网络名不认编号）
    - P03/P04 V2 取舍：接线规范补注'不装马达端子（直马焊）''省略去耦电容'（教程原则保留，标注实际取舍）
    - P11 到货窗口统一 10-20~10-22；P14 成本注明物资表含两车量；P21 场地 a4/h5 重叠加注待核实
2026-10-18 docs: 修正供电/电流口径与状态标注（仓库审计批次 B）
    - P05 ERC 双口径：注明 EDA 检查（0 错 0 警）与 design/ 脚本 ERC（W102/W103 电流警告）分属两套工具
    - P06/P07 线宽与电流：接线规范/hardware README 标注 V2 实际（1.0mm 主干/双面铺铜）；电机路 DC-DC 统一为'额定 ≥3A 门槛、≥5A 更稳'
    - P09 供电模块定义补本队解释口径（标待核实）；P12/P13/P15 硬件篇拆层表述（降压模块在用/缺件、SG90 定案、舵机挂 VM）
    - P16 buttons 位域标'未按此实现'；P31 README 舵机状态拆层（操作 ✅ / 机构联调 🟡）
2026-10-18 chore(pcb): 同步 V1 设计脚本与产物口径（仓库审计批次 C）
    - P08 线宽预算：'选型确认前不要下单'改为历史记录，注明 V2 已下单（订单 Y1）
    - P47 装配核对表：U3.5V → U3A.5V（位号规范）
    - P55 脚本常量注释：1.8A 为假设额定，与 BOM ≥2A/对策 ≥3A 性质不同
    - P56 脚本 docstring 补第 8 个产物（施工单.html）
    - 重跑验证：exit=0，仅 2 产物按预期变化，其余 5 产物逐字节一致
2026-10-18 docs(pcb): 标注教程与 V2 实际差异、补 V2 产物缺口说明（仓库审计批次 D）
    - P17/P18/P19 《PCB打板篇》：DRV 母座改 1×8×2（实测 16 脚）、追加 V2 版本更新注（100×70/无电容/无端子/1.0mm）、SWD 未引出标注
    - P20 V2 设计方案 HTML 头部加'10-16 审查版/最终取舍以工程日志为准'警示 tag
    - P22 教程成本交期对照实际值（¥30/5 片、运费 0、48h 加急）
    - P34 hardware README 标注 V2 配套产物缺口（design/ 为 V1 口径，收板装配不可照抄）
    - P49 hardware README 目录表补工程子目录与 eprj3-intro 说明
2026-10-18 docs: 考核状态、成本表与 README 结构修正（仓库审计批次 E）
    - P24/P10 README：指标 12 改 🟡（成本表未完成）、指标 5 补计划路径（2 号车机械臂 4 舵机 / 1 号车加装，待定）
    - P35 硬件篇：建立极简整车成本表（已知 ¥353.48 物资表 + ¥30 PCB，其余待回填）
    - P36 视觉代码与指标 6/7 替代路径：README/视觉篇补'给出相关代码'佐证说明
    - P23/P39 入库体积更正 320KB→约 4MB（25 文件）；P48 目录树展开 hardware/pcb；P29 导航补 hardware README
    - P44 规范对照表区分'功能文档 vs 资料/教程类'；P25 接线表指向修正；P26 书名号统一；P27 fishros https；P41/P42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
2026-10-18 chore: 销项已核实项并补忽略/LFS 规则（仓库审计批次 F）
    - P32 LabelCreator 许可核实为 MIT（上游 LICENSE），待核实清单 #3 销项
    - P33 接线规范 §8 销项：C3（16 脚无 VCC）、C4（3.3V 已跑通）、C6（53×22/15.24 实测）、C8（SG90 180° 确认）
    - P38 新增 .gitattributes：*.stl/*.step/*.stp/*.3mf 走 Git LFS（README 承诺落地）
    - P51/P52/P54 .gitignore 补 *.pt、state/、*.epro2
2026-10-18 chore: 复查收尾——统一堵转电流口径与教程线宽内联标注
    - 堵转口径统一：4×TT ≈ 5A（估算，待实测）+ SG90 0.5A ≈ 5.5A 峰值（接线规范 §4.2/§5.2、硬件篇供电 B 行三处一致）
    - PCB打板篇 §6.4 取值建议补'V1 教程口径 / V2 实际 1.0mm 主干'内联标注
    - 交叉复查 15/15 项通过，未发现新增矛盾
2026-10-18 docs: 记录机械临时过渡方案（V1 铲沿用 + 塑料箱装载）
    - 《机械篇》铲子：新增'当前实际装配（2026-10-18）'——V1 件沿用、V2 改进延期（原因：3D 打印时间来不及）+ 第二版替换计划（弧形滑坡/圆角 R3+/改模打印）
    - 《机械篇》收纳舱：新增'当前实际（2026-10-18）'——塑料箱平替；已知不足（限位/固定可靠性/重量）+ 第二版替换计划（打印阶梯舱、复核 12 块容量）
    - V1 标题与结论同步标注'设计已淘汰、实物临时沿用'；功能描述表状态注
    - 《工程日志》：铲子/收纳舱板块各加'10-18 装配取舍（临时过渡）'；进度总览与行动清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
2026-10-18 进度更新（10-19）：中期视频录制完成；记录舵机行程不足 180° 的已知问题
    - 中期视频（10-18 晚）已录制：除「舵机运动（多项）」「底盘运动（多个动作）」外，其余指标镜头均已完成
    - 新发现已知问题：SG90 实测行程达不到 180°（略小）——铲子有效翻转角受限；示教按实际可达位置记录、一键翻铲不受影响；「舵机运动（多项）」因此未完成（硬件篇/机械篇/遥控篇/工程日志四处记录）
    - 指标状态拆层：舵机运动 单个✅/多项⬜；底盘运动 单个✅/多个动作镜头⬜（待补拍）
    - 进度总览更新至 10-19；行动清单勾选装配与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
2026-10-19 仓库升级（10-19）：电控固件源码入库 + 中期材料核对 + 手册 V1.6 规则同步
    - 电控源码入库 firmware/CRTC2026_L1_Fast_Checked（Core 源码 + tests + BUILD_INFO + 构建脚本；不含 HAL 库与编译产物）；《遥控与指令篇》新增'嵌入式固件实现'板块（资源映射/电机通道实物对应/控制参数/安全逻辑/已知限制）
    - 按固件更正操作手册：L1=加速（50%→75%）、方向键优先（不支持边移边转）、开机须先按 START 使能；补电机通道与实车映射（PA6/PA8=左后…，与设计命名相反）
    - 中期材料核对：视频 10 段（5 段 720p 不满足 ≥1080p【待处理】）、整车直尺照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
2026-10-19 中期材料核对更新（10-19）：视频逐段内容分析 + 指标状态落定
    - 工程日志材料核对板块：新增'演示视频内容清单'（10 段逐段画面内容与指标对应：外形/电机/底盘PS2/方块携带/尺寸/装配记录/机械臂参考）；删除分辨率误报（QQ 传输转码所致，原始素材正常）
    - README 指标表：外形展示 / 尺寸规范 / 方块携带 / 结构稳定性 → ✅（10-18 视频证据）
    - 行动清单：尺寸拍摄、方块携带、180mm 跌落勾选；铲子尺寸与整机重量保留【待回填】
2026-10-19 工程日志：电控板块按固件代码扩展（2026-10-12 ~ 10-19）
    - 板块更名'电控接线与实车调试'→'电控接线与固件实现（2026-10-12 ~ 10-19）'
    - 开发历程补：10-18 固件 L1 快速版（50%→75%、方向键优先、TIM2 保护、IWDG 前置、0 错 0 警、89 项 PASS）；10-19 源码入库 / 操作口径核对 / 电机通道实物映射
    - 回填清单更新：失联保护=代码实现（单帧即停，严于 500ms）、舵机角度=600~2000µs 限幅、新增'固件验证'行
    - 新增'固件实现要点'（资源映射表 / 电机通道对应 / 控制参数 / 安全逻辑）与'已知问题与限制'两节——与硬件打板板块同规格
2026-10-19 进度更新（10-19），视觉组代码
2026-10-19 Refine code structure details in 视觉篇.md
    Updated code structure descriptions for clarity and consistency.
